kitahei88/SKGC-for-MZ-80B/8255_ATmegaX8/FUSE.md

## AVRのFUSE設定

**ATmega328p FUSE : Low, High, Extended.**
FUSES = {0xEE, 0xD9, 0xFF};		

```
Low
    CKDIV8      1       clock divide disable
    CKOUT       1       clock out disable
    SUT         10      high speed rising
    CKSEL       1110    Ext Crystal Osc.; Freq 8.0- Mhz; Start up time PWRDWN/RESET: 1K CK /14 CK + 0ms;

High
    RSTDIBL     1       PC6 to reset
    DWEN        1       Debug wire disable
    SPIEN       0       SPI programing enable
    WDTON       1       WDT disable
    EESAVE      1       EEPROM is erasable
    BOOTSZ      00      Boot loader size set to 2048 words :: default
    BOOTRST     1       Reset vector set to application section
Ext
    7~3         not use (set 1)
    BODLEVEL    111     Brownout reset disable	
```

**外部にXtalオシレーターを使用するため、書き込みはExtended, High, Lowの順で行うこと**
