kitahei88/SKGC-for-MZ-80B/Doc/ModeOut.md

# モード出力の設定について

現在のモードもしくは切り替えスイッチの出力を外部に出力するための設定を用意しています。
J6と書かれた2PinのXHコネクタで1ピンがGND、2ピンに状態が出力されます。
MZ-2000のモードでL（GND）、MZ-80BのモードでH（+5V）が出力されます。

この出力される内容はPL3と記載されたジャンパで出力する状態を変更します。
PL3をSW側と中央をショートした場合、スイッチの状態が出力されます。
つまりIPL動作、メインRAMでのブート中などに関わらず、スイッチで指定したモードの状態が出力されるということです。

逆にPL3をB/_2000側でショートした場合、IPLの設定とIPL中かメインRAMの動作中かにより、出力される状態が変化します。
MZ-2000にスイッチを設定し、IPLはMZ-80Bで起動した場合、IPL中はMZ-80BとしてHが出力され、メインRAMに動作が変更した後はMZ-2000としてLが出力されます。
IPLをMZ-80BとMZ-2000との両方を切り換えるものとした場合は、上記したようなスイッチの出力がそのまま出力されることになります。

主にyanatakaさんのSDカードブートするものを使うことを想定ています。
ですので具体的には
#### 1. IPLはMZ-80Bのもので、起動後にMZ-2000、MZ-80Bが切り替わる設定（BIOSにMZ-2000などを用意しない場合）

IPLの設定はオープン、モード出力の設定はB/_2000側をショートの状態とする
yanatakaさんの基板、ブートROMとしては、Rev4.3以上のもの（スイッチで27C512
のA15を切り換えることができるもの）とブートROMとして27C512を使用。

ブートROMのイメージとしては、MONITORは何れもMZ-80Bの改造したもの。
その後ろにつけるバイナリは、1つはEXT-ROM_SD MZ-2000.bin、もう一はEXT-ROM_SD MZ-80B.binとする
下位はMZ-2000.binを用意したもの、上位はMZ-80Bを用意したものとして27C512書き込む。

切り替えスイッチの出力にこの状態でモード設定の出力を入れる

#### 2. IPLをMZ-80B、MZ-2000のものをそれぞれ用意した場合

その場合はIPLの設定をショートにてして、モード出力はSW側とします。
そしてSDカードのローダー側は通常の場合と同様にMZ-2000のものとMZ-80Bのものを用意し、下位はMZ-2000、上位はMZ-80Bのもので作成したバイナリを27C512に書き込んで使用します。

モードの入力する方法は１と同様です。
