kitahei88/SKGC-for-MZ-80B/Doc/images/TC9121P/TC9121P_5.jpg

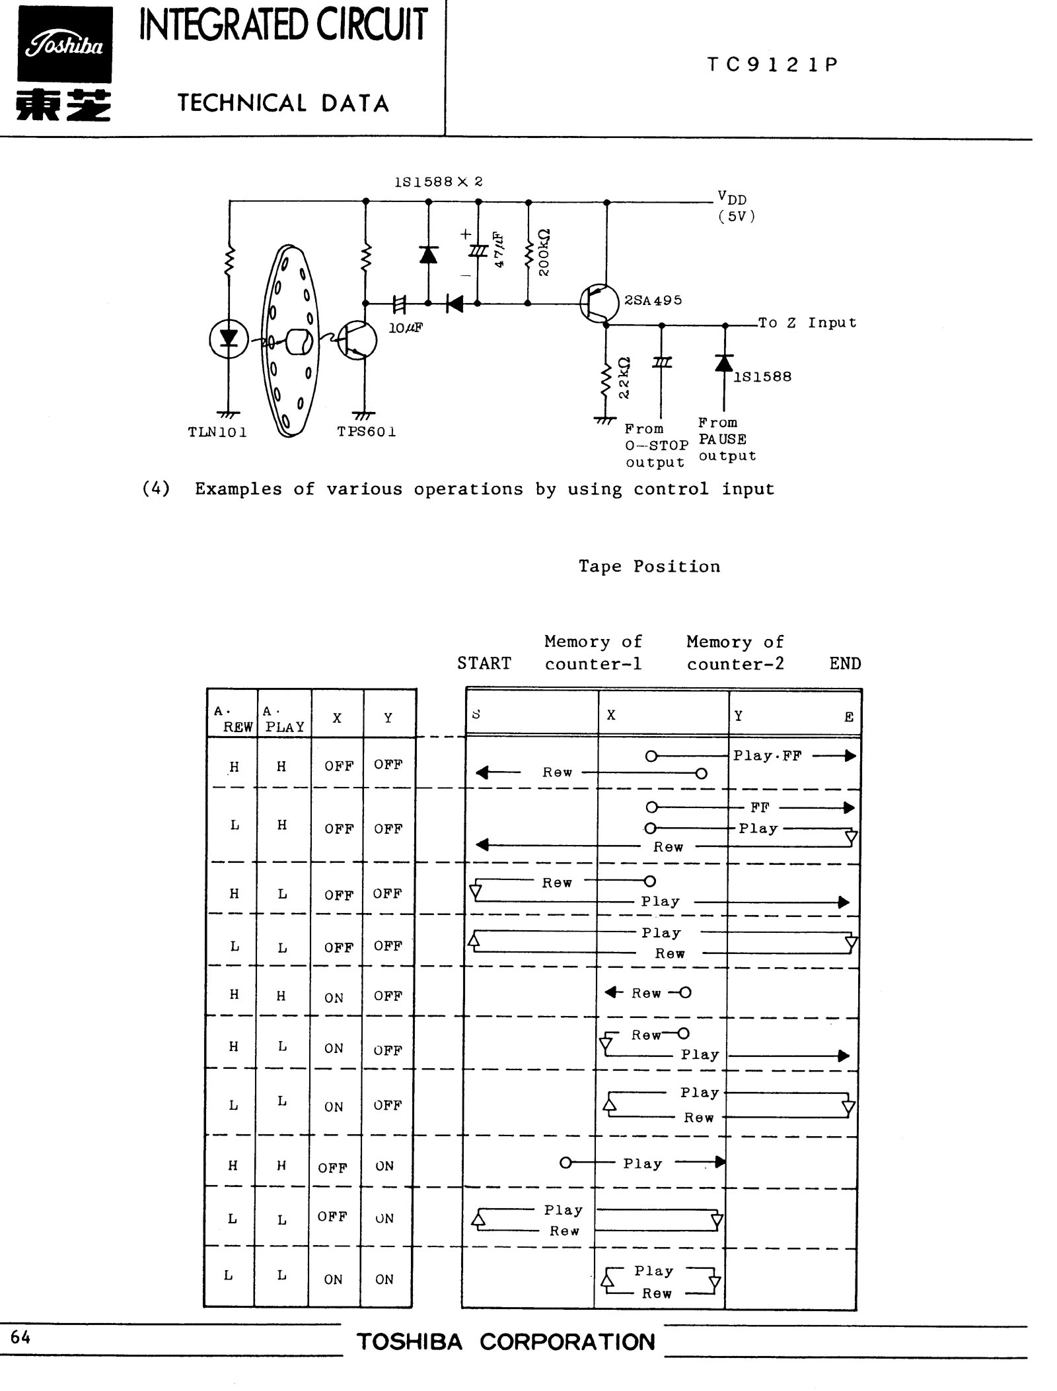
Doc/images/TC9121P/TC9121P_5.jpg
