kitahei88/SKGC-for-MZ-80B/Doc/HowToInstall.md

# 取り付け方法 
頒布したセットの取り付け方法を記載します。画像はクリックすると別タブで大きい画像で表示されます。

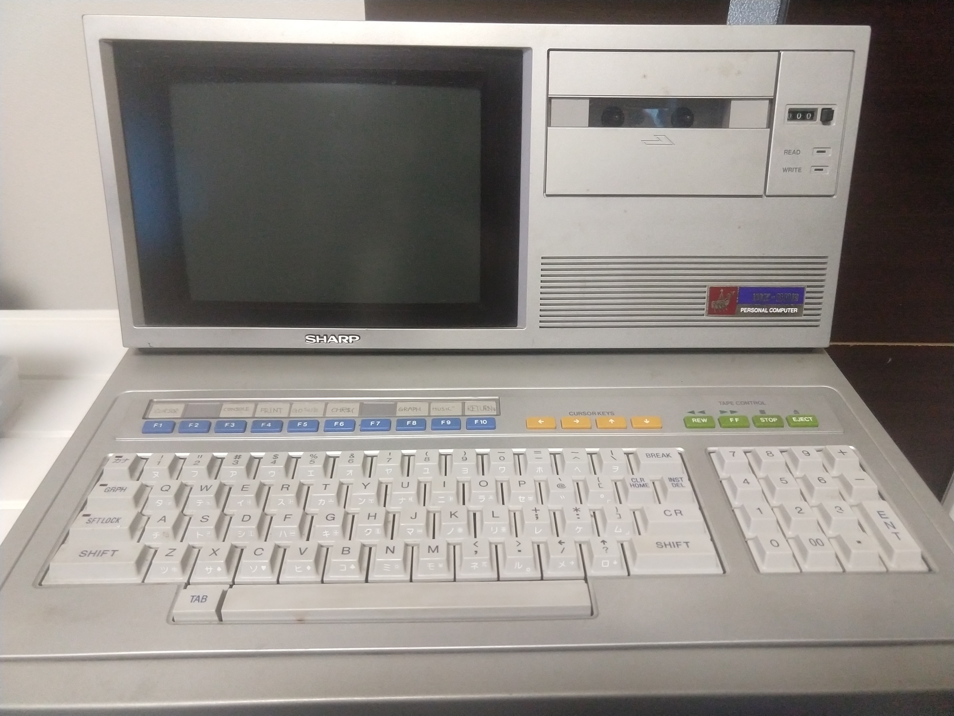
[picture p10: Doc/images/1.jpg]


まずMZ-80B本体の電源を確実に切り、電源ケーブルを外してください。

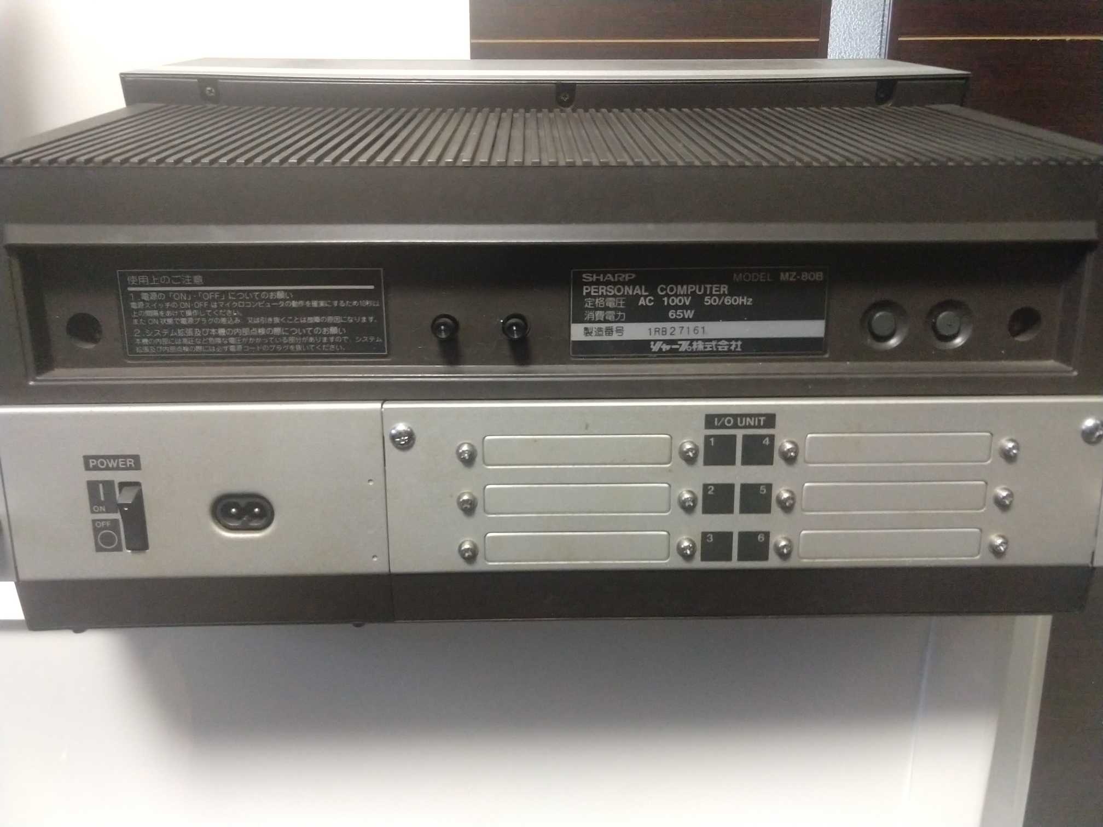
[picture p11: Doc/images/2.jpg]


次に背面二ヶ所のネジを外し、CMTとモニター部分を上方へ押し上げ、本体をあけます。

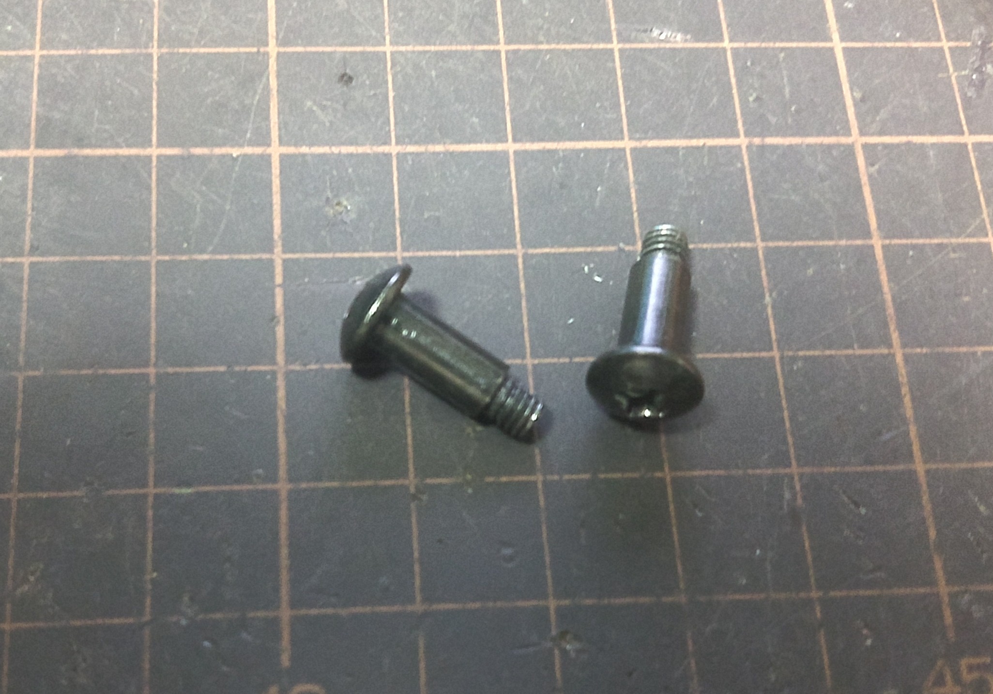
[picture p12: Doc/images/3.jpg]
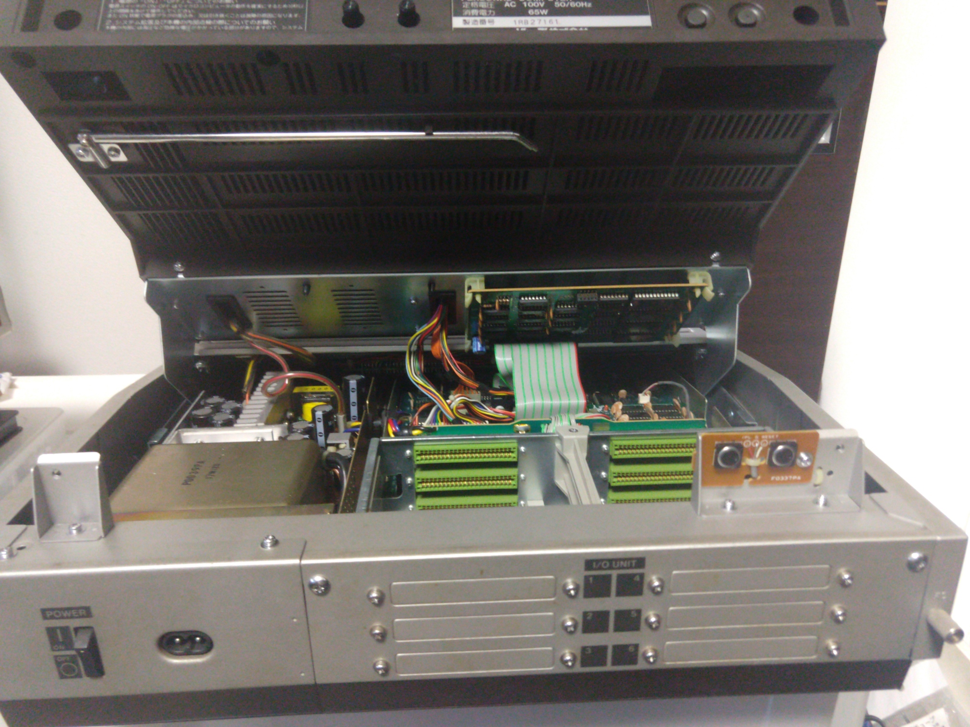
[picture p13: Doc/images/4.jpg]


CMTとモニター部分のカバーを5箇所のネジを外して開けます。

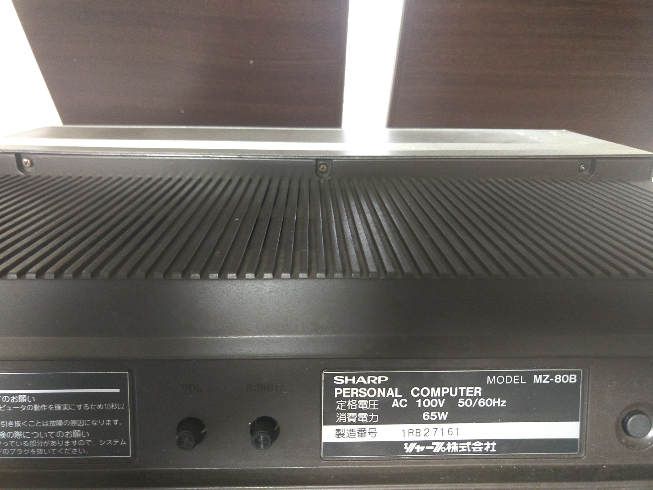
[picture p14: Doc/images/5.jpg]
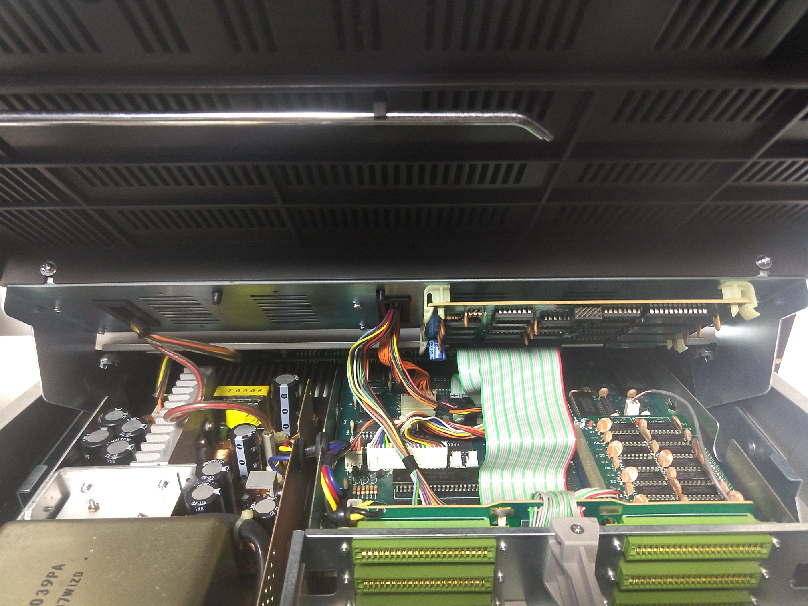
[picture p15: Doc/images/6.jpg]
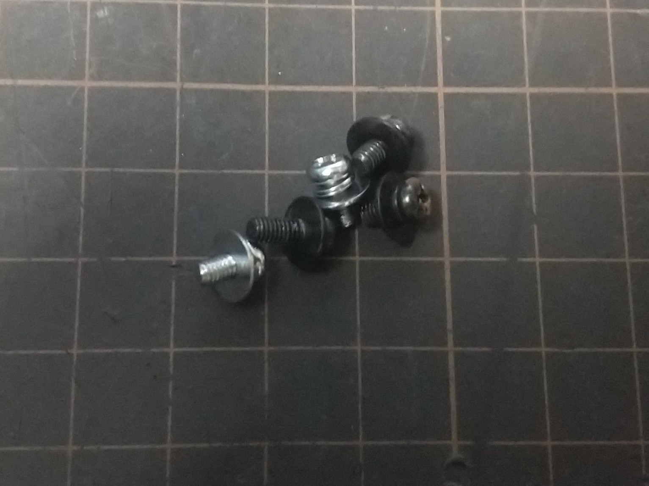
[picture p16: Doc/images/7.jpg]


この際、モニター周囲は高圧が掛かっている可能性が高く、注意してください。最悪、指に穴が空きます。

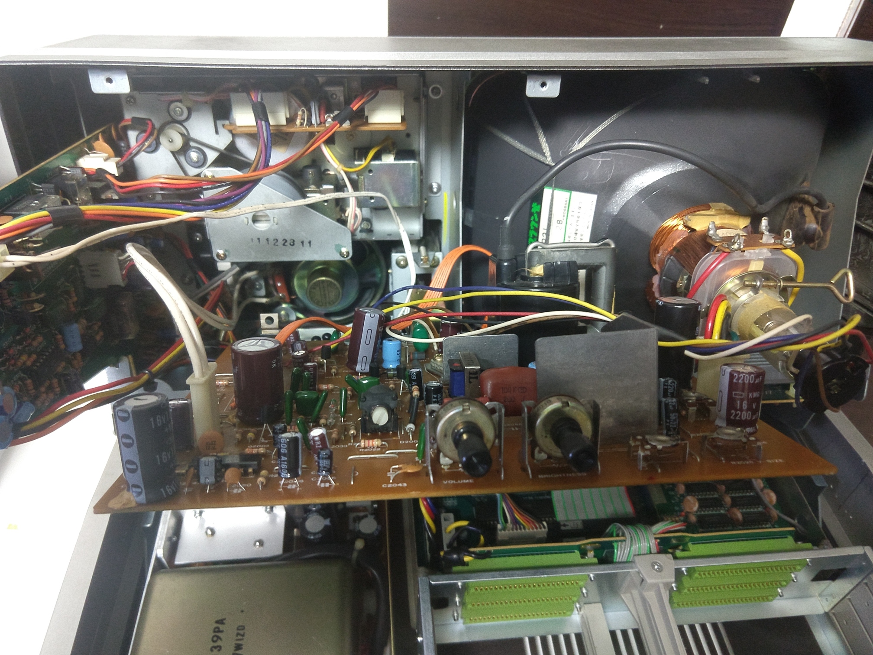
[picture p17: Doc/images/8.jpg]


写真にあるCMT制御基板のコネクターを外します。これはテープカウンターの動作信号が入ってくるところで、これでテープが回転しているかを入力しています。

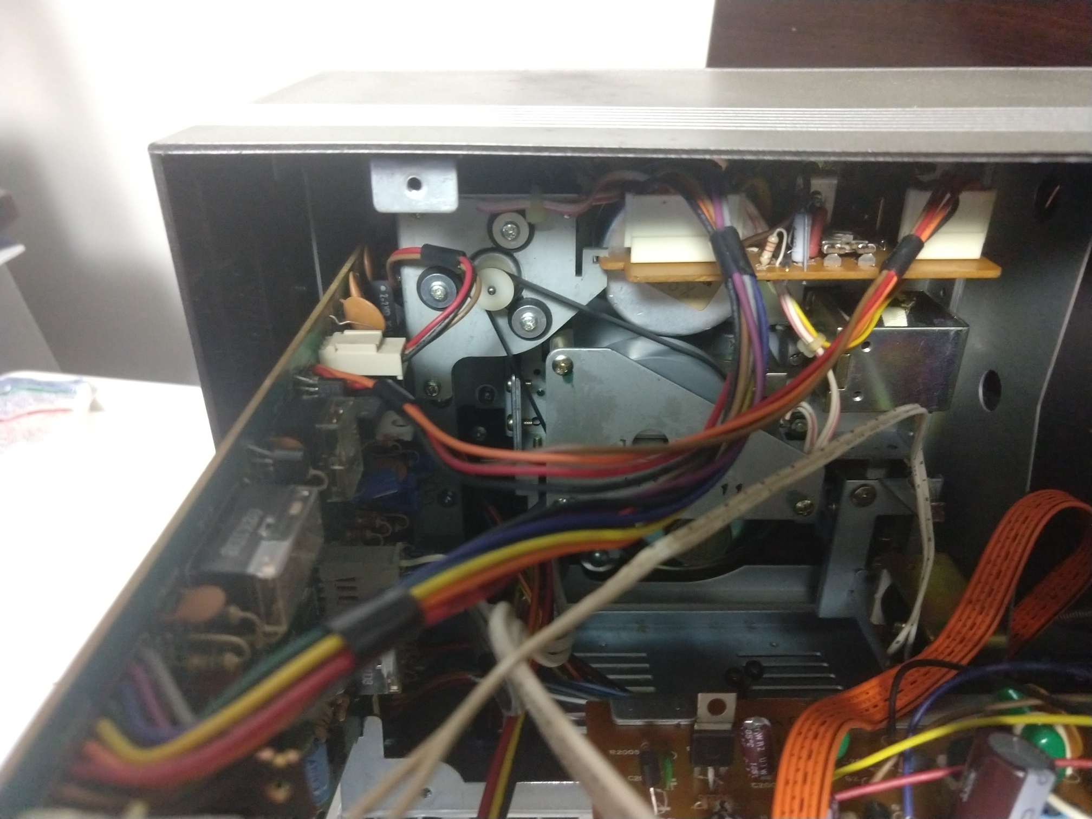
[picture p18: Doc/images/9.jpg]
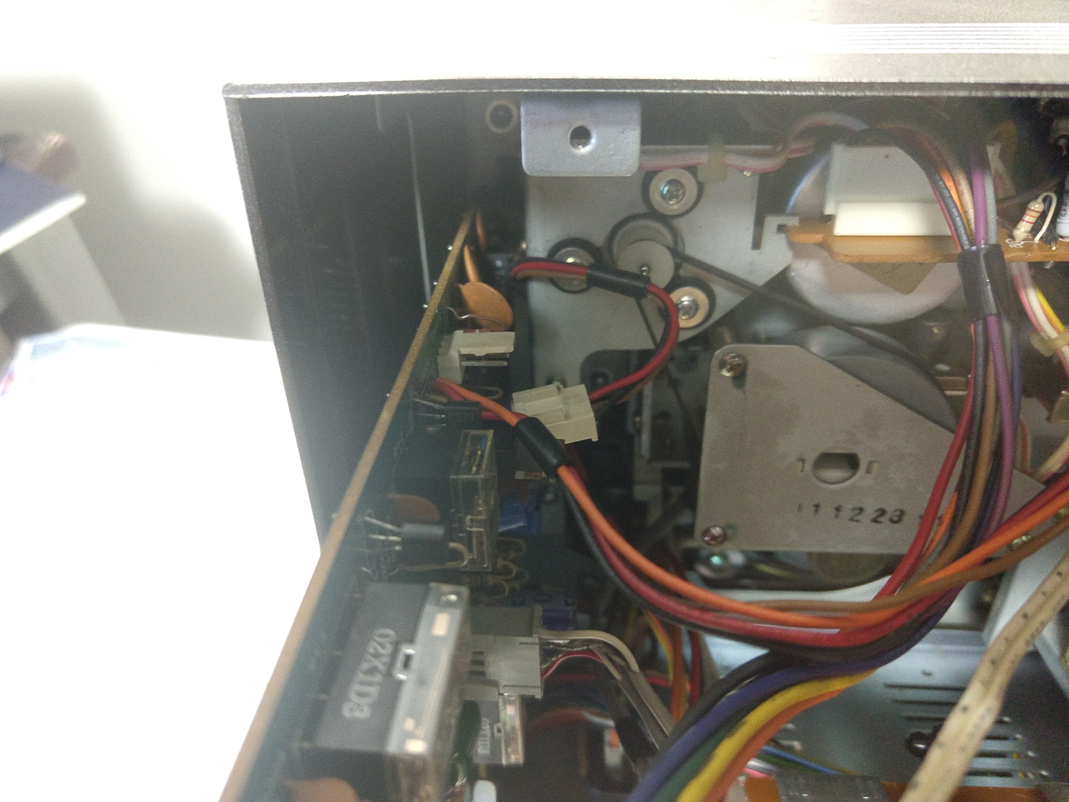
[picture p19: Doc/images/10.jpg]


ここにセットのケーブルをつけて取り込みます。

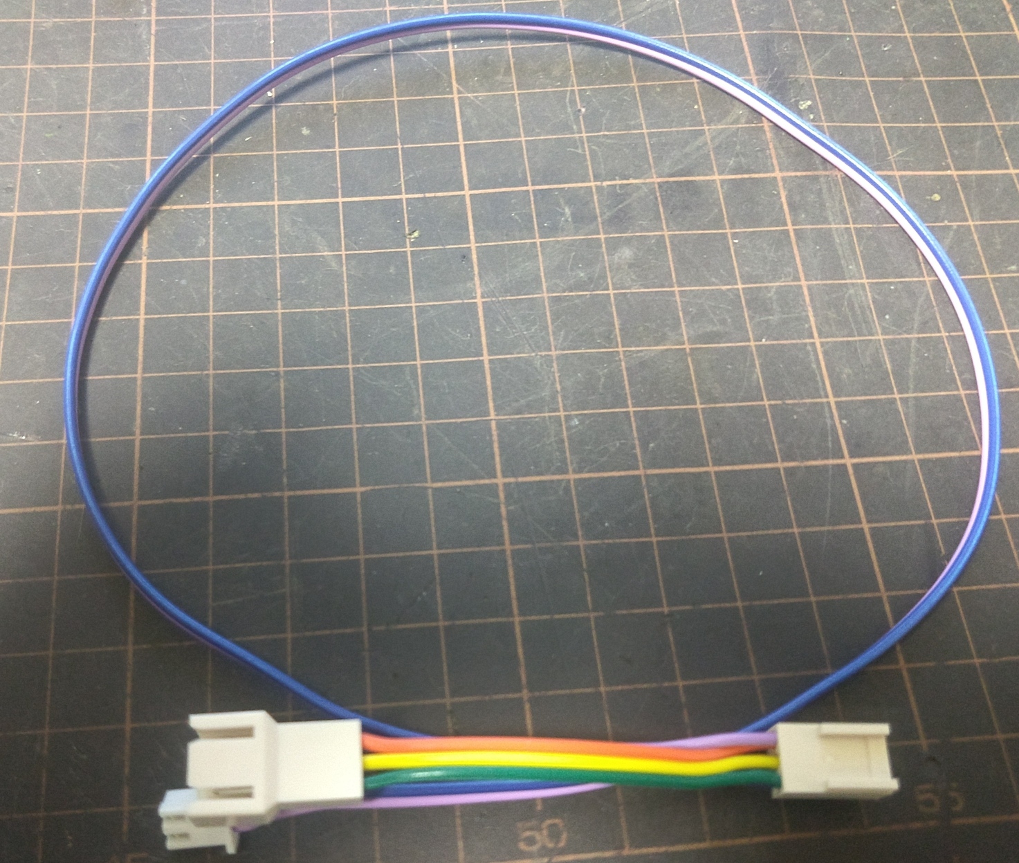
[picture p20: Doc/images/11.jpg]
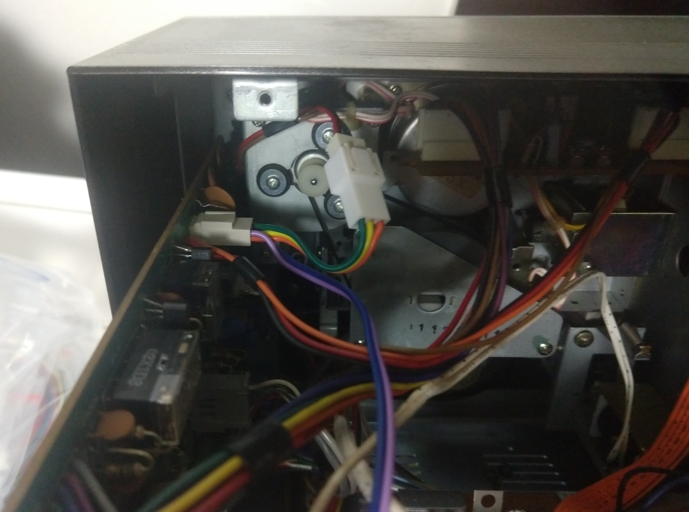
[picture p21: Doc/images/12.jpg]
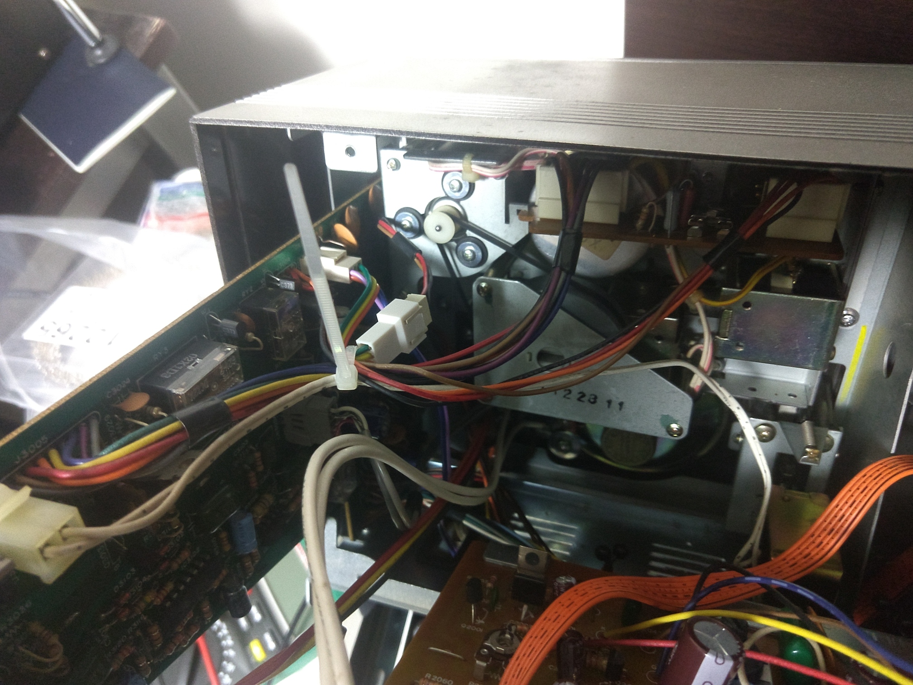
[picture p22: Doc/images/13.jpg]


ケーブルはCMT基板のすぐ下にある、電源からのコードが通じている穴を通して、メインのマザーボード側へ誘導します。

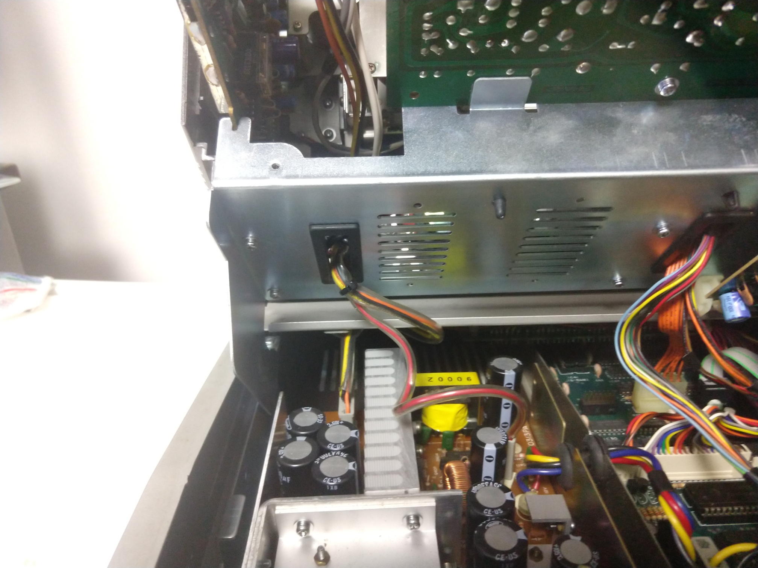
[picture p23: Doc/images/14.jpg]
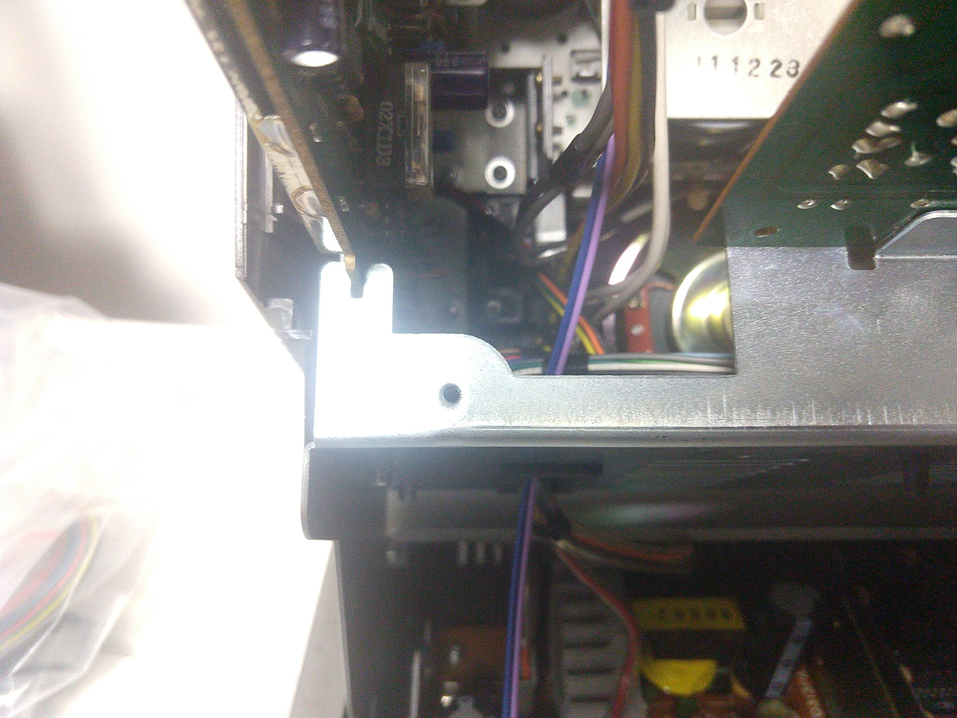
[picture p24: Doc/images/15.jpg]
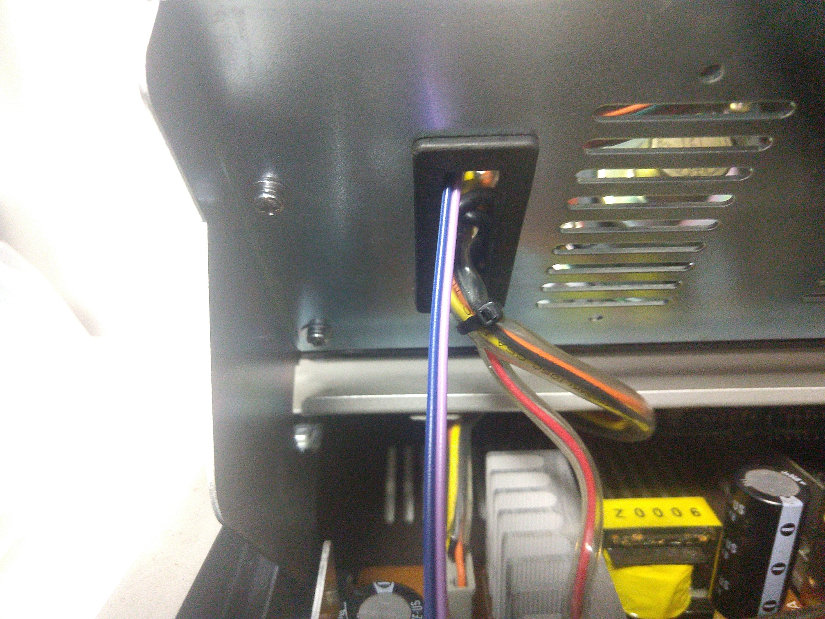
[picture p25: Doc/images/16.jpg]
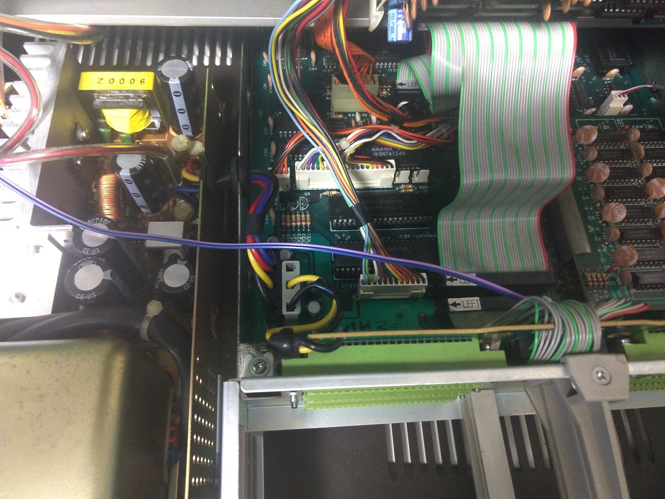
[picture p26: Doc/images/17.jpg]


この段階でCMTとモニター部分のカバーを元通り取り付けます。ネジで止めても問題ありません。

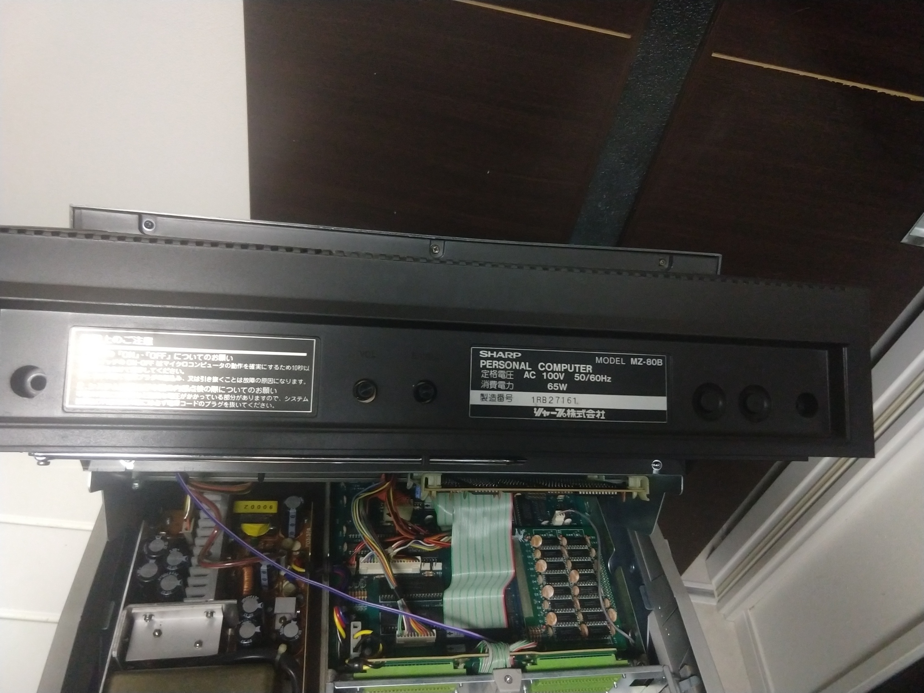
[picture p27: Doc/images/18.jpg]
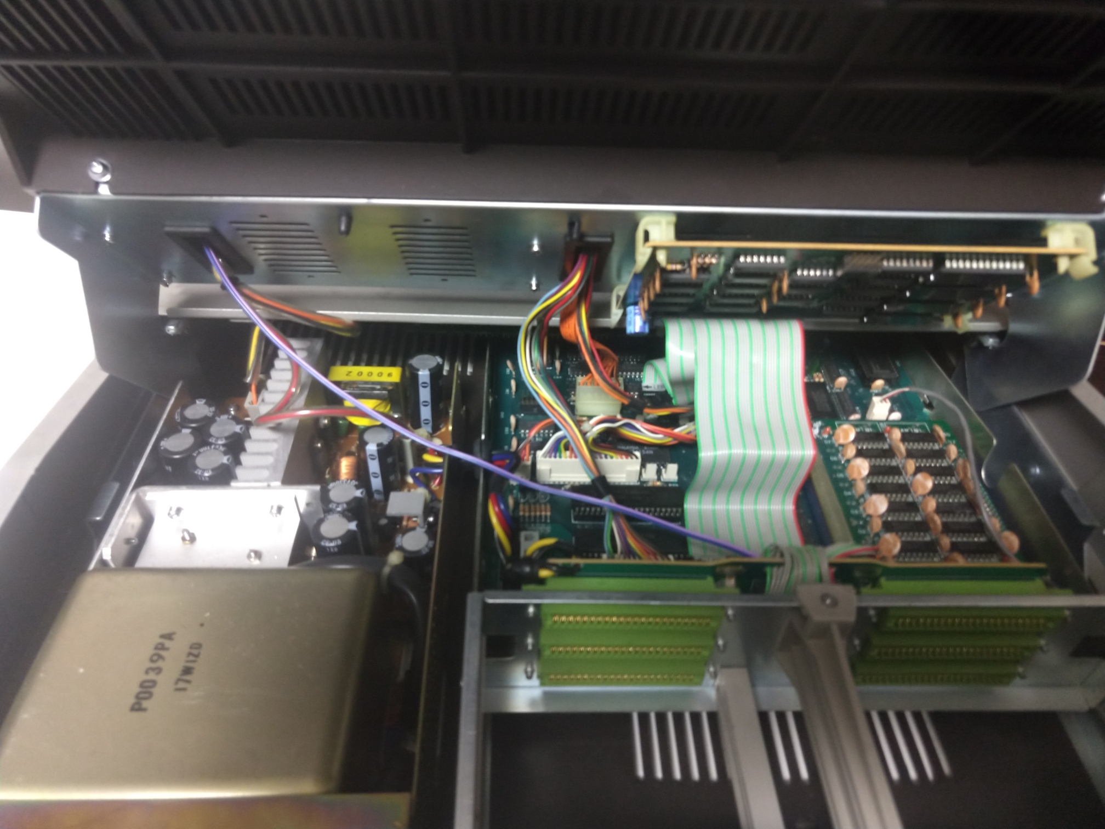
[picture p28: Doc/images/19.jpg]


次にマザーボード側の取り付けを行います。
拡張I/OボードのMZ-8BKが取り付けられている場合、これを外さないとマザーボードが取り外せません。
まず、拡張I/Oボード背面のパネルを取り外します。

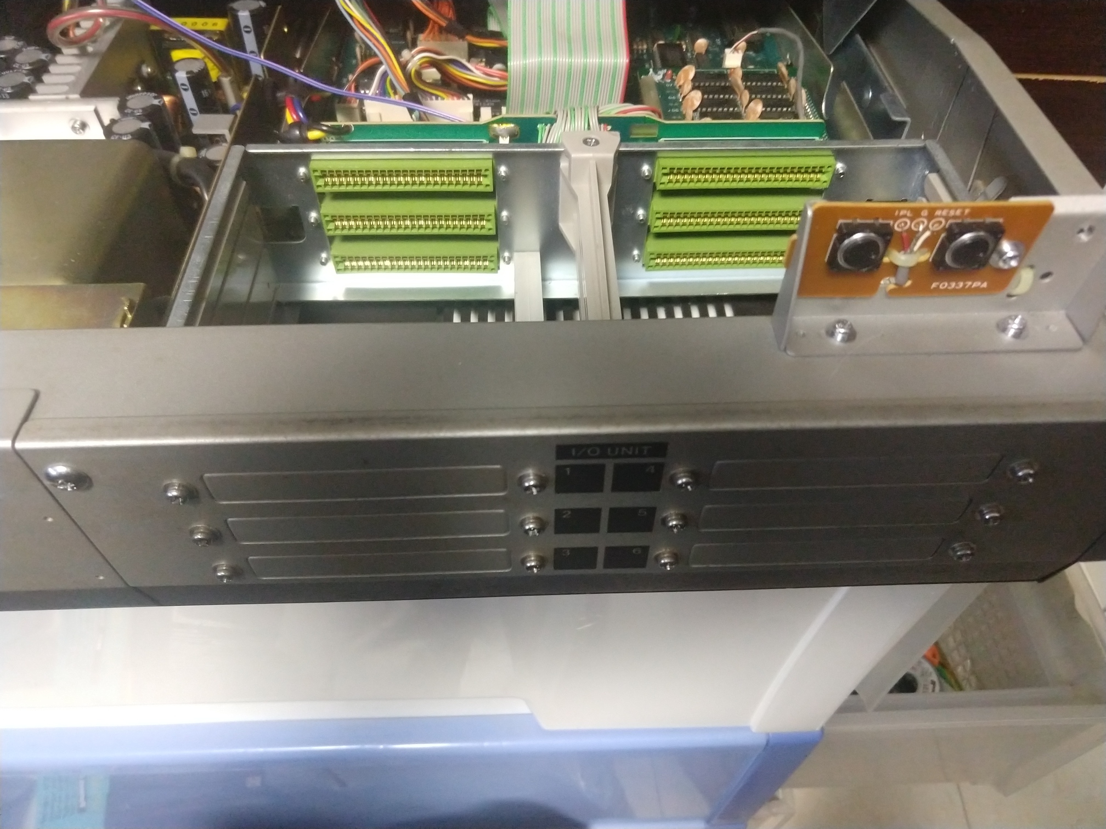
[picture p29: Doc/images/20.jpg]
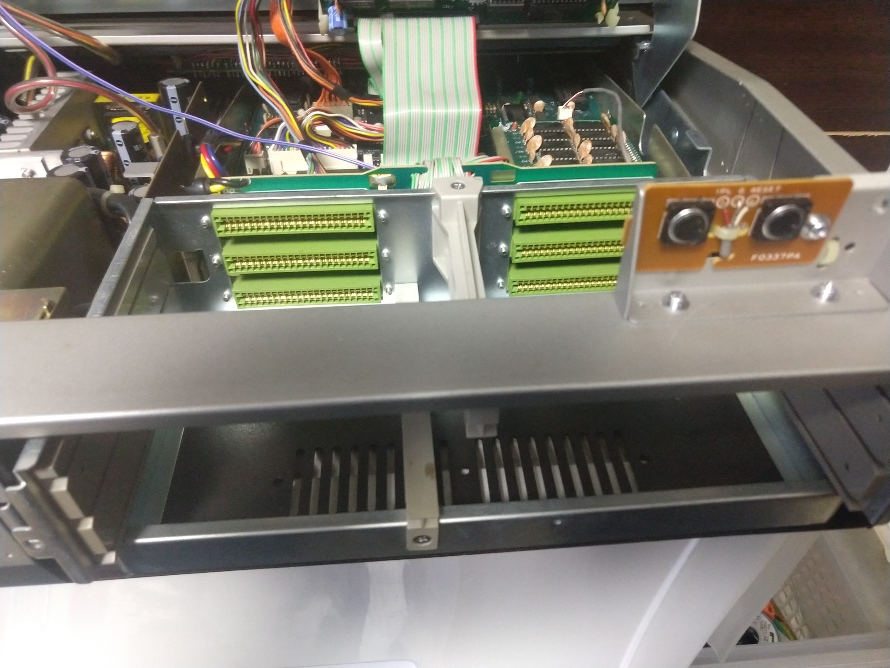
[picture p30: Doc/images/21.jpg]


次に拡張I/Oボード用の電源を引き抜き、マザーボードと固定されているネジを取り外して引き抜きます。

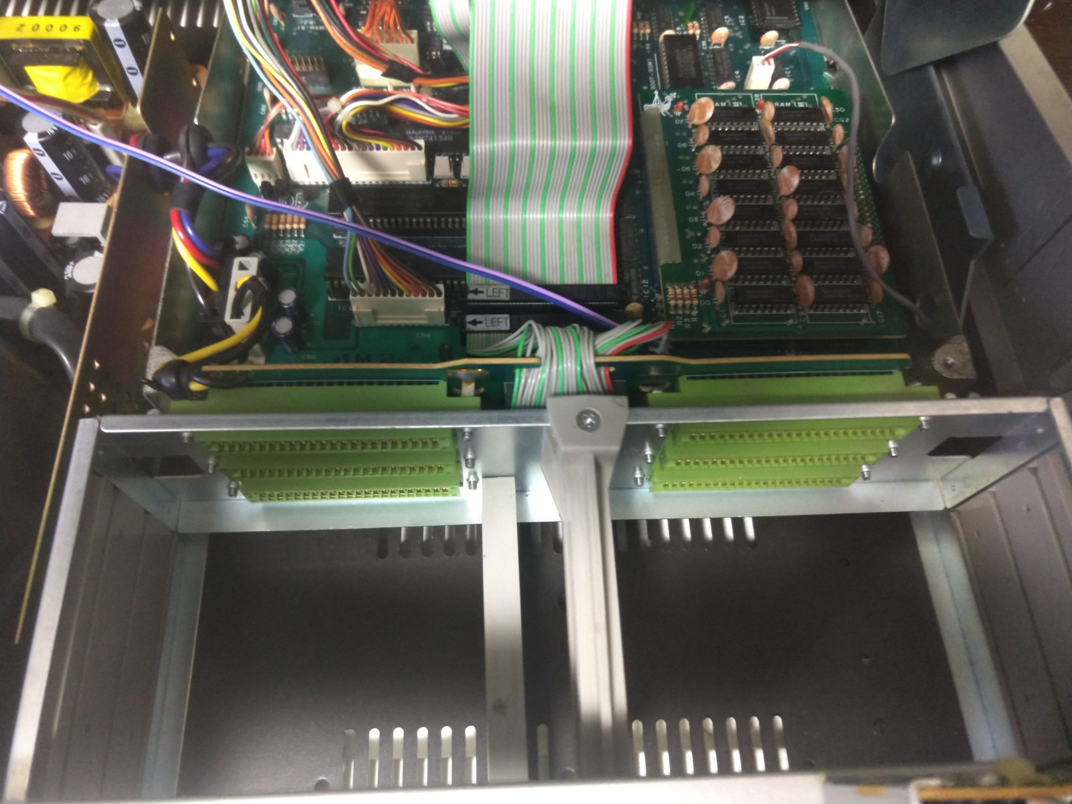
[picture p31: Doc/images/22.jpg]
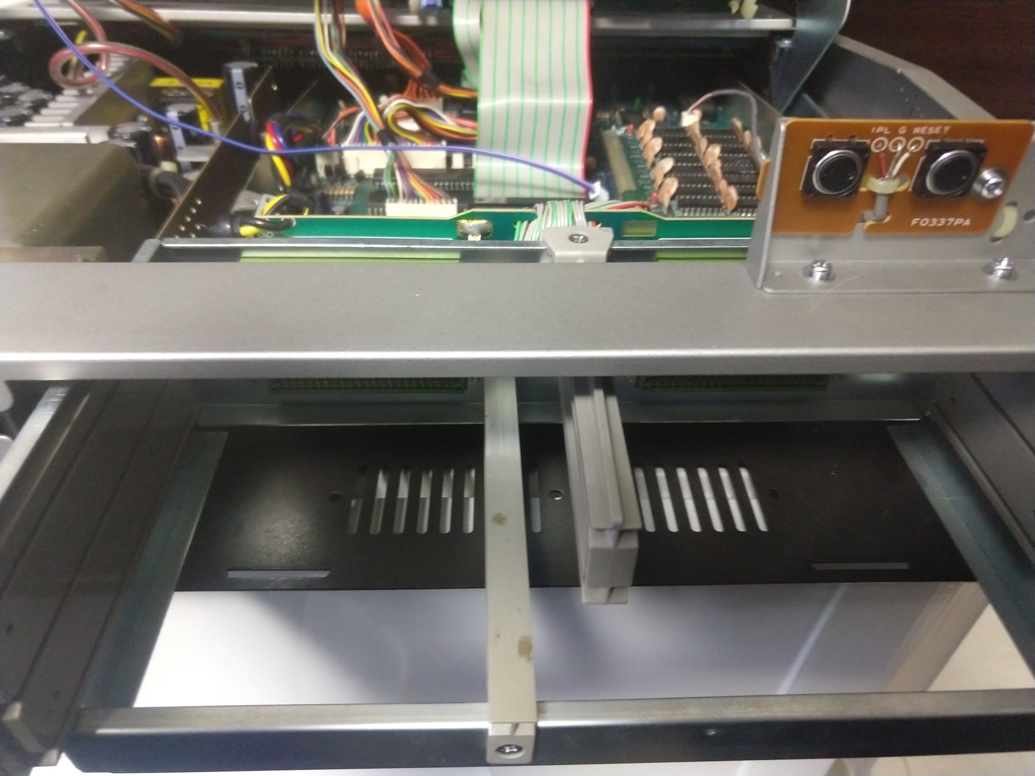
[picture p32: Doc/images/23.jpg]
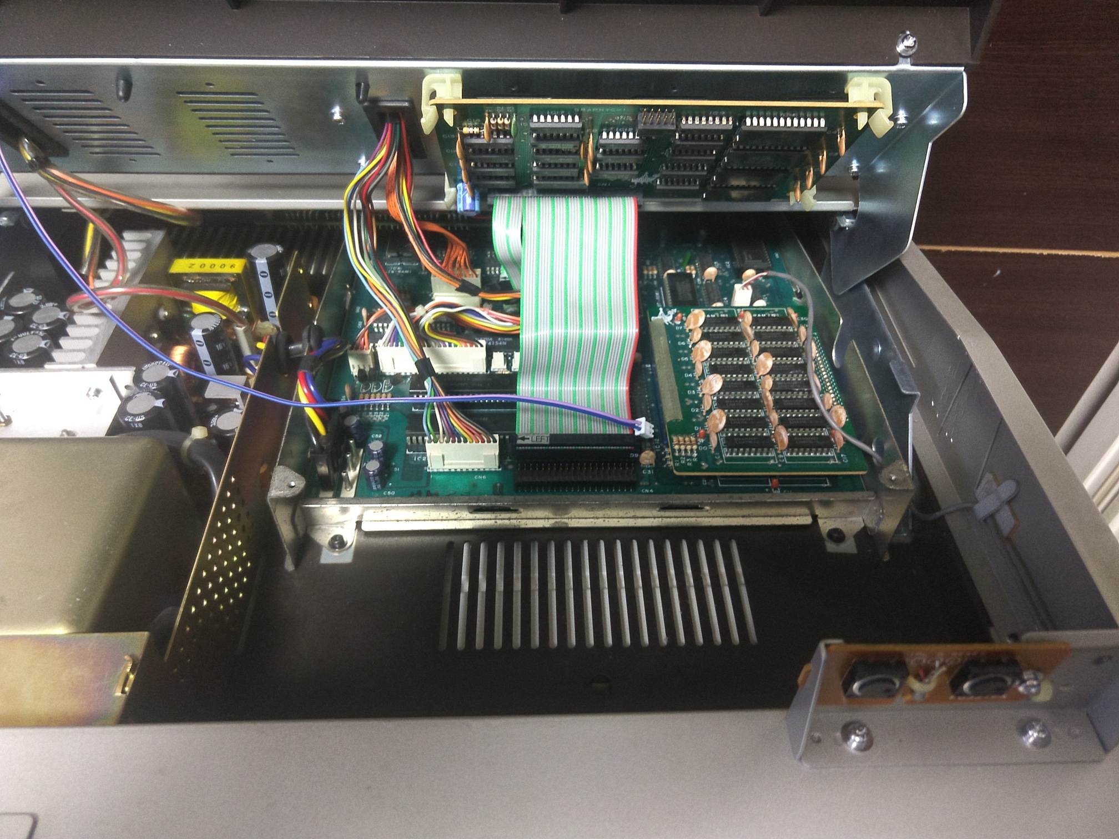
[picture p33: Doc/images/24.jpg]


マザーボードを取り外します。
マザーボードから伸びている、電源コード、CMT、キーボード、CMTコントロールボタン、リセット、ディスプレイ信号などのケーブルをすべて取り外します。取り外しには力が必要だったり、爪で固定されているなどしているので、上手く外してください。

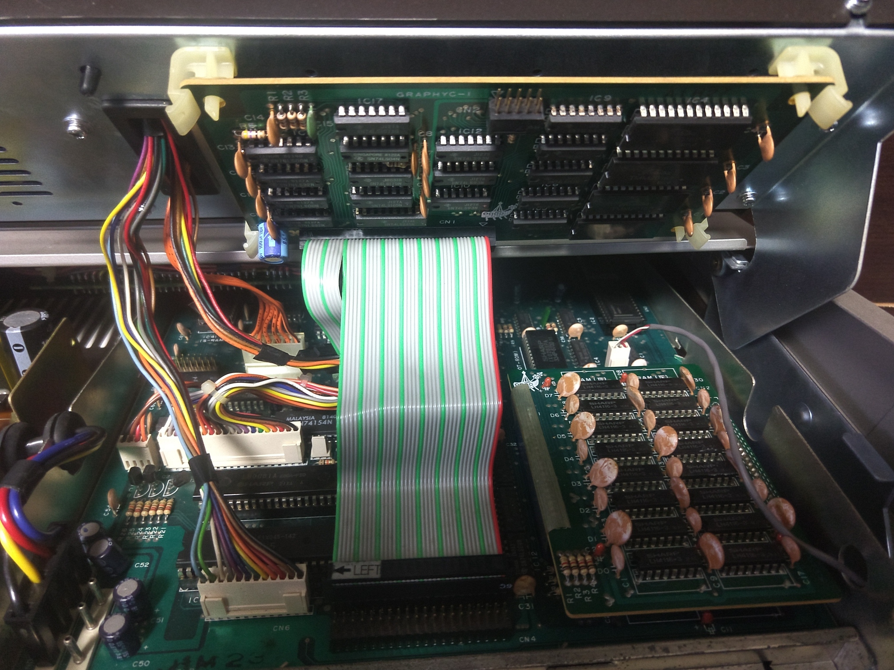
[picture p34: Doc/images/25.jpg]
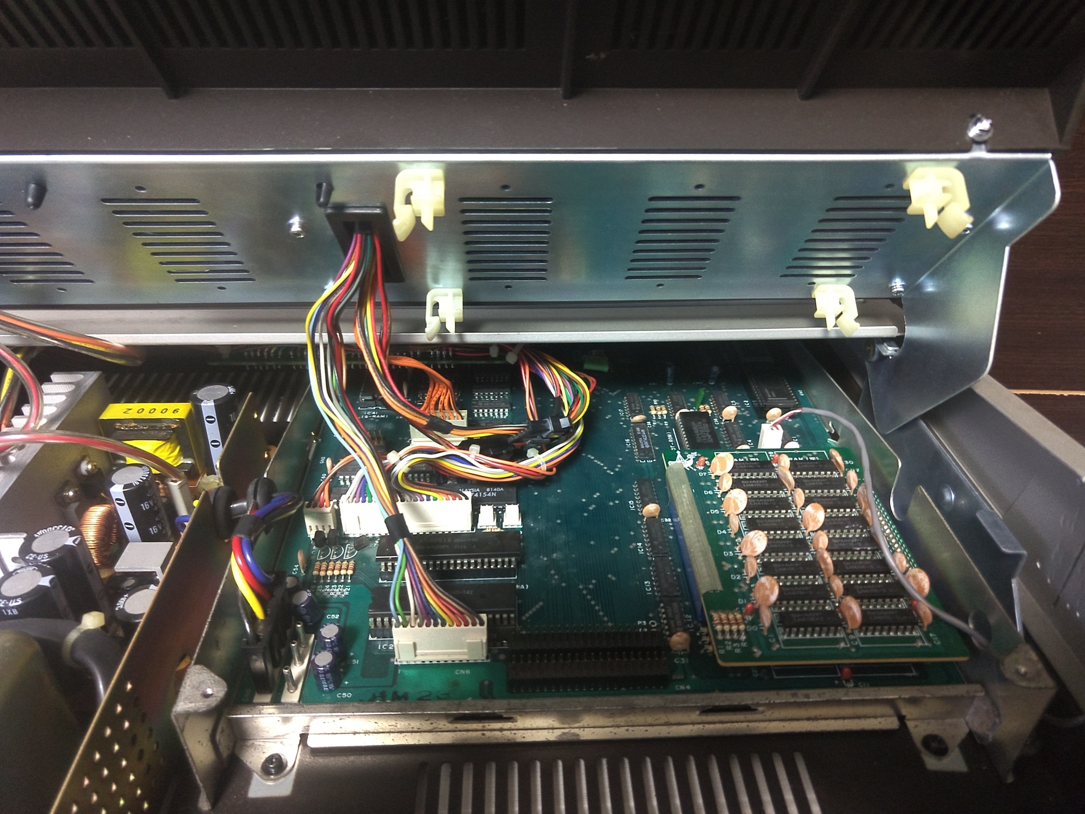
[picture p35: Doc/images/26.jpg]
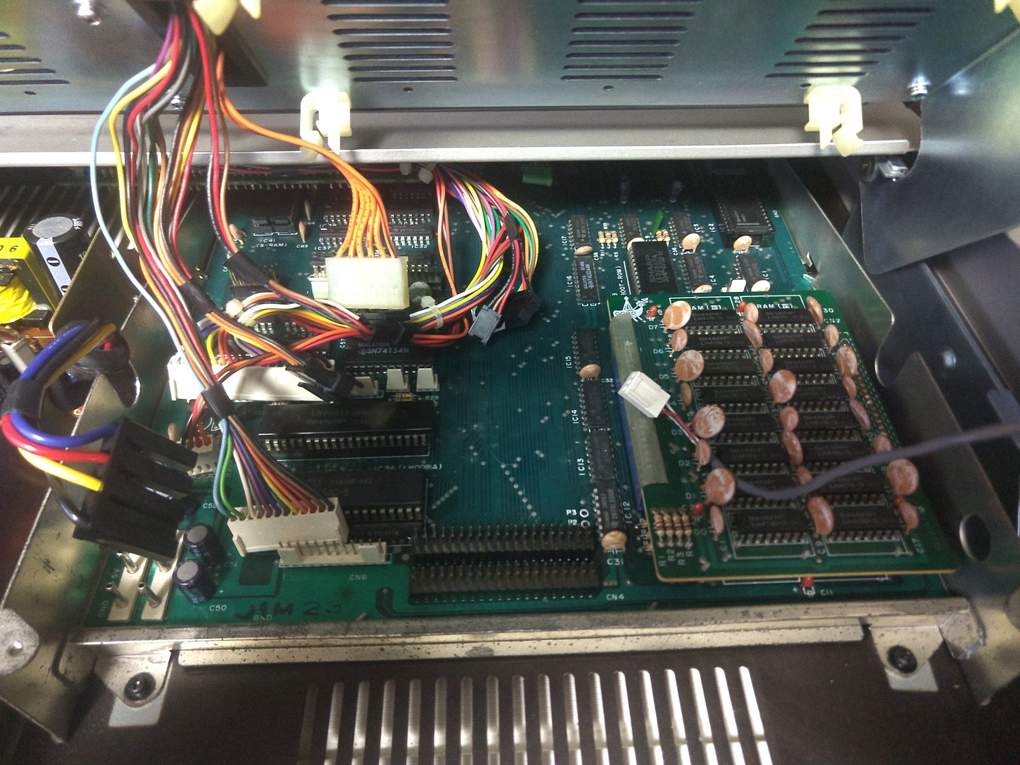
[picture p36: Doc/images/27.jpg]


次にマザーボードと背面のパネルを固定してる2箇所のネジを取り外します。

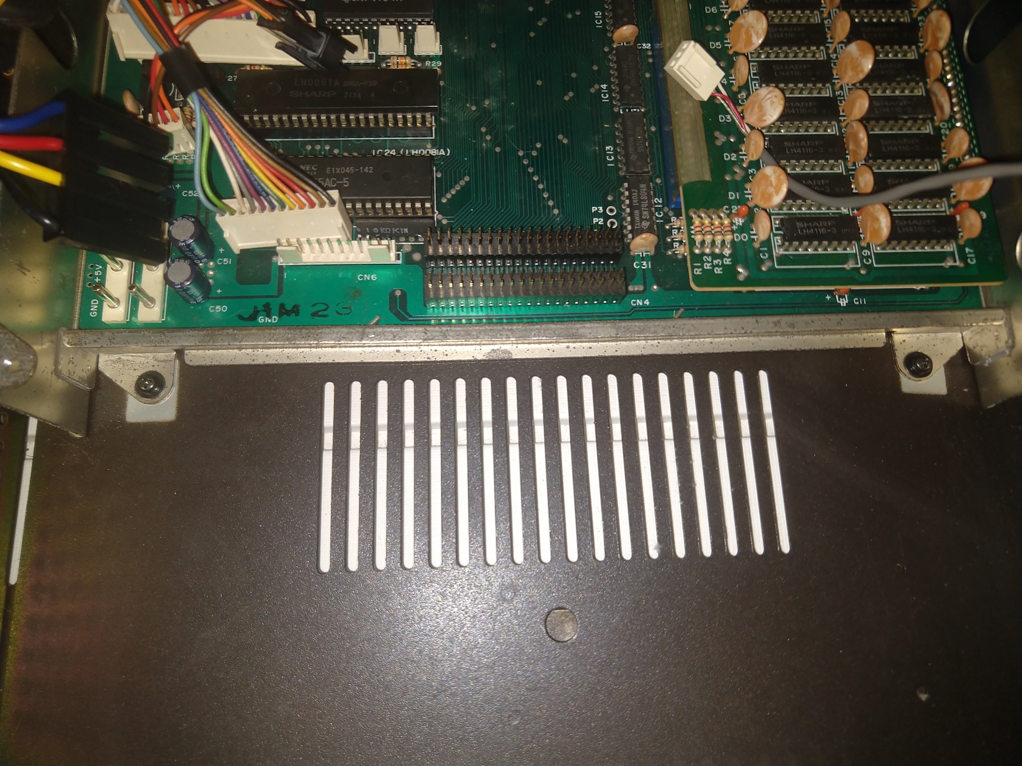
[picture p37: Doc/images/28.jpg]
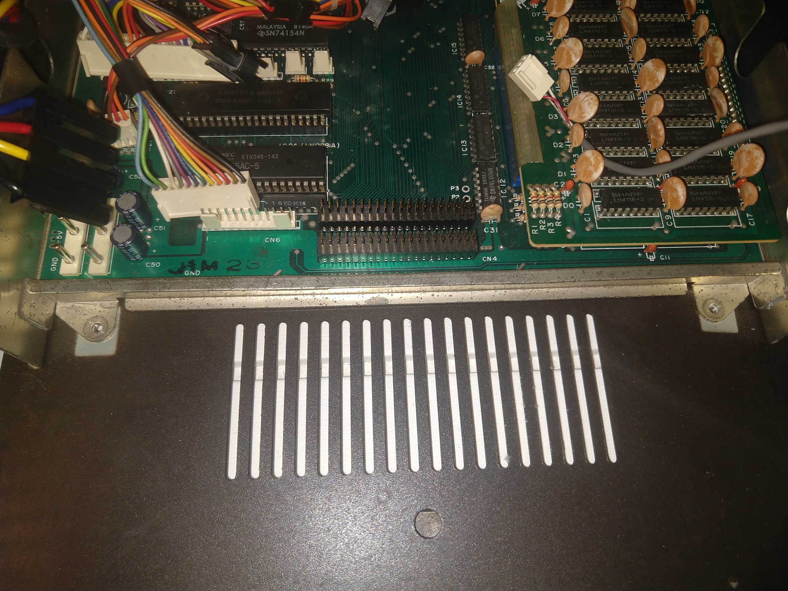
[picture p38: Doc/images/29.jpg]


そうすることで、マザーボードを背面にスライドさせることで取り外すことができます。

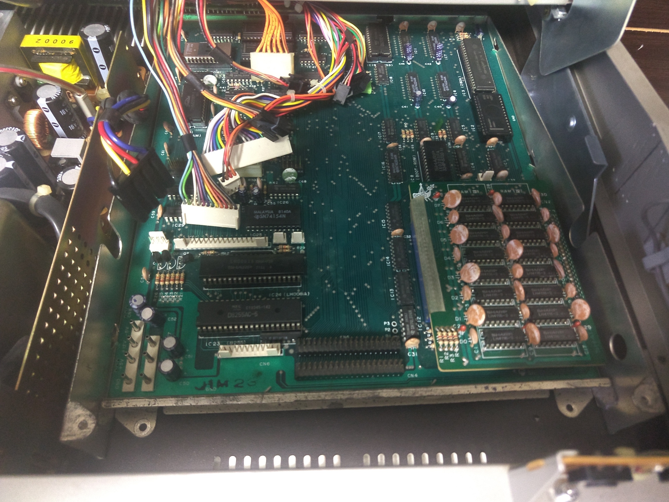
[picture p39: Doc/images/30.jpg]
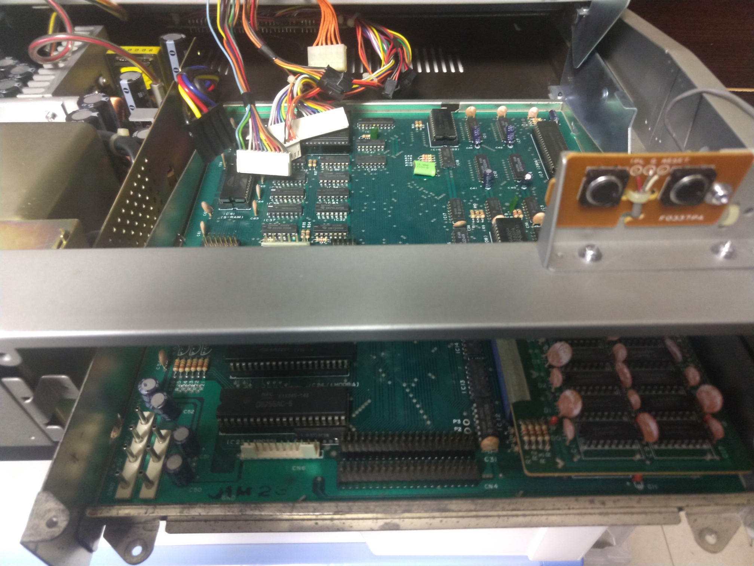
[picture p40: Doc/images/31.jpg]
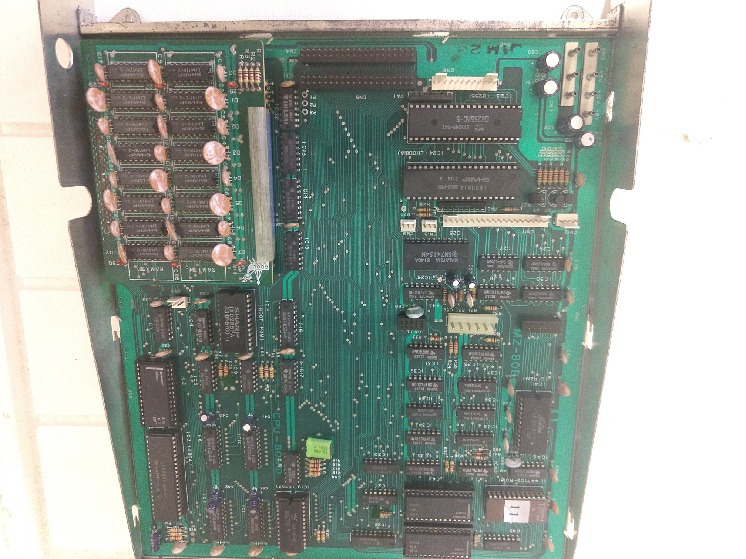
[picture p41: Doc/images/32.jpg]


マザーボードには以下の4枚のカードを取り付けます。

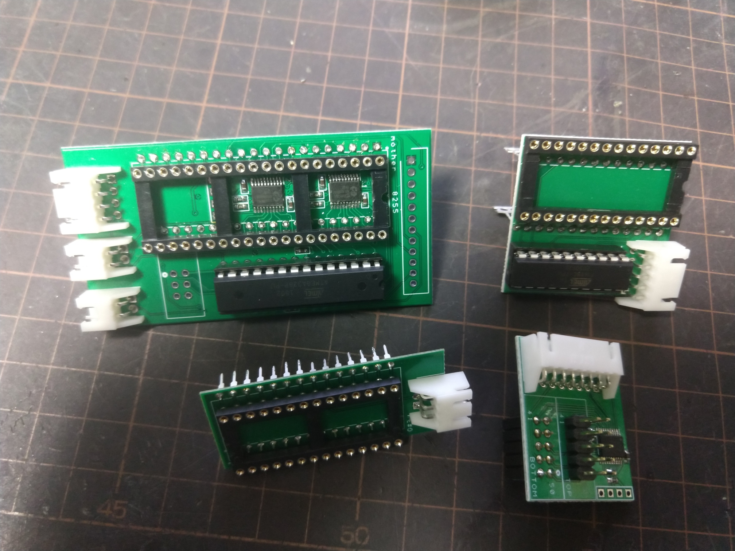
[picture p42: Doc/images/33.jpg]


***
*IPL起動時からMZ-2000として起動する基板も追加する場合は*
*この斜体の項目を追加してください*
*もう一つある、こちらの基板をIC8 BOOT-ROMの場所に取り付けます。*

*こちらには27C32などのEPROMにMZ-2000とMZ-80BのIPLをまとめて書き込んだものを取り付けます。*
*EPROMの詳細は[IPL.md](./IPL.md)を参照ください*

*こちらから2芯のケーブルを取り付けます。*
****

IC43 G#3にはこの基板を取り付けます。

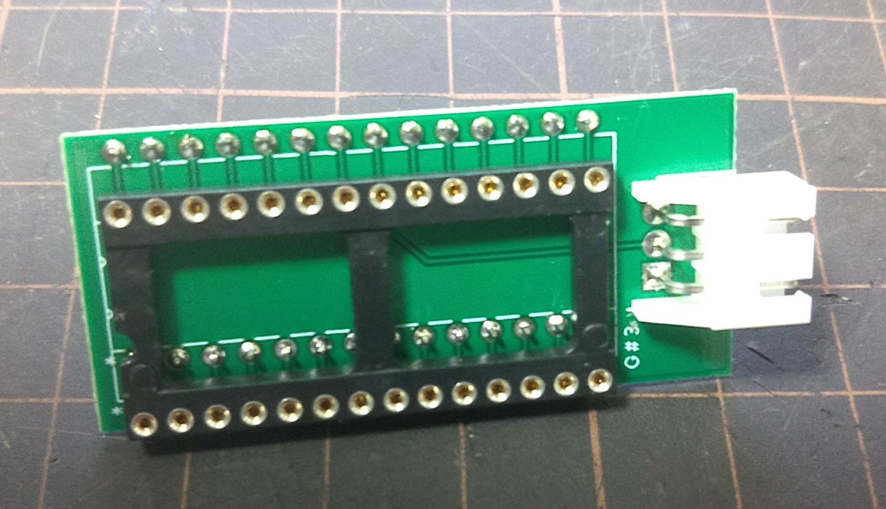
[picture p43: Doc/images/34.jpg]


まず該当のICを取り外してください。このとき、ピン曲がりや折れに注意してください。

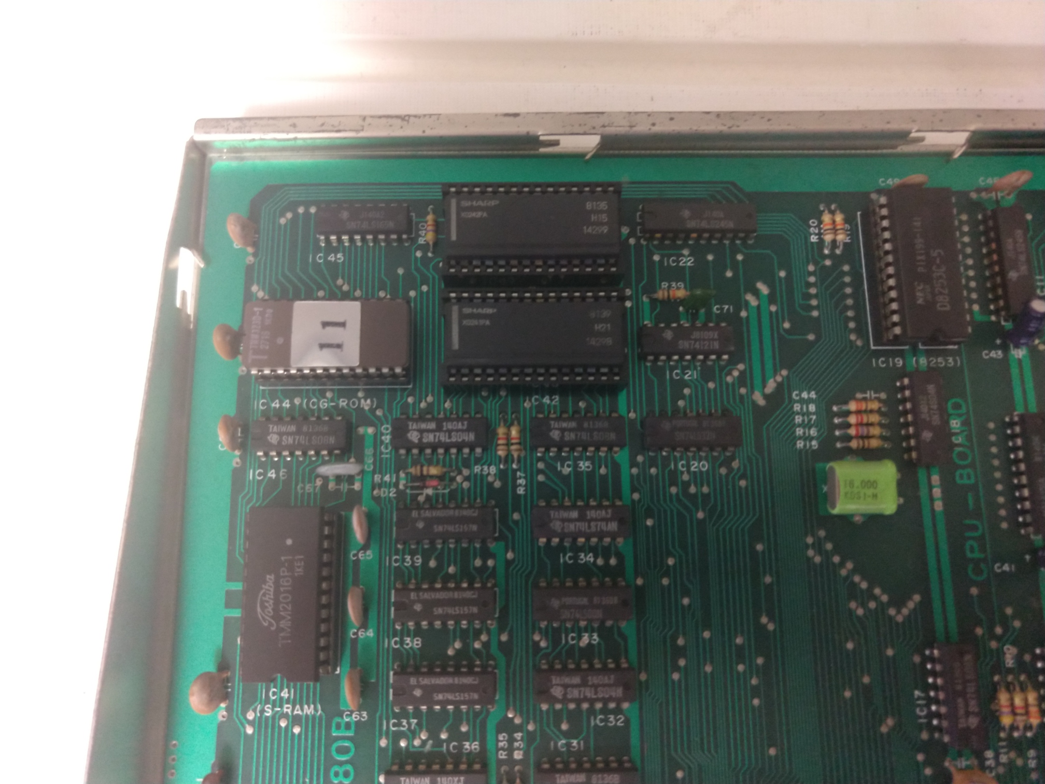
[picture p44: Doc/images/35.jpg]
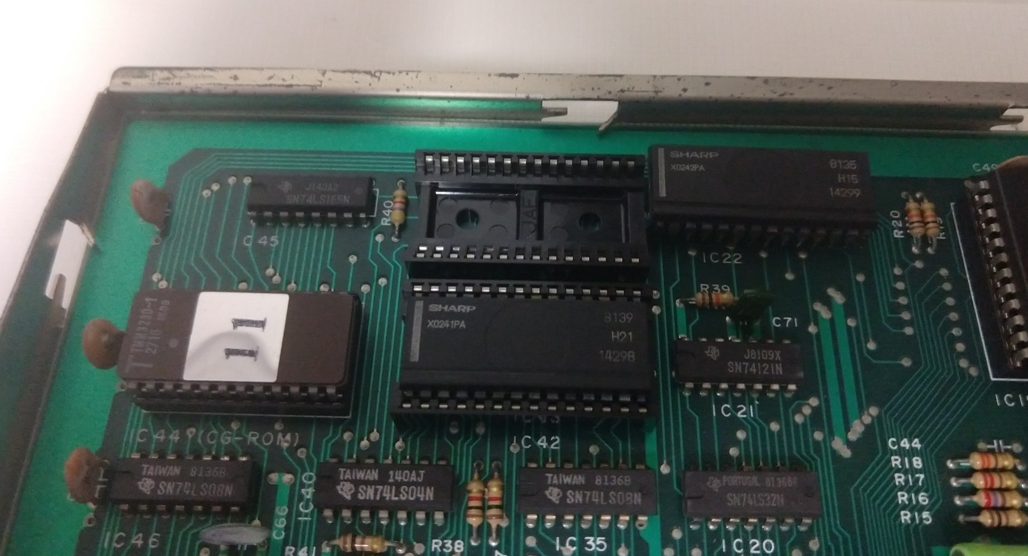
[picture p45: Doc/images/36.jpg]


基板を写真の向きで取り付け、ICをソケットにはめ込みます。

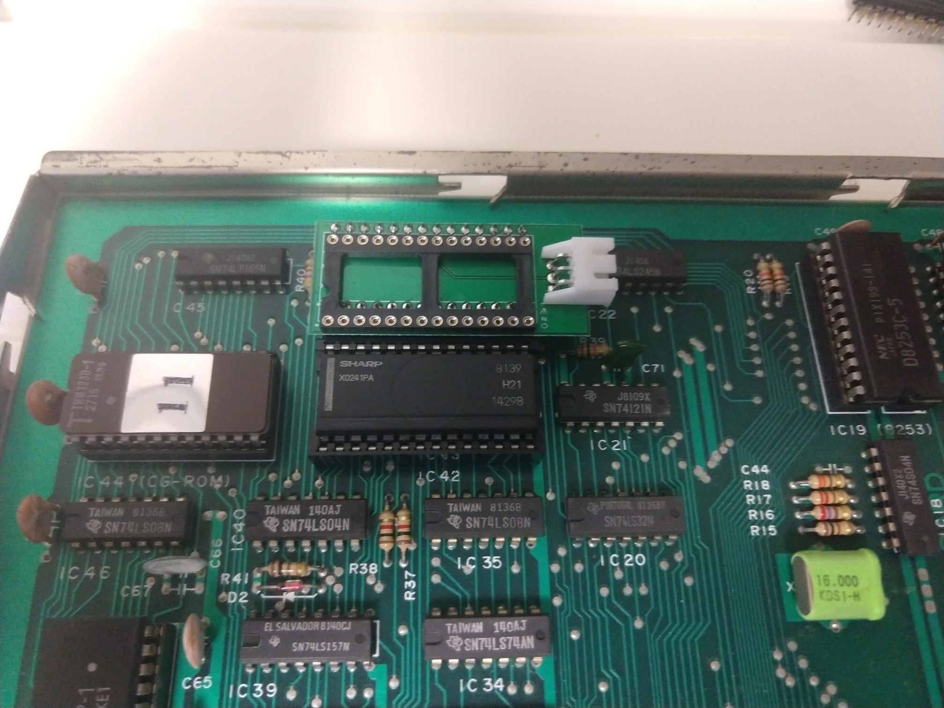
[picture p46: Doc/images/37.jpg]
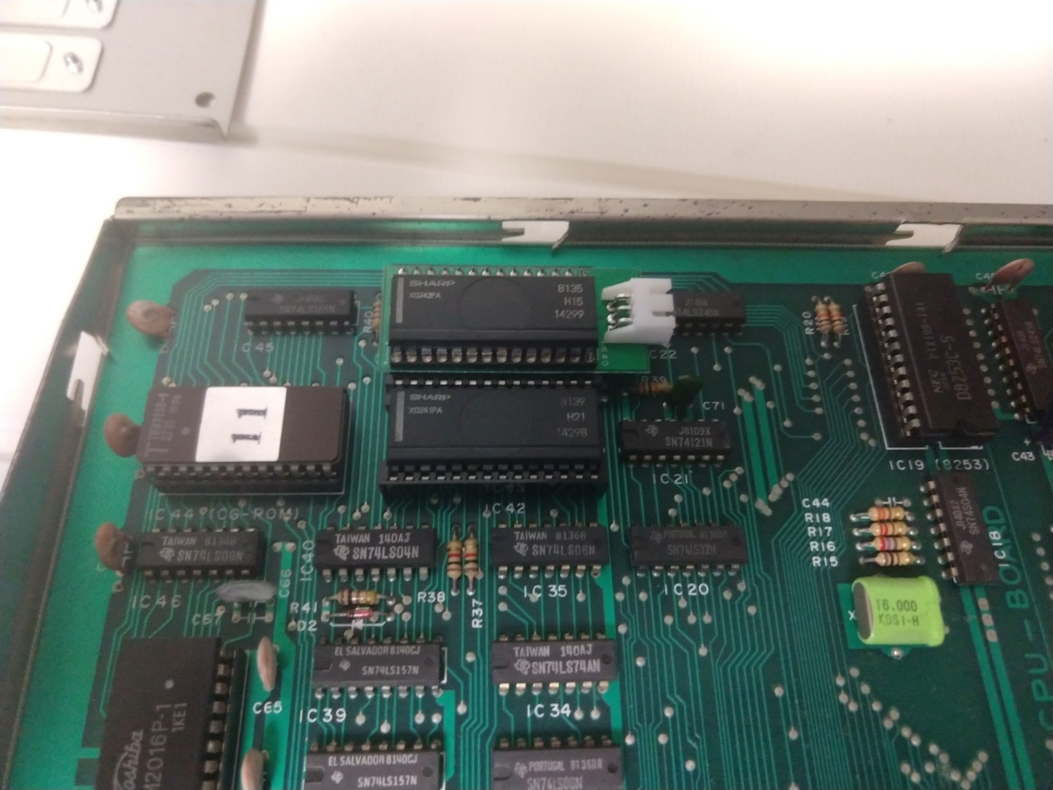
[picture p47: Doc/images/38.jpg]


このパーツ部分はMZ-80Bのキーボードの直下になり、不用意に高さがあるとキーボードの基板に干渉します。
その場合、ショートしたりするため、MZ-80Bが起動しない、キー入力ができないなどの不具合が出ることがあります。
しっかりはめ込んで、もし必要であればICのピン部分をマスキングしてください。（しっかりはめ込めば不要な高さとなるように設計しています）

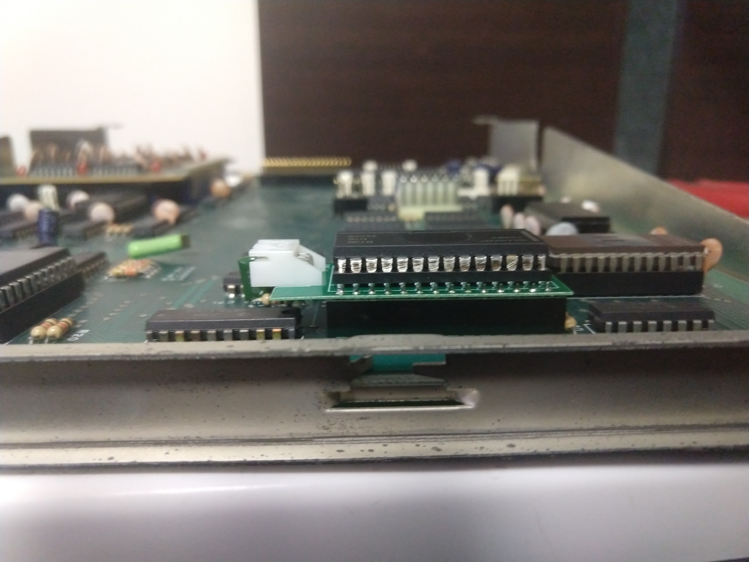
[picture p48: Doc/images/39.jpg]


このときも基板を割らないように、ピンを折らないように注意してください。コネクターには３芯のケーブルを取り付けて、拡張ボード側へ誘導します。

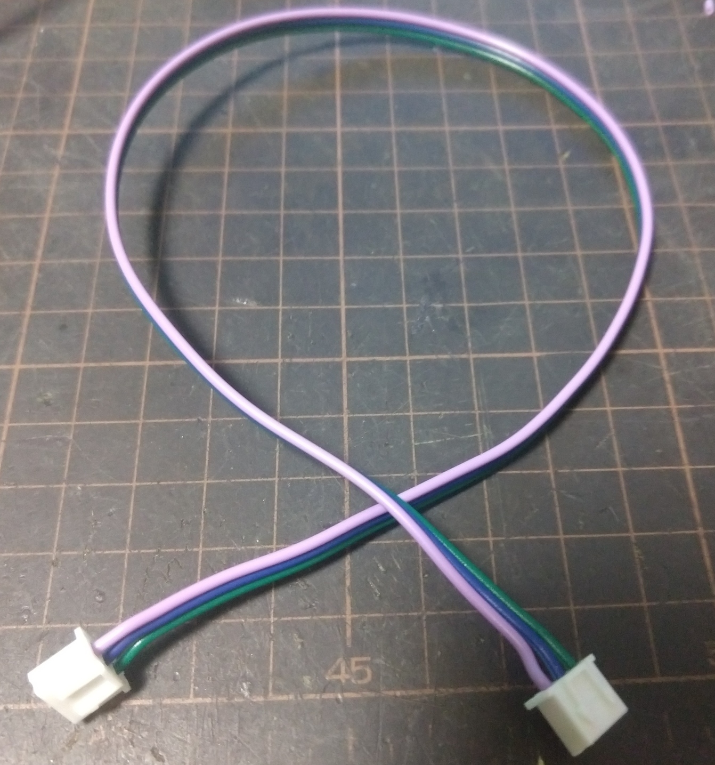
[picture p49: Doc/images/40.jpg]
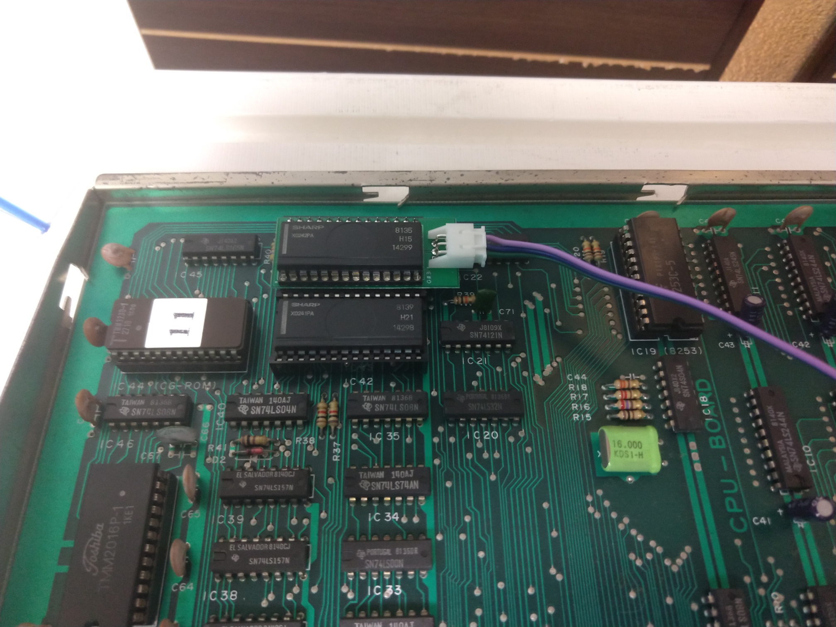
[picture p50: Doc/images/41.jpg]
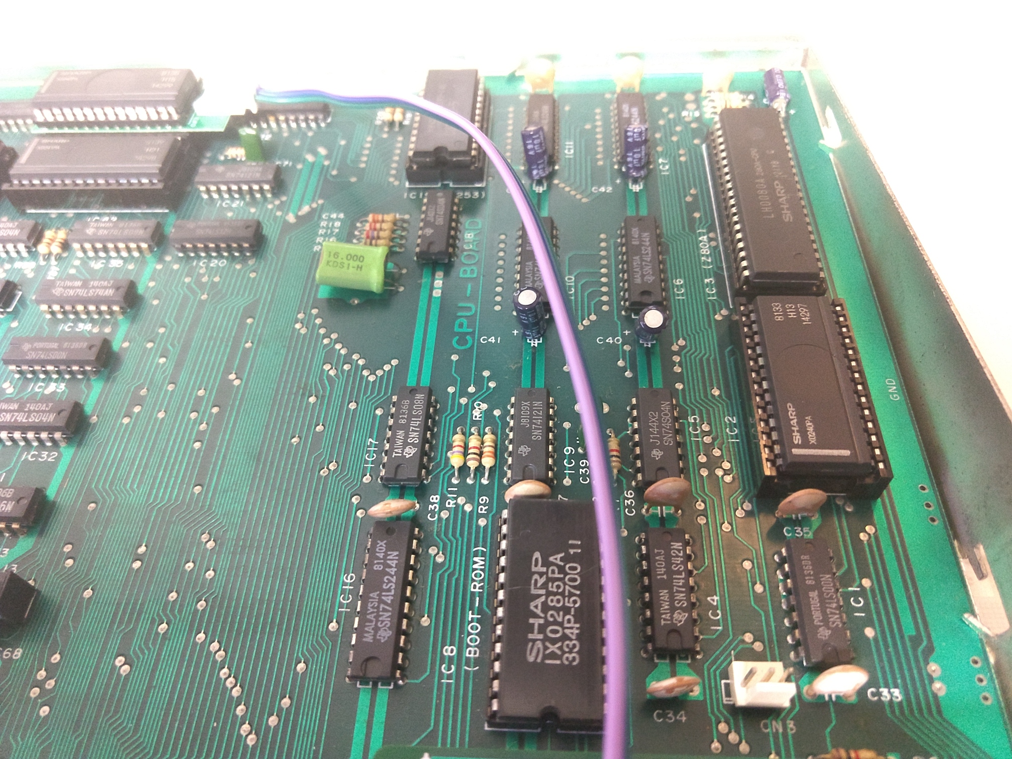
[picture p51: Doc/images/42.jpg]


IC2　G#1も同様です。
ICを取り外した後、基板を取り付け、ICを基板上のソケットにはめ込み、5芯のケーブルを取り付けてください。

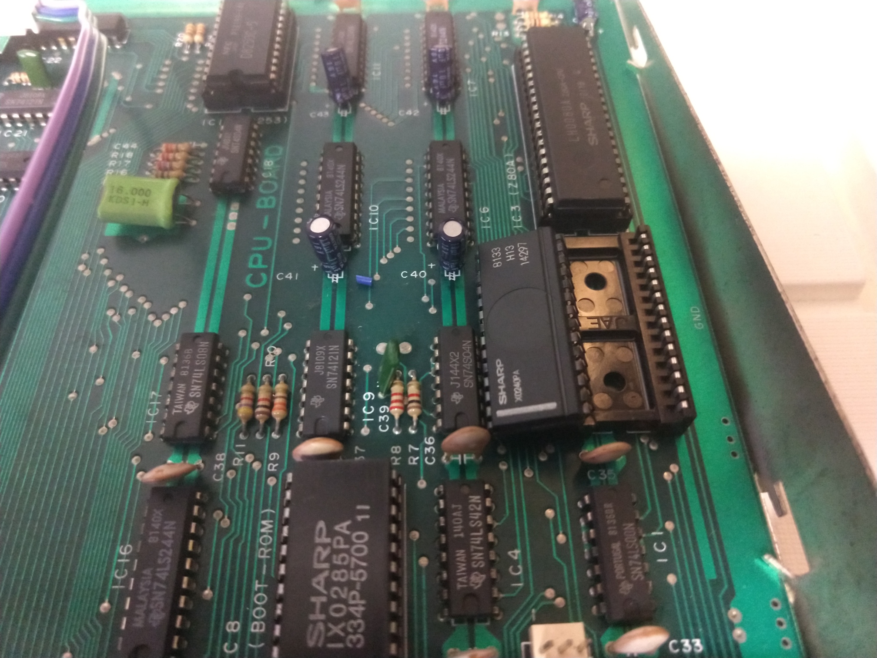
[picture p52: Doc/images/43.jpg]
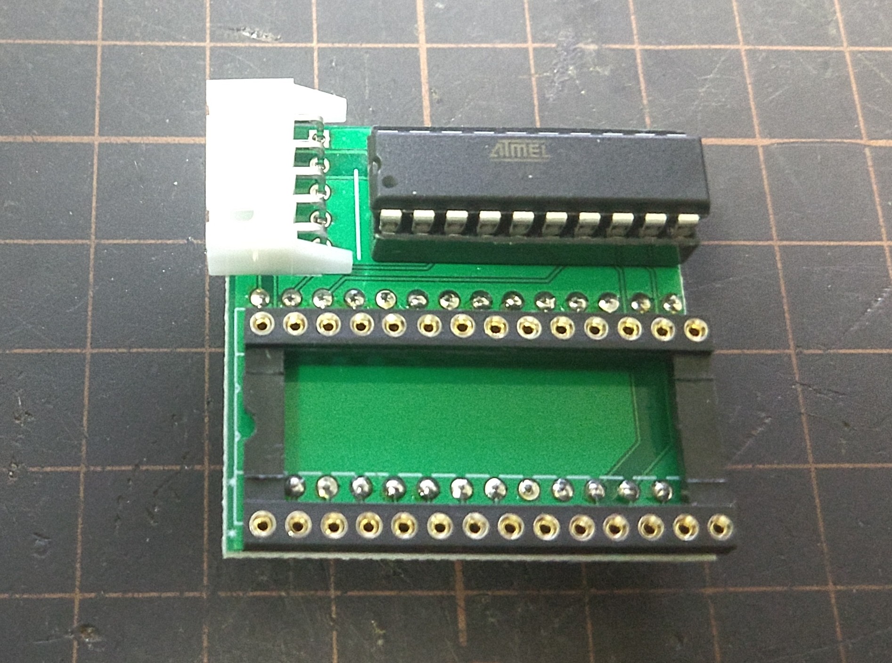
[picture p53: Doc/images/44.jpg]


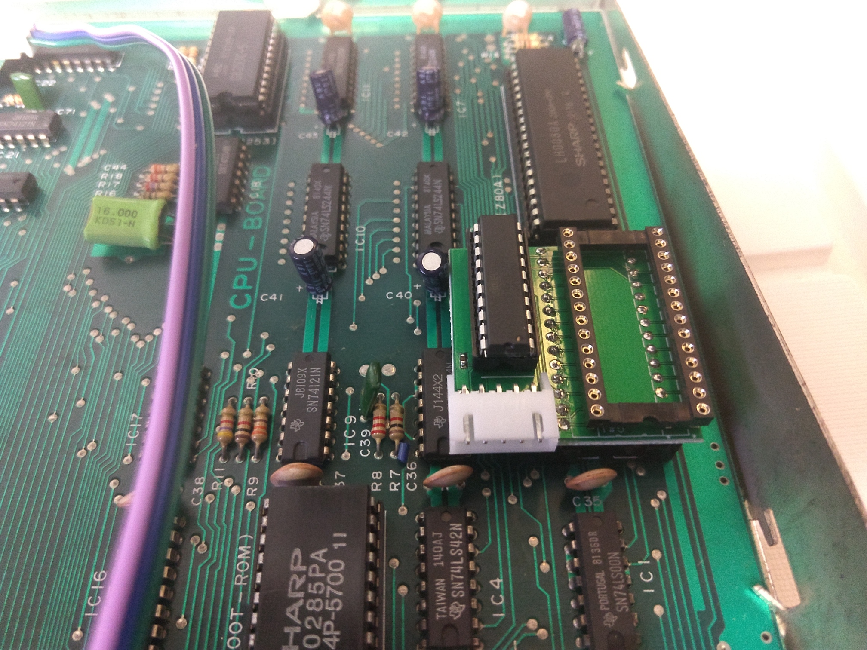
[picture p54: Doc/images/45.jpg]
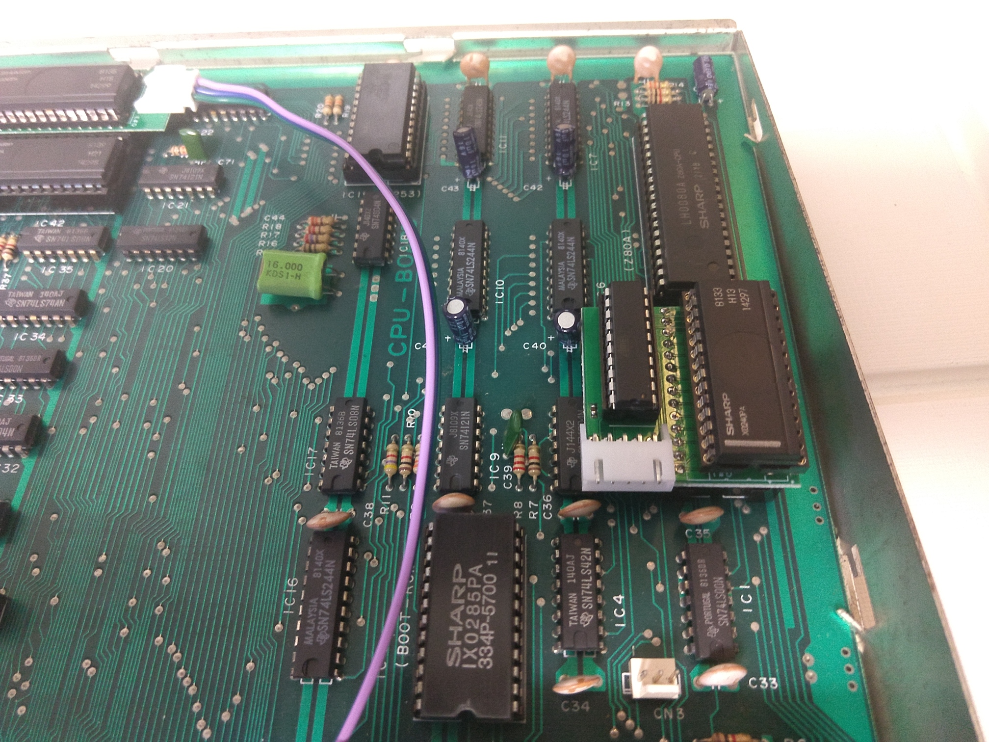
[picture p55: Doc/images/46.jpg]
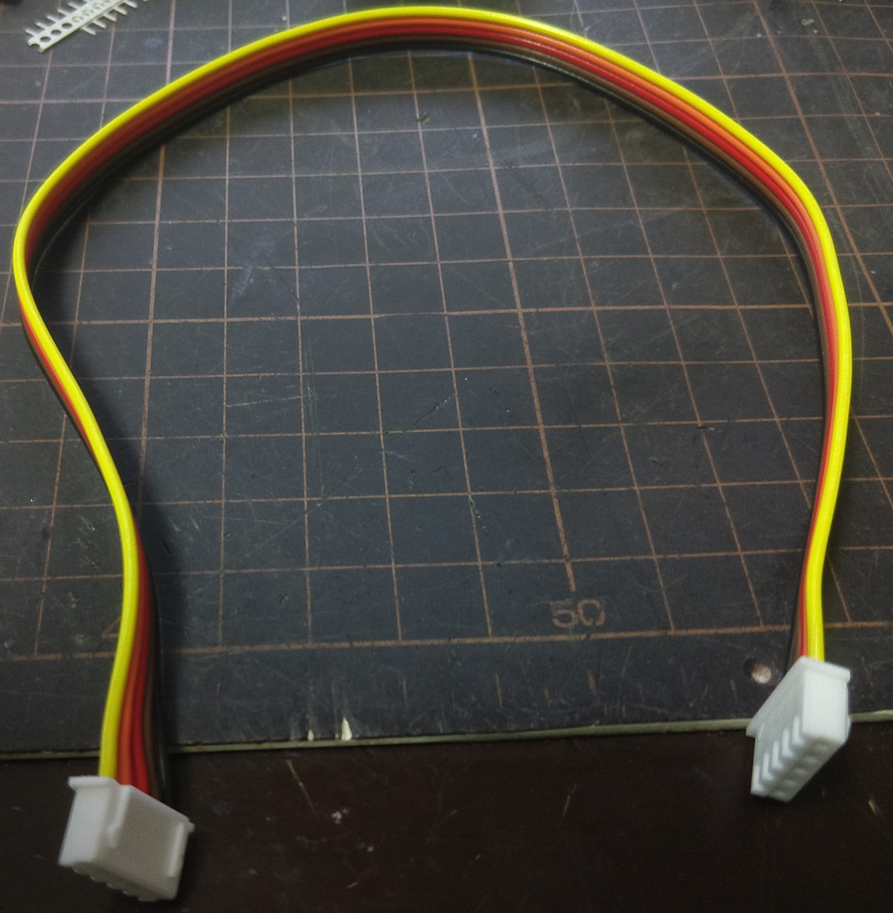
[picture p56: Doc/images/47.jpg]
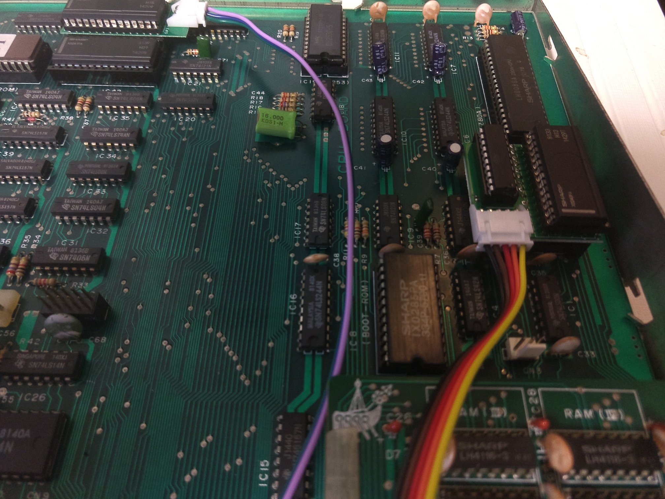
[picture p57: Doc/images/48.jpg]


CN13はGRAMを取り付ける10ピンのところです。

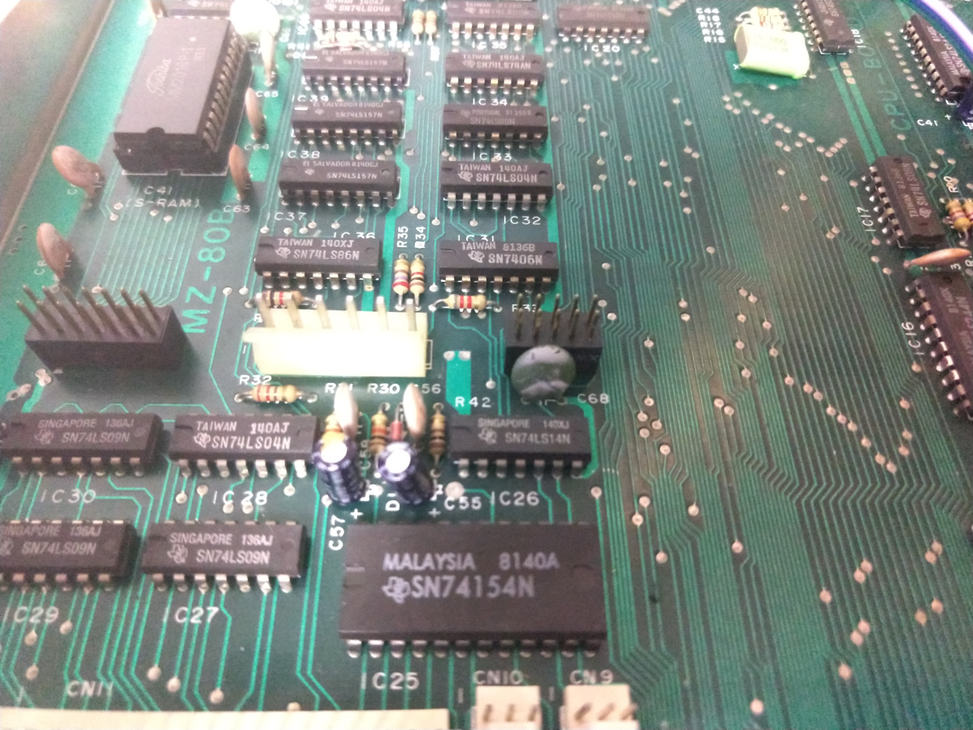
[picture p58: Doc/images/49.jpg]


基板を取り付けて8芯のケーブルを取り付けてください。
写真の向きに取り付けます。
MZ-80BのGRAMを取り付けていた場合は、この基板上にあるコネクターにもともとの取り付け向きと同じように取り付けてください
（これはマザーボードなどをもとに戻した後に行います）

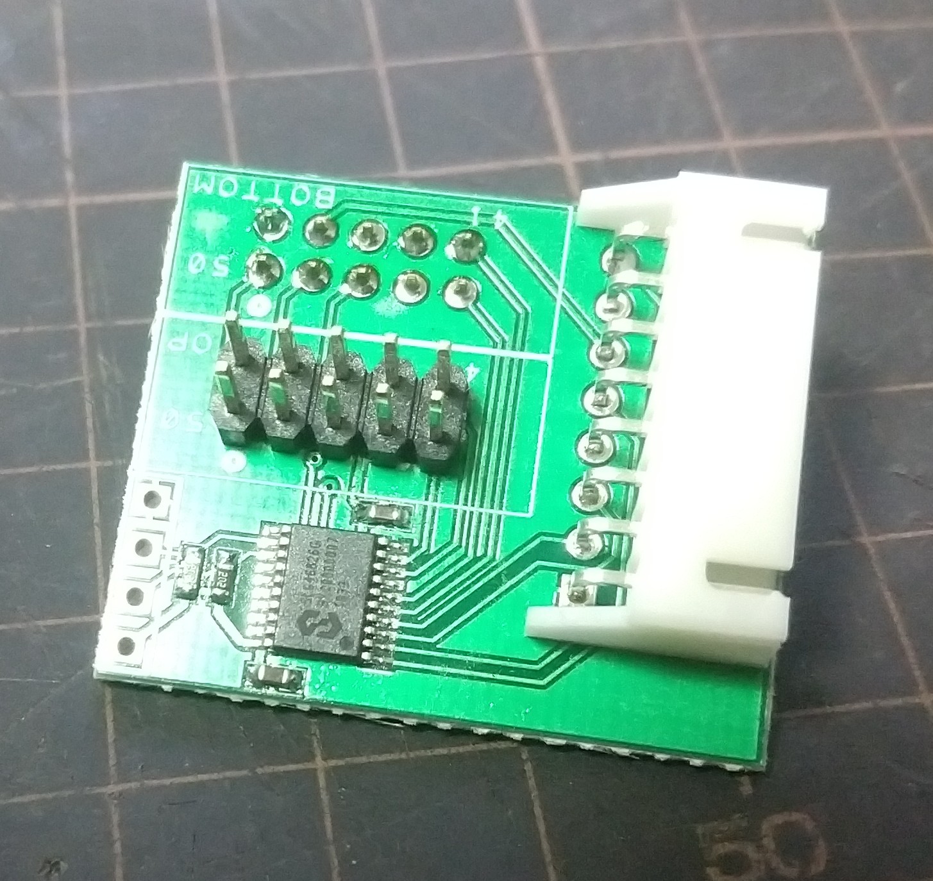
[picture p59: Doc/images/50.jpg]
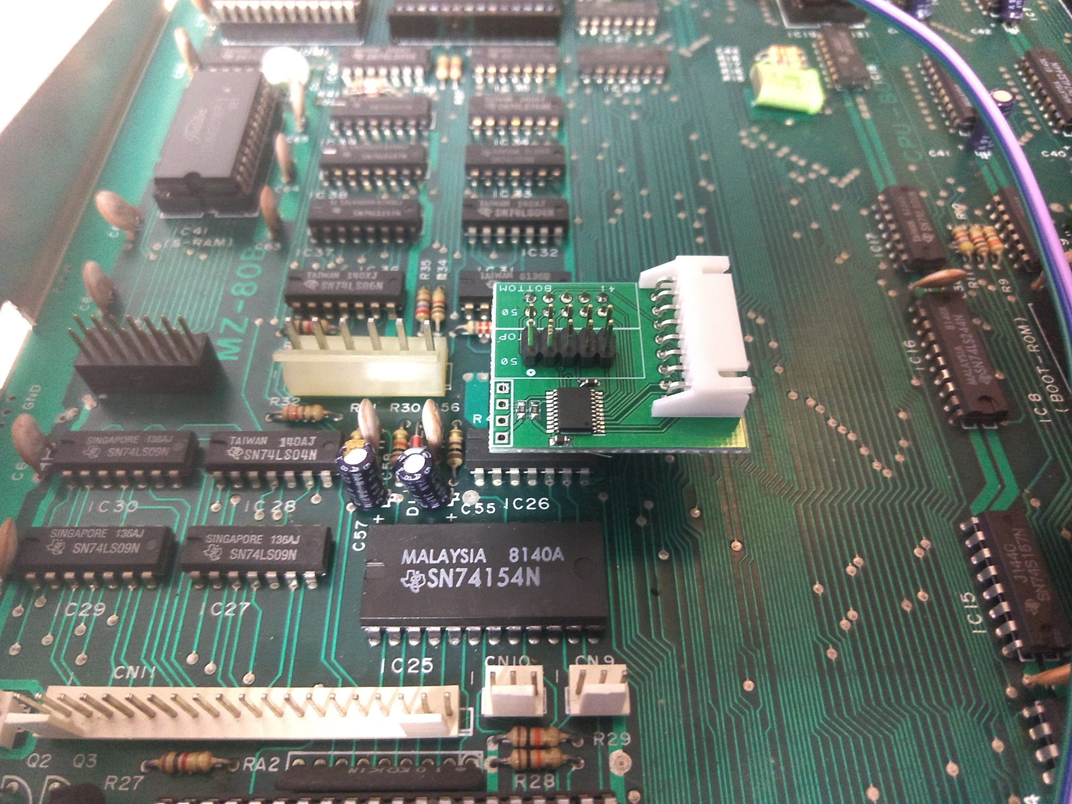
[picture p60: Doc/images/51.jpg]
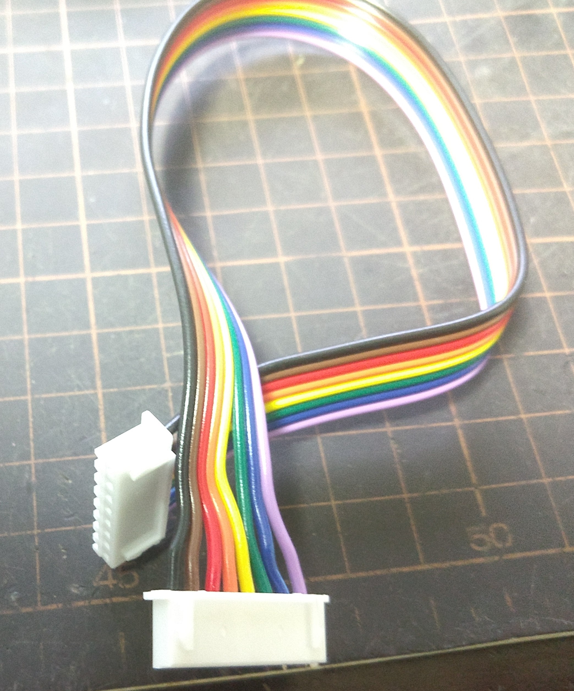
[picture p61: Doc/images/52.jpg]
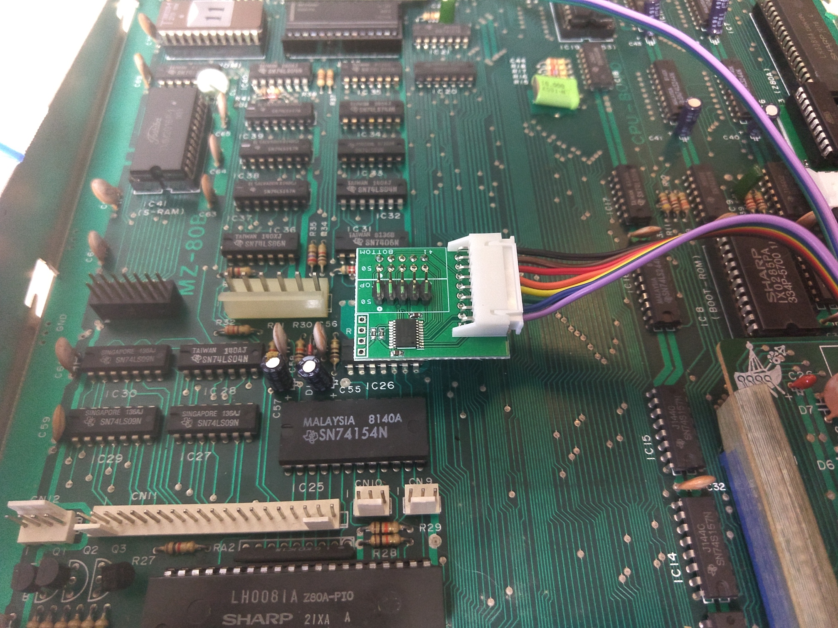
[picture p62: Doc/images/53.jpg]


最後はIC23　8255です。
これも同じようにピン曲がりなどに気をつけてICを取り外します。

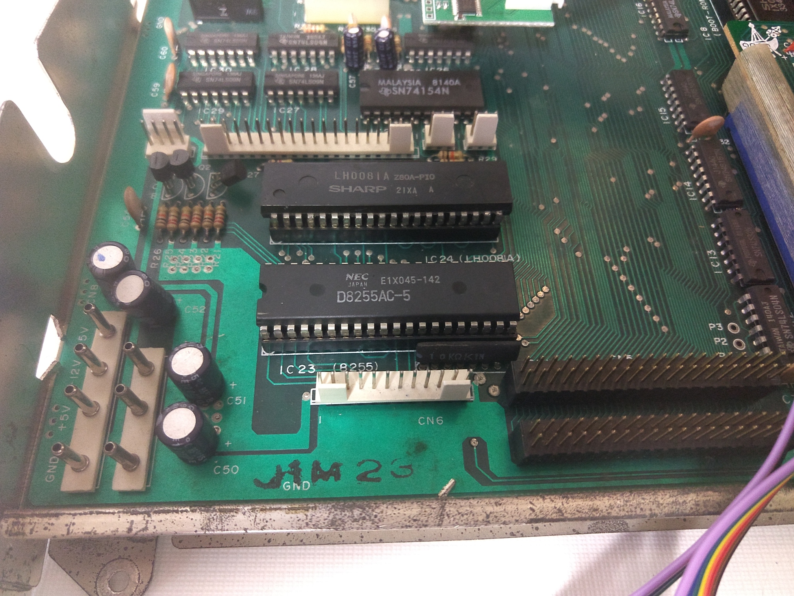
[picture p63: Doc/images/54.jpg]
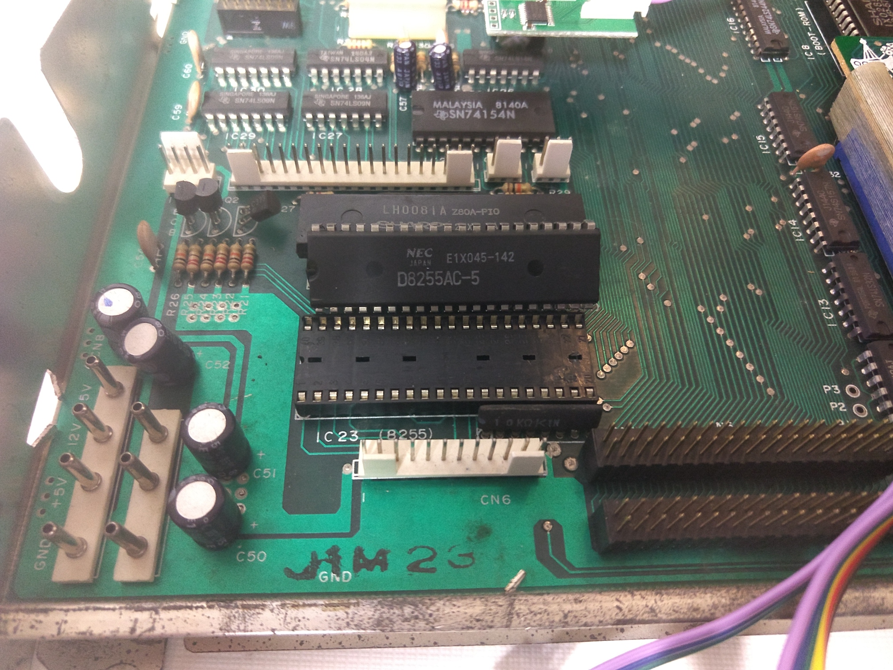
[picture p64: Doc/images/55.jpg]


周囲のパーツの関係でこの基板のピンは長く作成しています。
曲がったり折れやすいので注意してはめ込んでください。
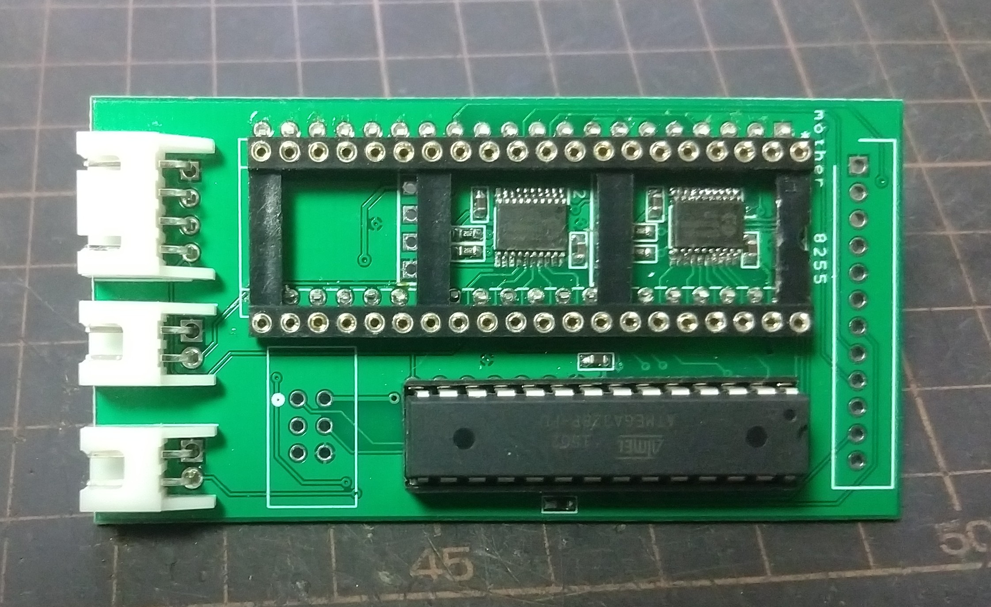
[picture p65: Doc/images/56.jpg]
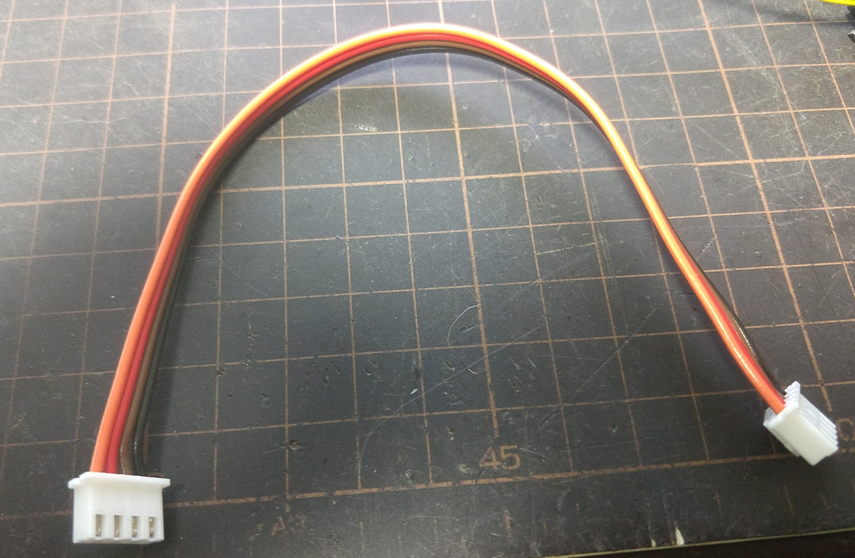
[picture p66: Doc/images/57.jpg]


同様に8255も基板のソケットにはめ込みます。
こちらには3本のケーブルを挿入します。

4芯ケーブルは良いとして、2ピンのケーブルが２ヶ所あります。
中央の2ピンのコネクターはKINHを出力しています。こちらはCMTコントロールボタンへ向かうケーブルに割り込ませる形のケーブルを装着します。
そしてもう一方の端の2ピンのコネクターには、CMTカウンターの信号を入力しますので、先程CMT基板に取り付けたケーブルをこちらへ誘導して装着します。
この2芯ケーブル2本はマザーを戻してからのほうが良いと思われます。

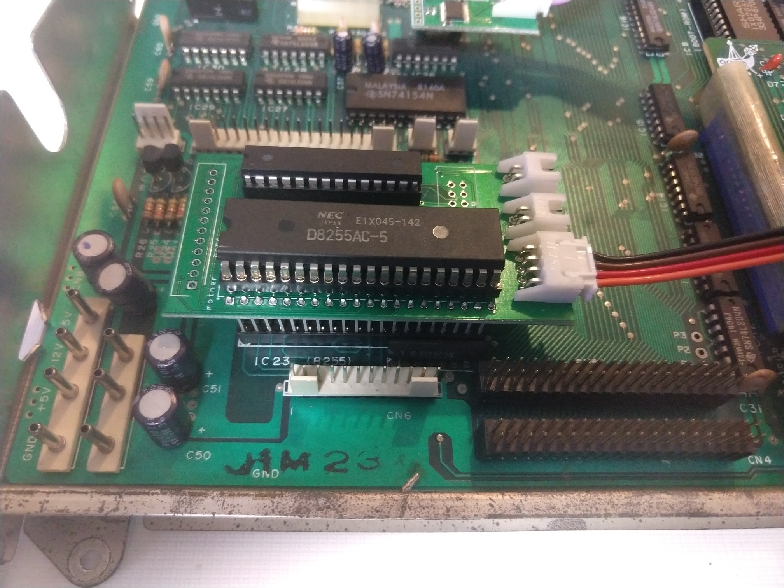
[picture p67: Doc/images/58.jpg]


以上の4枚の基板を装着したら、マザーボードをスライドさせながらもとの位置へ戻し、２ヶ所のネジで止めます。

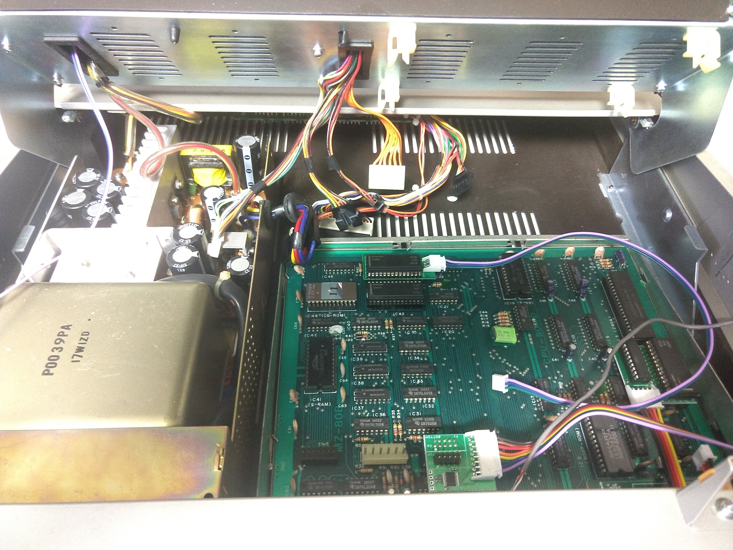
[picture p68: Doc/images/59.jpg]
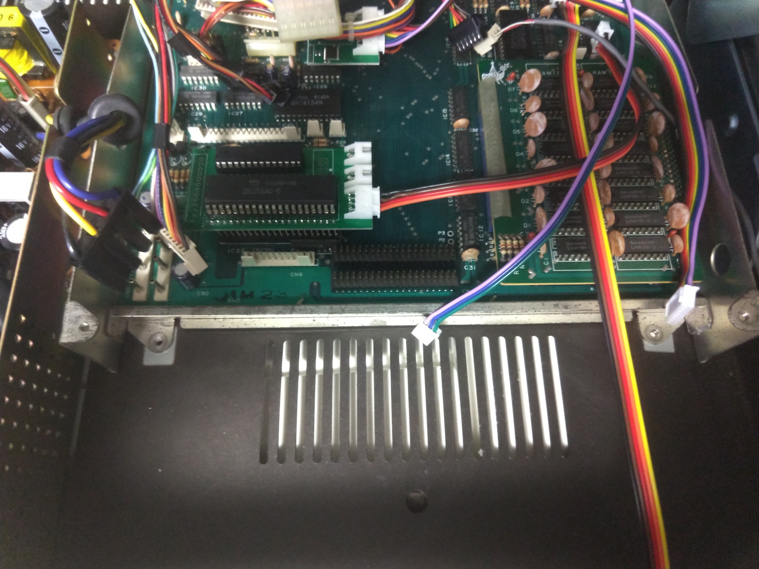
[picture p69: Doc/images/60.jpg]
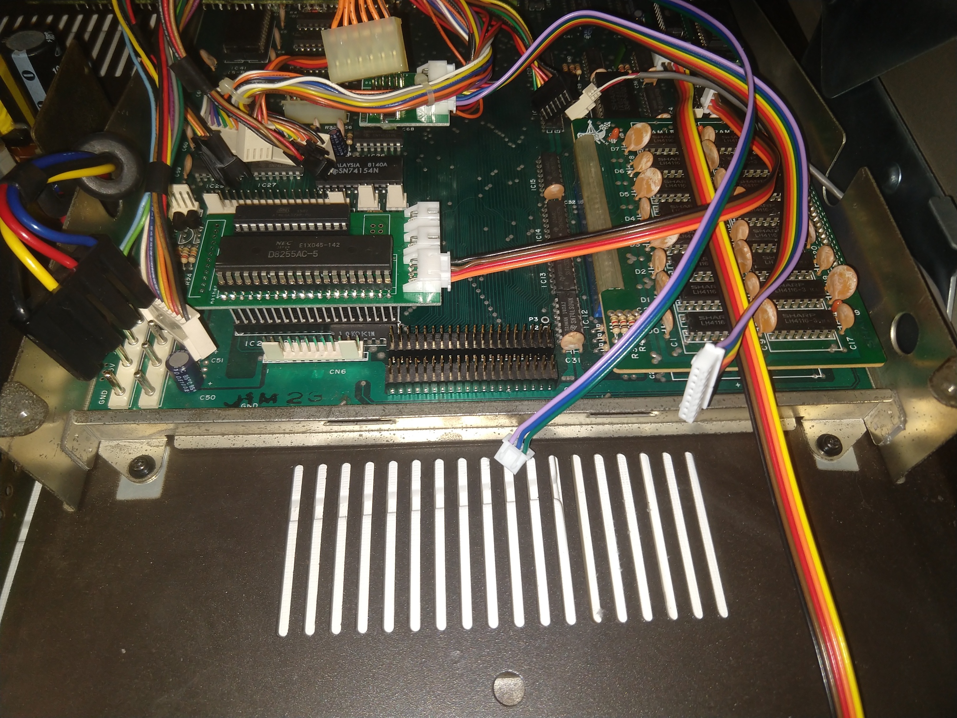
[picture p70: Doc/images/61.jpg]


この状態で、先程取り外したケーブル類をもとに戻していきます。
奥から戻したほうが楽です。

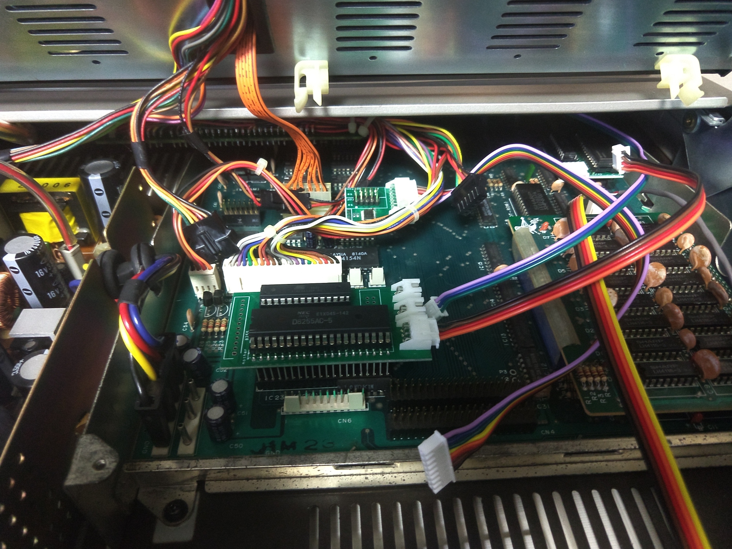
[picture p71: Doc/images/62.jpg]


そして、先程取り付けた8255の残り２ヶ所のケーブルを取り付けます。
KINHのケーブルはCMTコントロールケーブルへ割り込ませる形で、CMTカウンターのケーブルとも装着します。

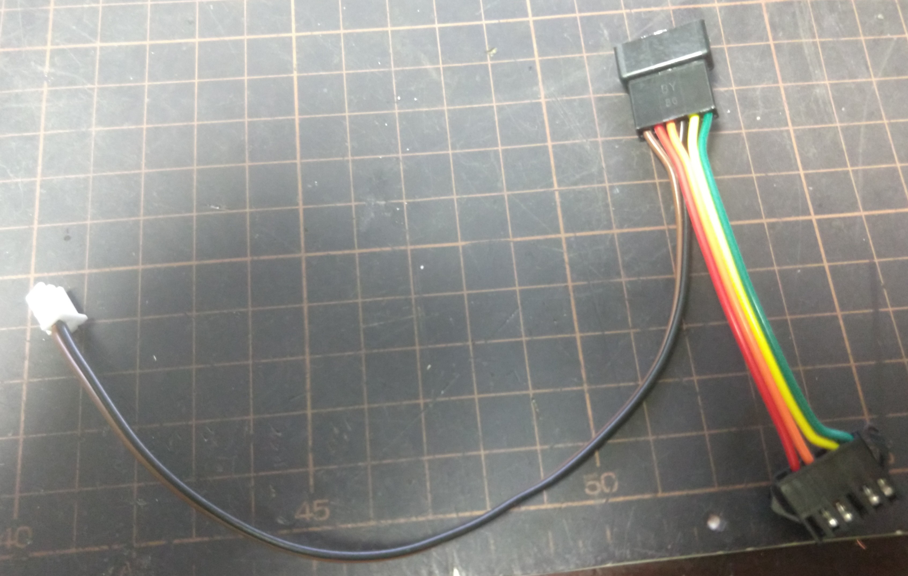
[picture p72: Doc/images/63.jpg]
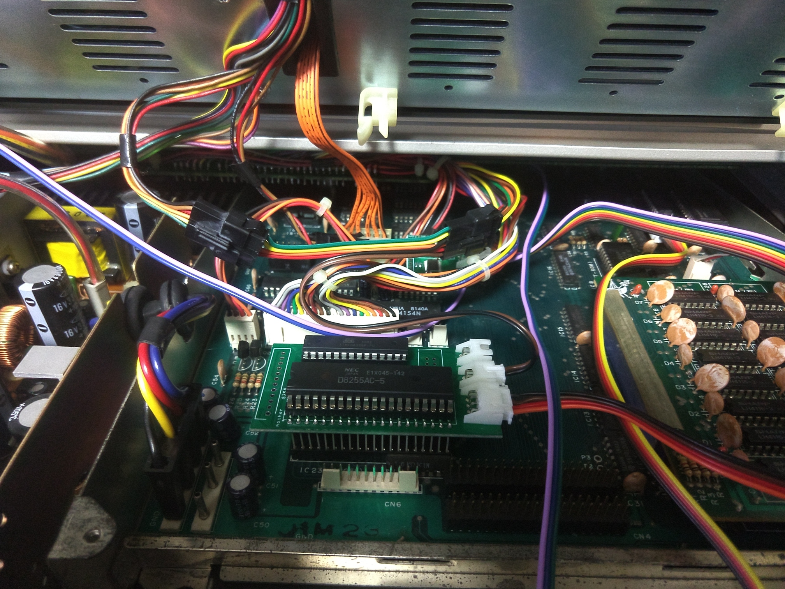
[picture p73: Doc/images/64.jpg]


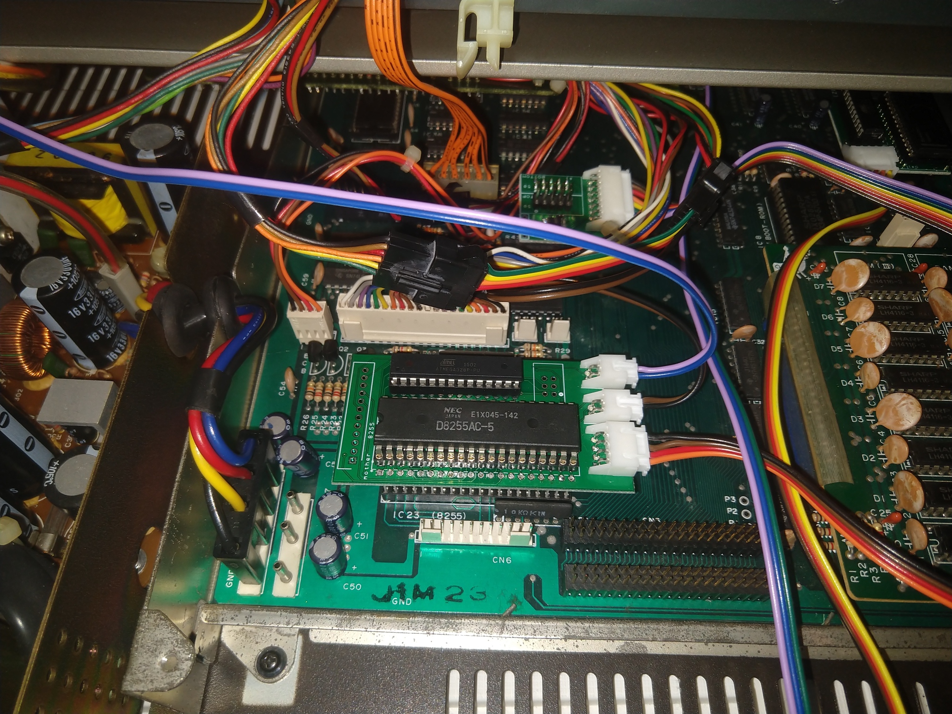
[picture p74: Doc/images/65.jpg]


最後にマザーボードの電源ケーブルを取り付けたか確認してください。
マザーボードへの取り付けは完了です。

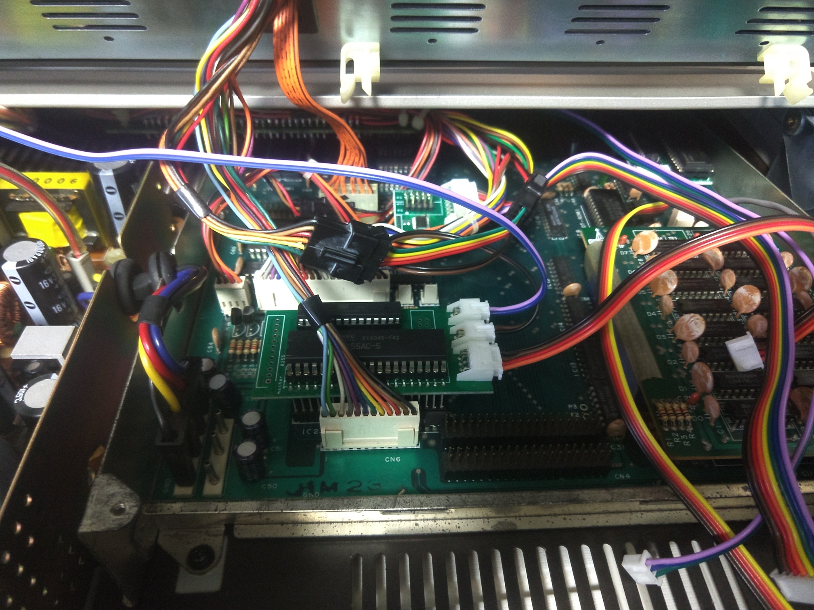
[picture p75: Doc/images/66.jpg]


次に拡張I/Oボードの取り付けを行います。もし拡張I/Oボードを持っていない場合はスキップしてください。

先程と逆に、拡張I/Oボードを取り付け、マザーボードとの間で2箇所のネジ止めを行います。
電源ケーブルをマザーボードへ取り付けます。

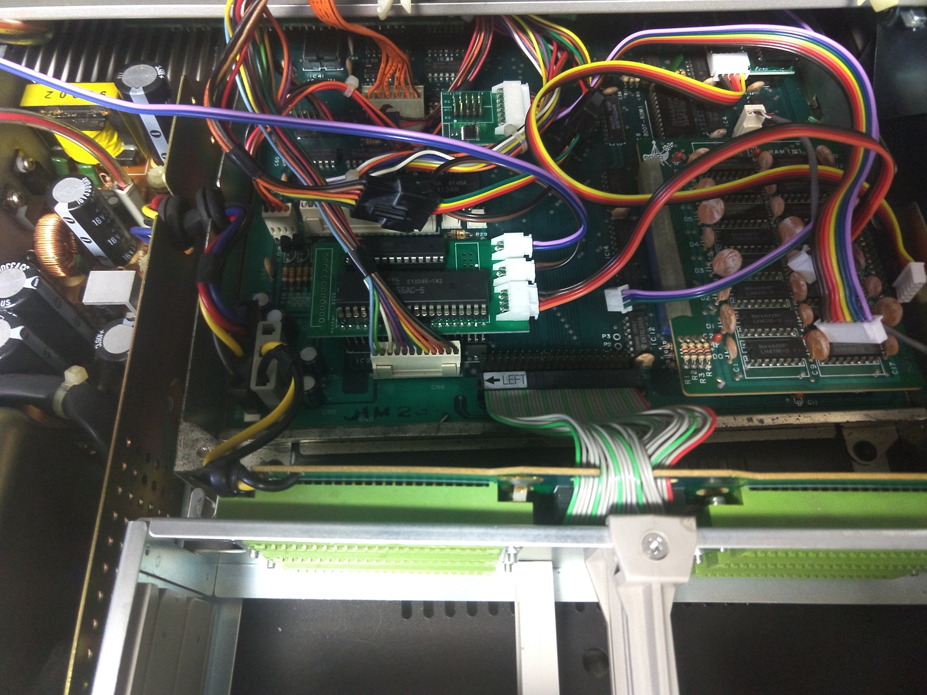
[picture p76: Doc/images/67.jpg]
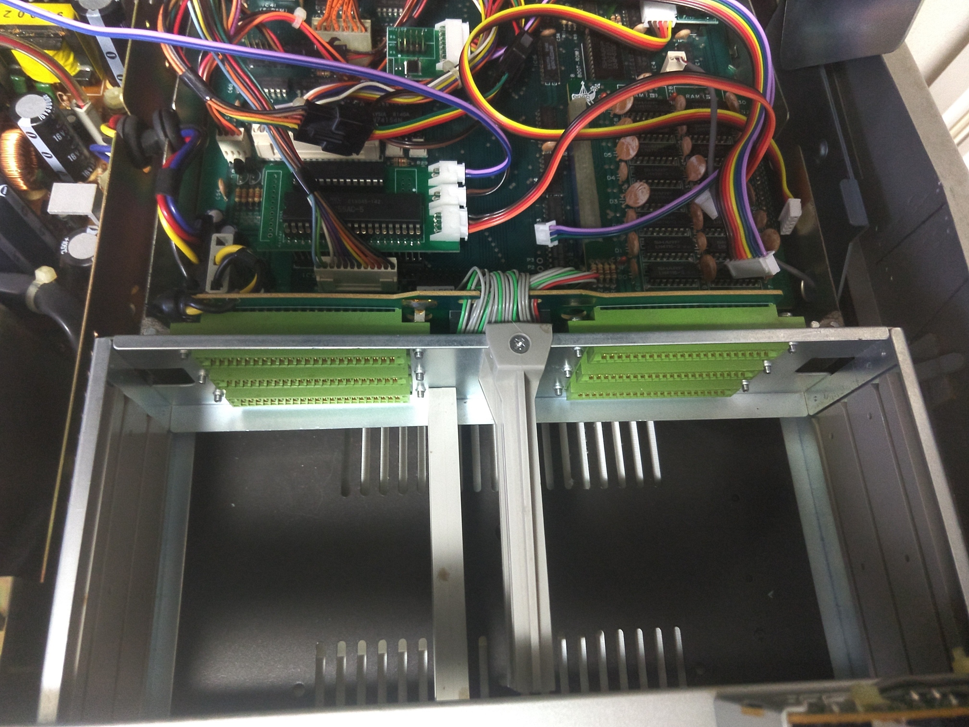
[picture p77: Doc/images/68.jpg]
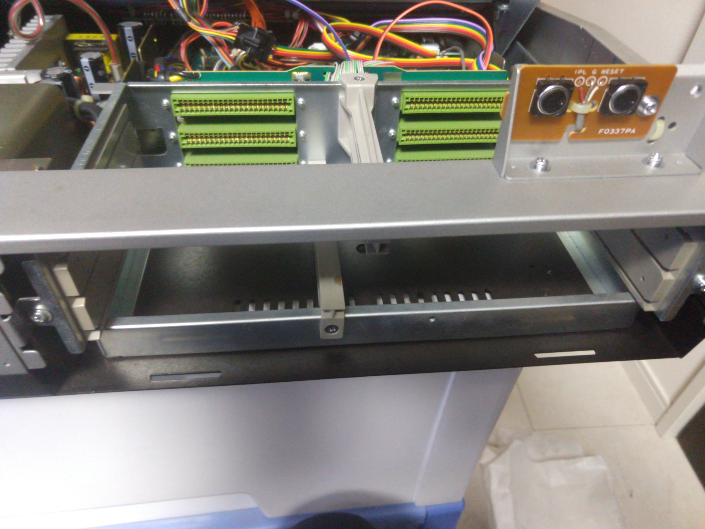
[picture p78: Doc/images/69.jpg]


後ろのパネルはカードを取り付けるまで閉じないでください。
GRAMのカードを取り付けます。
マザーボードから複数のケーブルを装着する必要があるので、一番上のどちらかに装着してください。
背面から向かって左側がよいと思います。

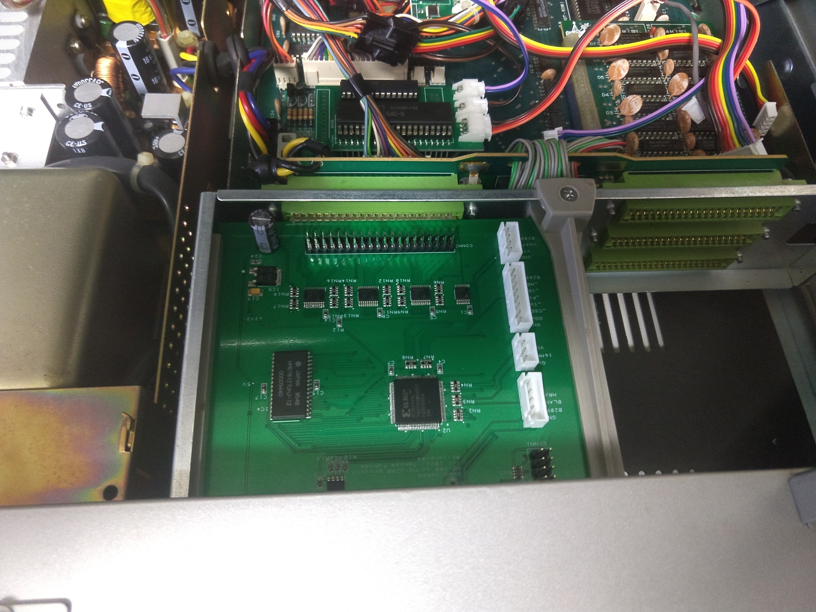
[picture p79: Doc/images/70.jpg]
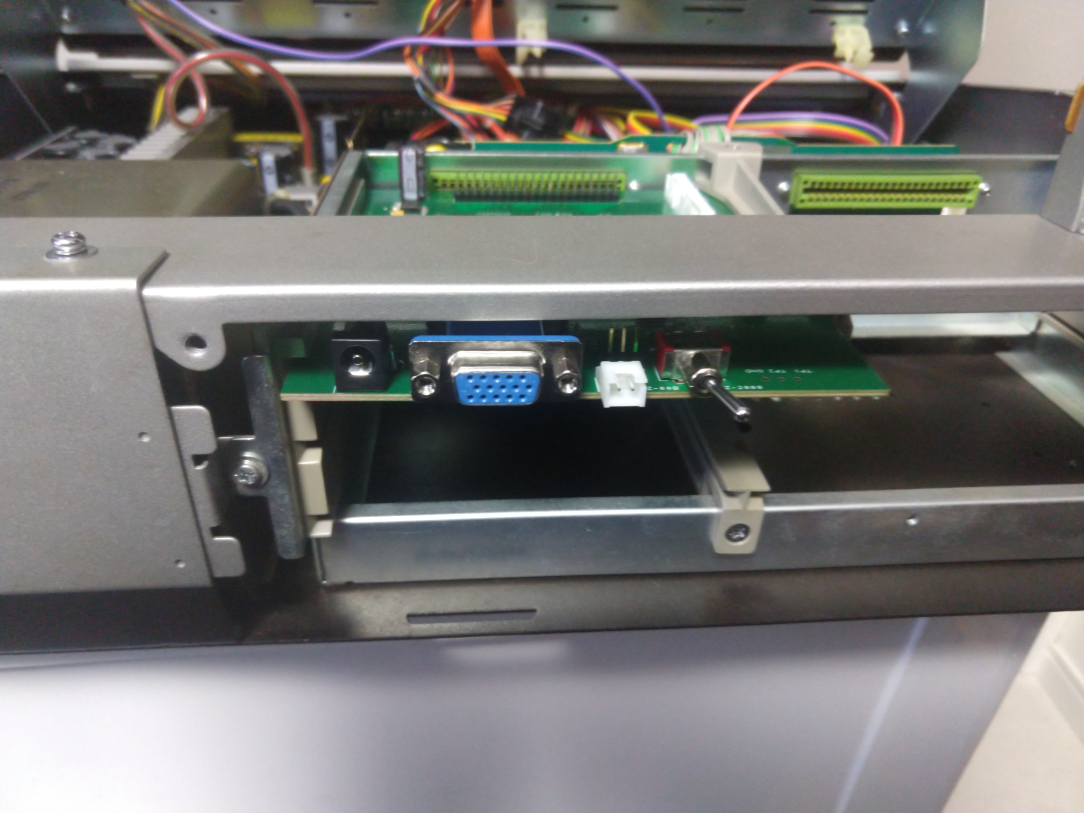
[picture p80: Doc/images/71.jpg]


こちらを装着したら、それぞれのケーブルをそれぞれのソケットへ装着します。

***
*IPLの差し込む部位はこの写真にありません*
***

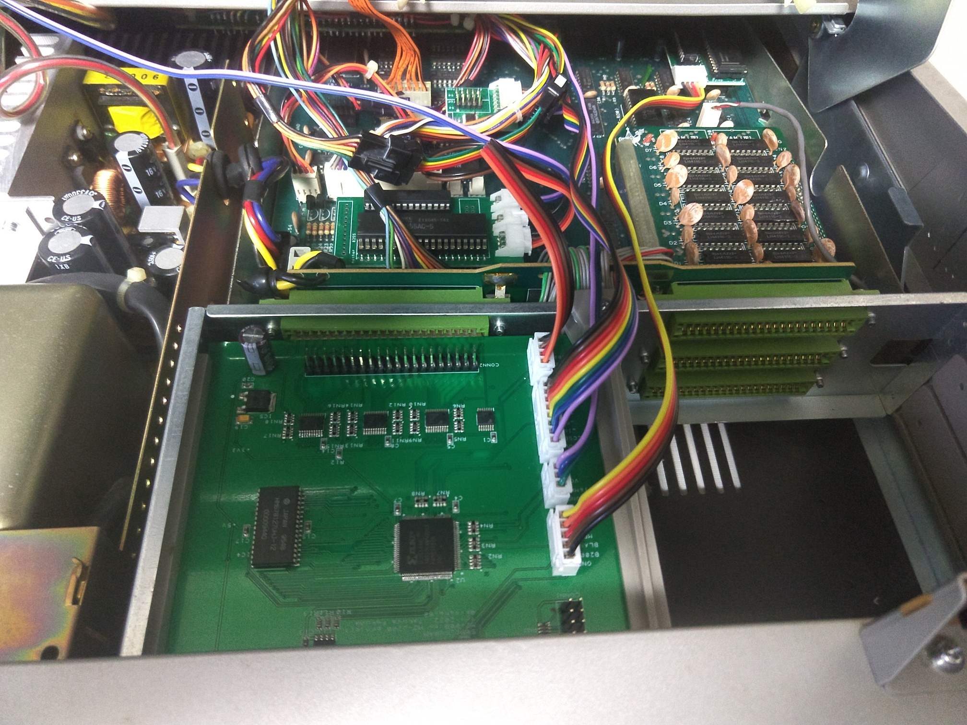
[picture p81: Doc/images/72.jpg]


MZ-80BのGRAMがある場合はこれを取り付けてください。

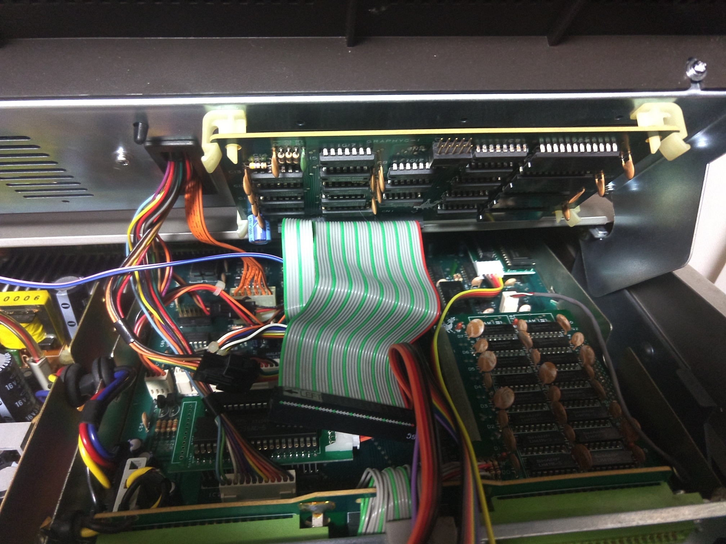
[picture p82: Doc/images/73.jpg]
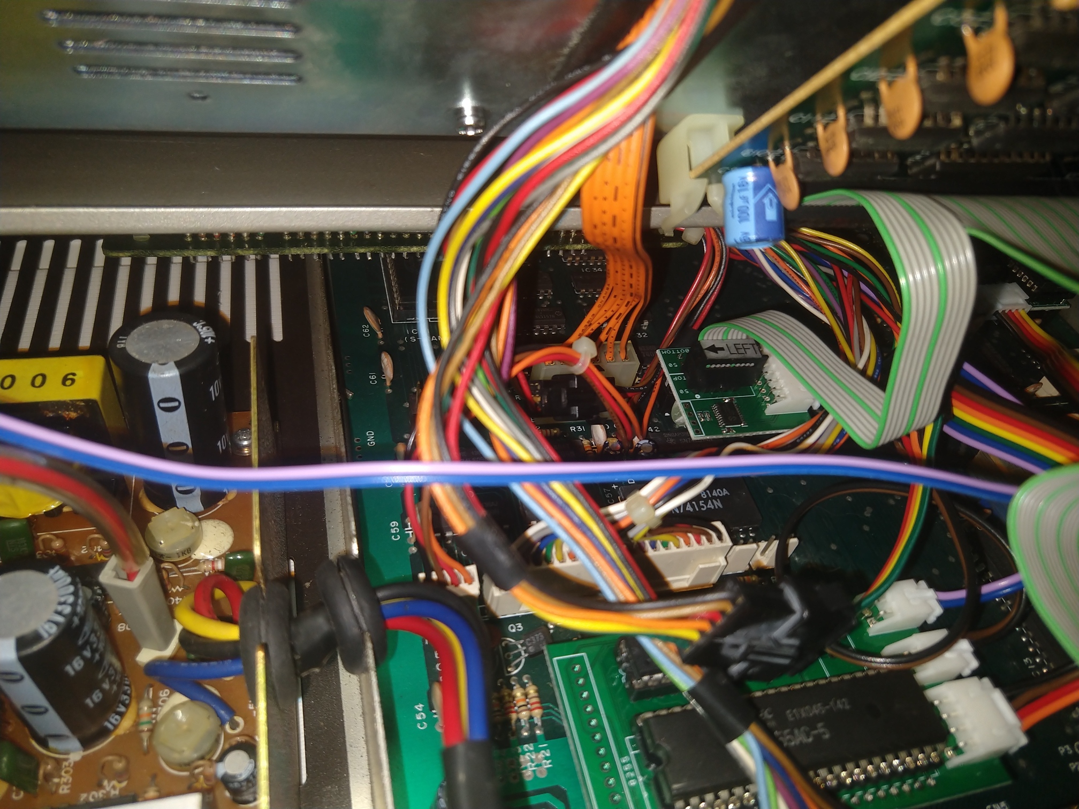
[picture p83: Doc/images/74.jpg]
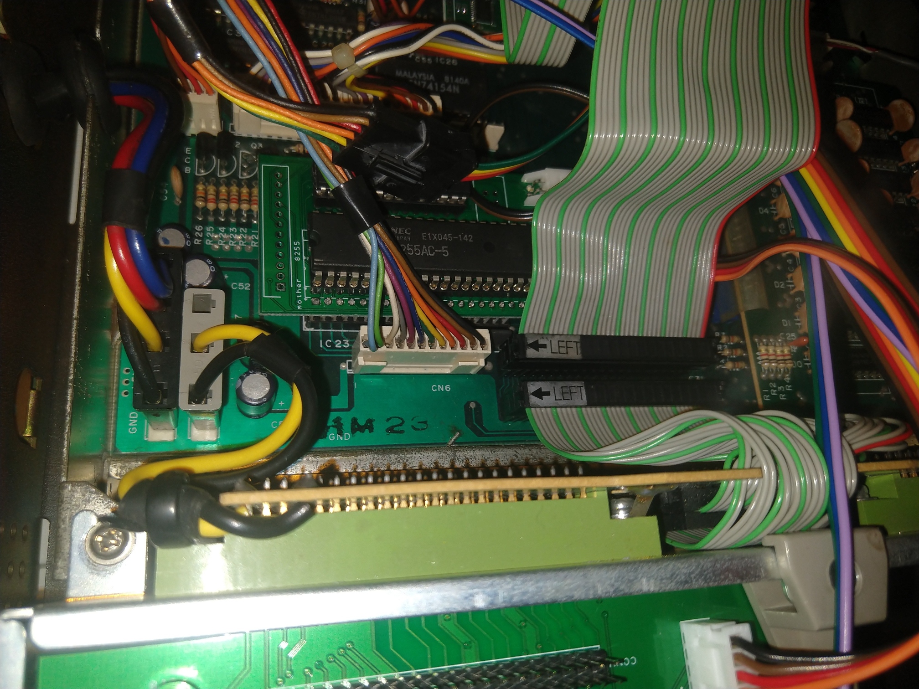
[picture p84: Doc/images/75.jpg]


ここまで行ったら、パネルを閉じてOKです。
CMT、ディスプレイを下へ戻し、ネジ止めしたら終了です。

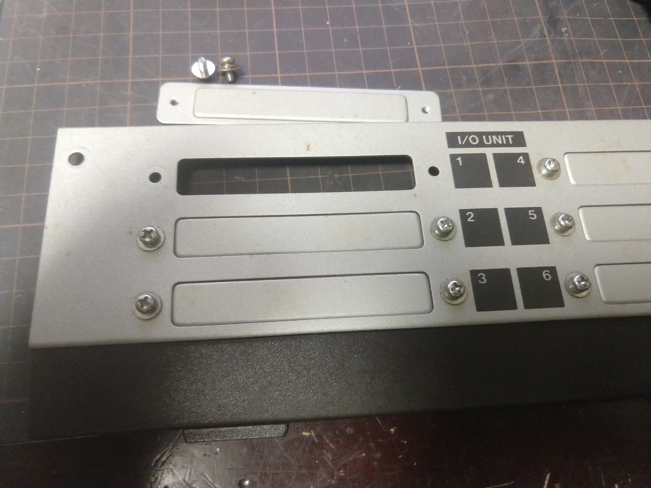
[picture p85: Doc/images/76.jpg]
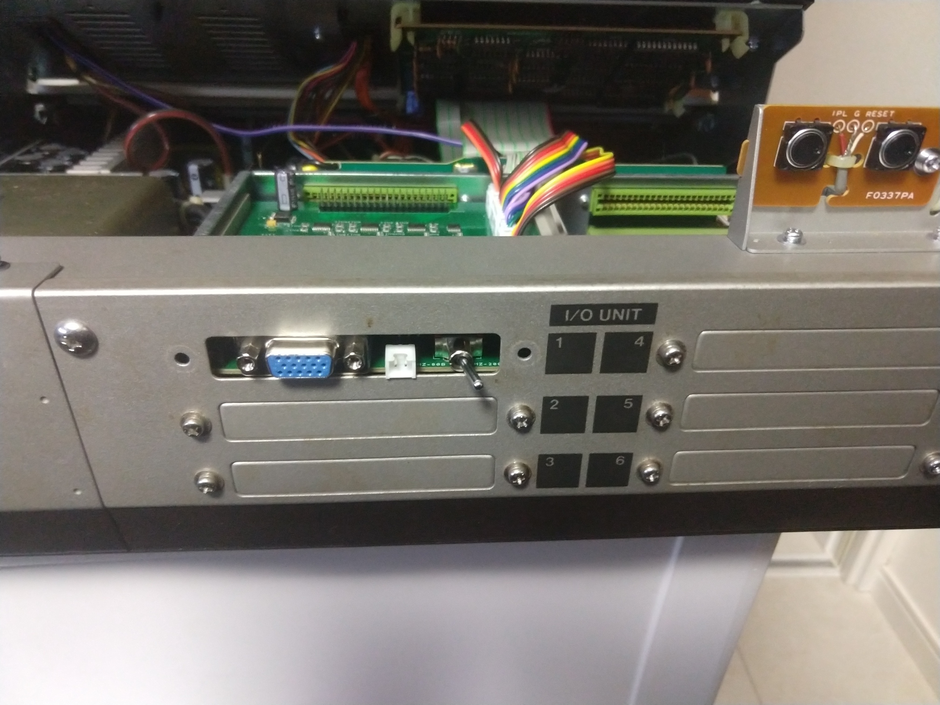
[picture p86: Doc/images/77.jpg]
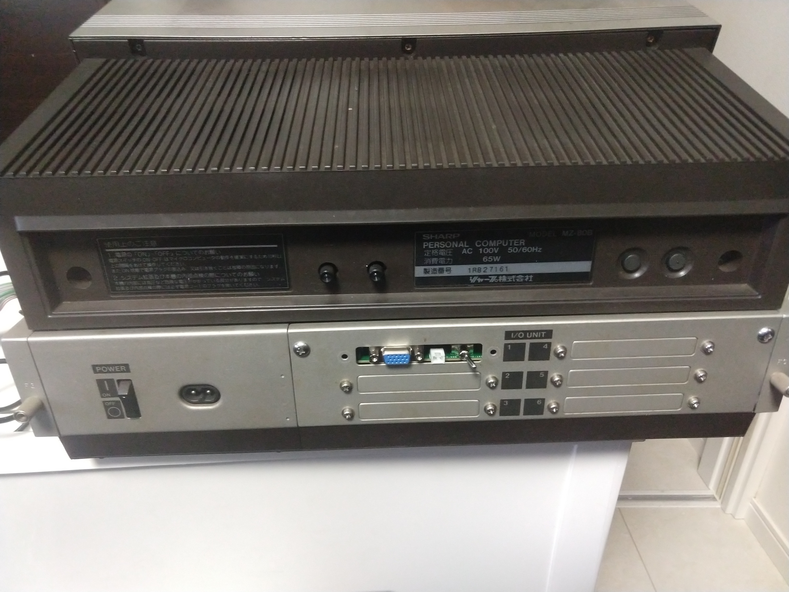
[picture p87: Doc/images/78.jpg]


拡張I/Oボードを所有していない場合、基板はフリーな状態となりますが使用可能です。
40ピンのストレートケーブル（古いIDEのケーブルなど）で拡張I/Oボードの取り付けするコネクターからGRAMへそのままケーブルを取り付けます。

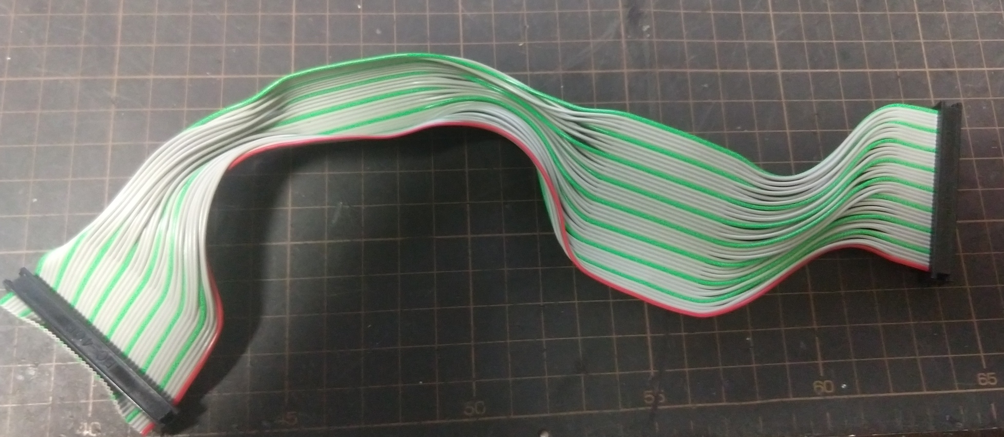
[picture p88: Doc/images/79.jpg]


頒布する基板にはケーブル取り付けのピンヘッダは含まれていませんので、ケーブルとピンヘッダを入手してはんだ付けしてください。

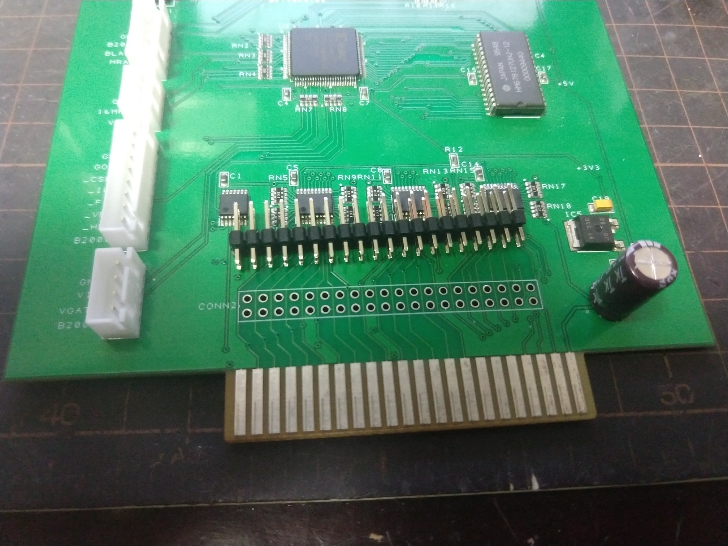
[picture p89: Doc/images/80.jpg]


問題は電源ですが、外部で+5V電源を供給することで使用できるようにしています。

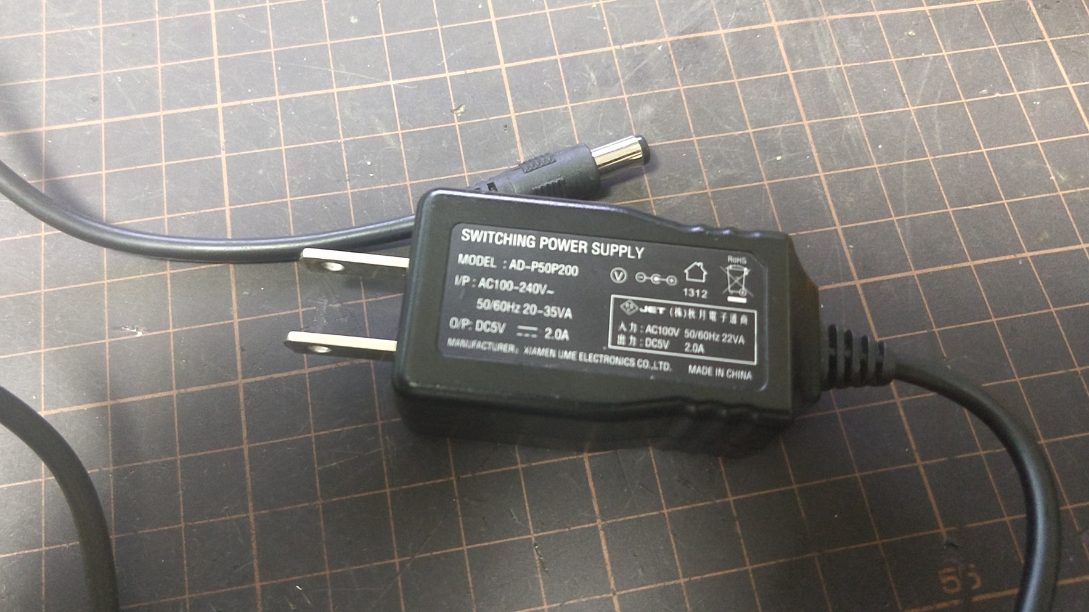
[picture p90: Doc/images/81.jpg]


内部の電源をもらっても良いのですが、拡張I/Oボードへの電源のコネクターが入手できません。
そのほかのマザーからの信号線は同様に取り付けます。
基板がむき出しなのでショートしないようにしてください。

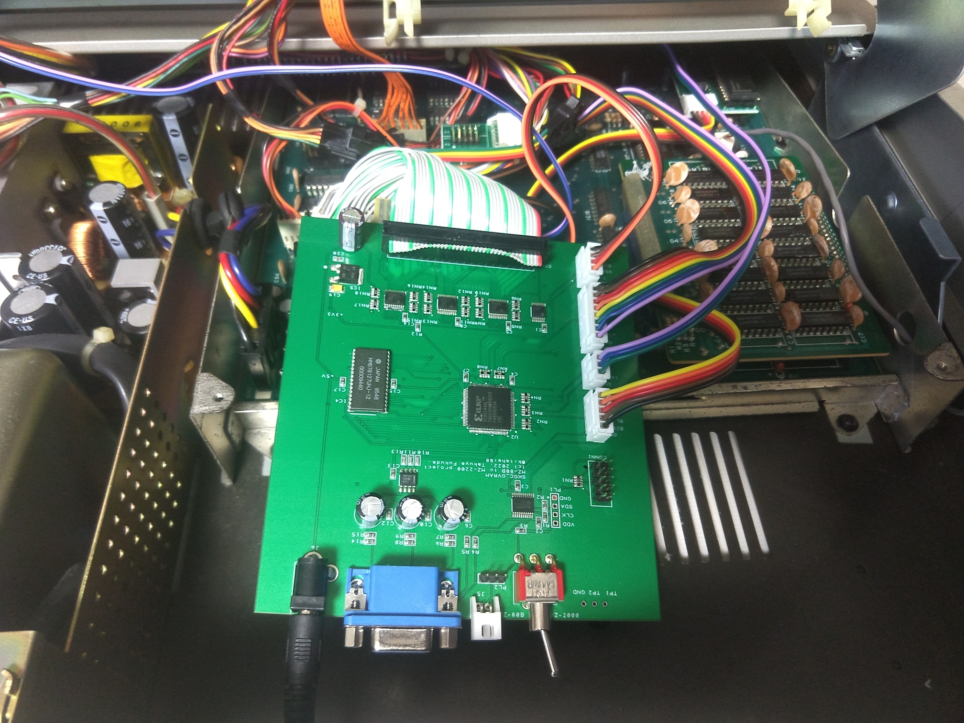
[picture p91: Doc/images/82.jpg]


以上です。
お疲れ様でした。
