kitahei88/SKGC-for-MZ-80B/Doc/HowToUse.md

# 使用方法

GRAM背面にあるスイッチを切り換えることで、MZ-80Bとして動作するかMZ-2000としての動作かを切り換えます。

切り換え時は必ず電源を切った状態で行ってください。

MZ-2000モードの際、画面は実機と同様にグリーンモニターと外部モニターに出力されます。
背面にあるminiDsub15ピンとLCDを通常のRGBケーブルで接続してください。

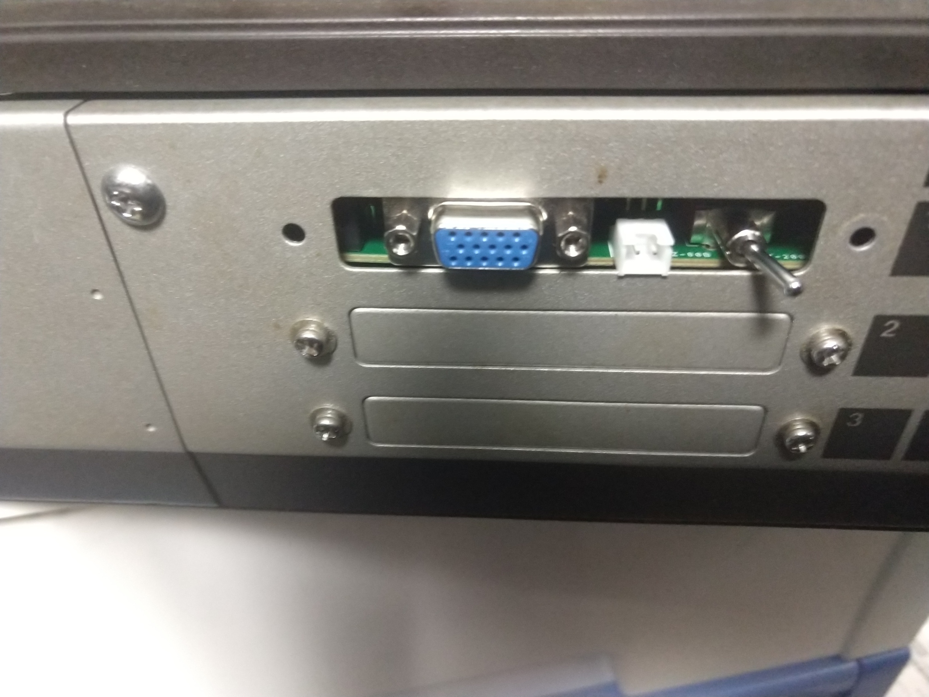
[picture p92: Doc/images/83.jpg]


同期信号はもともとのMZ-2000と同様に15KHzが出力されます。
そのため15KHzでHsyncとVsyncの入力を受け付けるLCDを使用する必要があります。

例：
cocoparとかWIMAXITとかKVC lab.さんで販売している9.7inchのものなど

取り付け直後では、まずMZ-80Bモードが動作するか確認してください。
GRAMにあるスイッチをMZ-80B側にして電源を投入します。

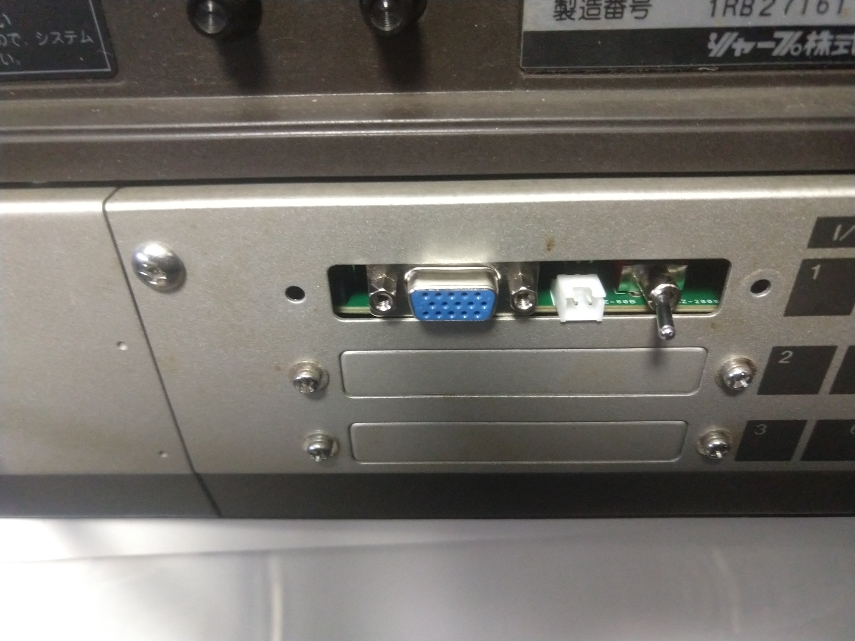
[picture p93: Doc/images/84.jpg]


CMTが開くとか、CMTを読みに行く、BASICを読み込んだ後に巻き戻す、何かソフトウェアを読み込んで動作を確認するなどしてください。

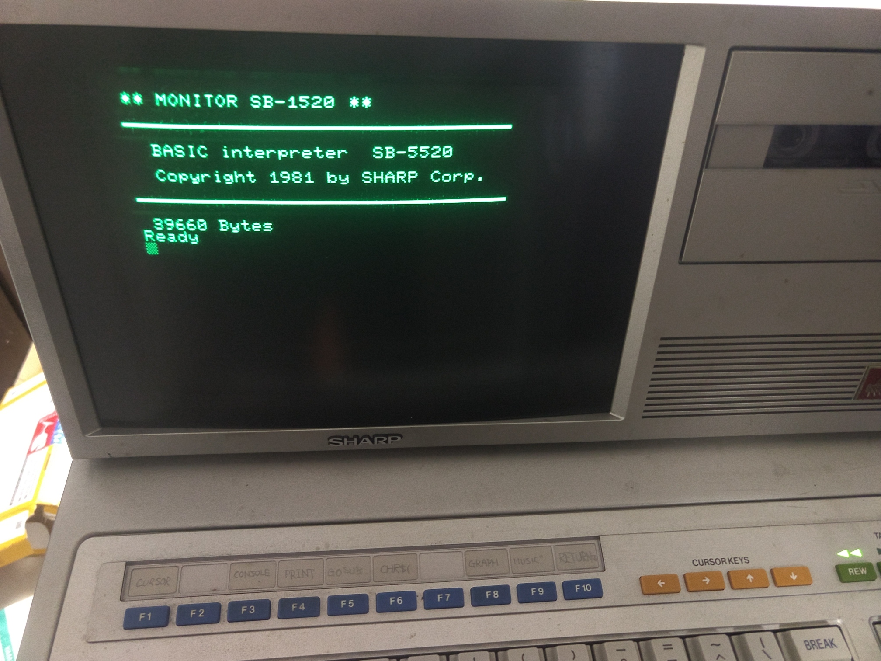
[picture p94: Doc/images/85.jpg]
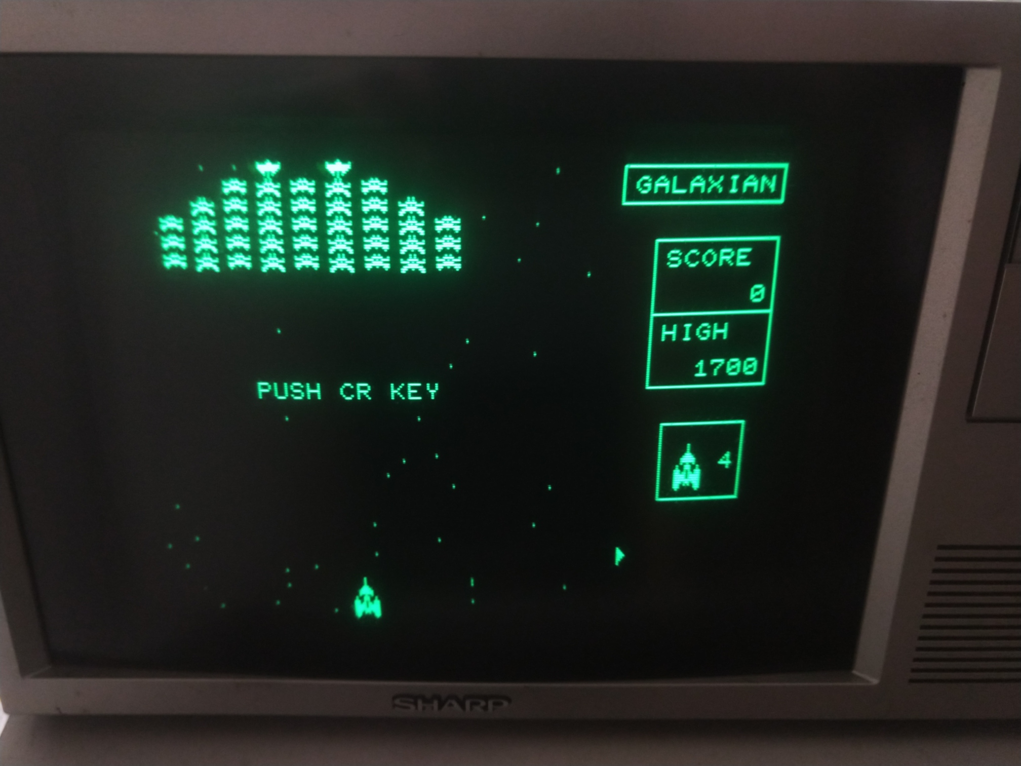
[picture p95: Doc/images/86.jpg]


次にMZ-2000のモードをチェックします。
電源を切った後にスイッチをMZ-2000側に切り換えます。



この状態で電源を投入すると、外部モニターには白字で表示されると思います。
MZ-2000のBASICやソフトなどを読み込んでチェックしてみてください。
          
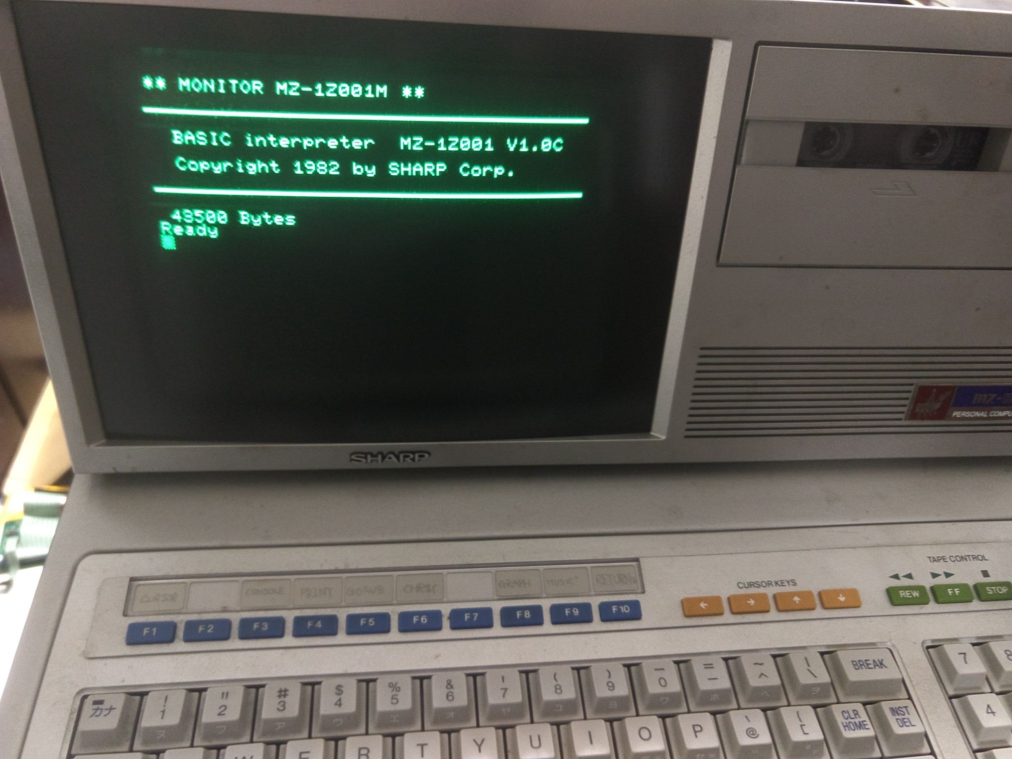
[picture p96: Doc/images/87.jpg]
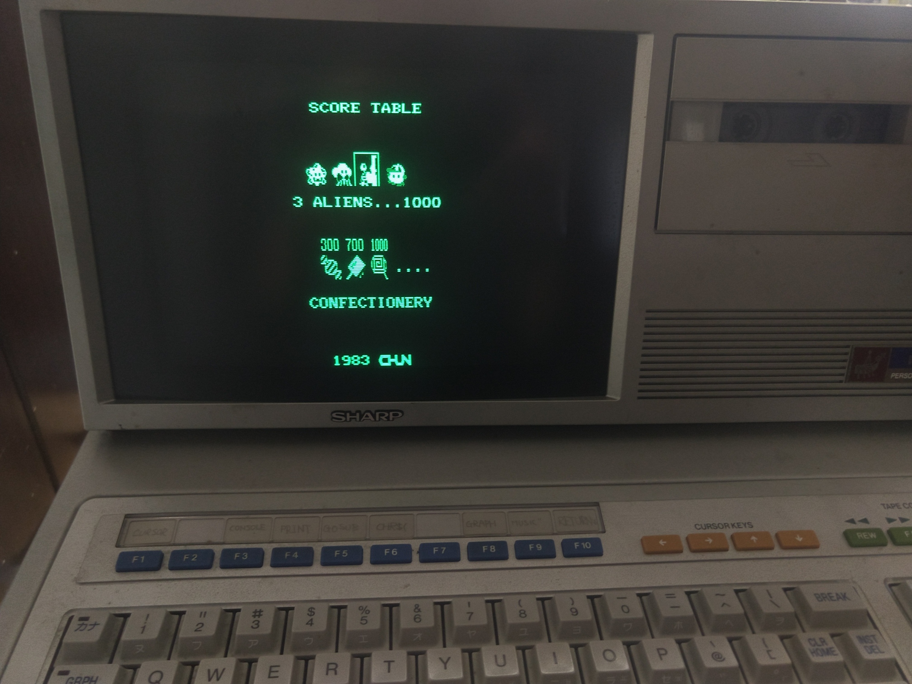
[picture p97: Doc/images/88.jpg]


上手く画面表示、動作するのであれば完成です。
お疲れ様でした。
