kitahei88/SKGC-for-MZ-80B/PCB_designspark/8255_smd/8255 - PCB.pdf

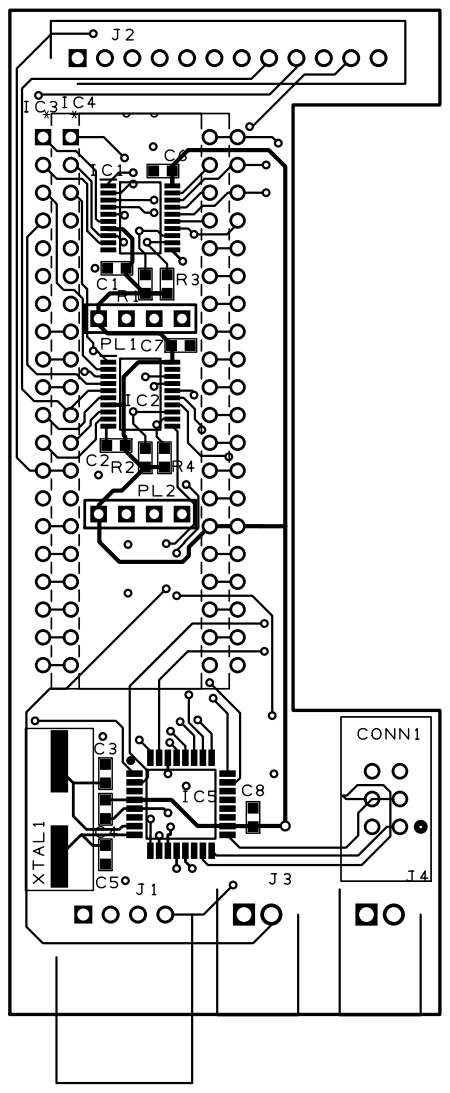
[picture p98: page 1]
