kitahei88/SKGC-for-MZ-80B/PCB_designspark/addressdecode_xilix/addressdecode0 - PCB.pdf

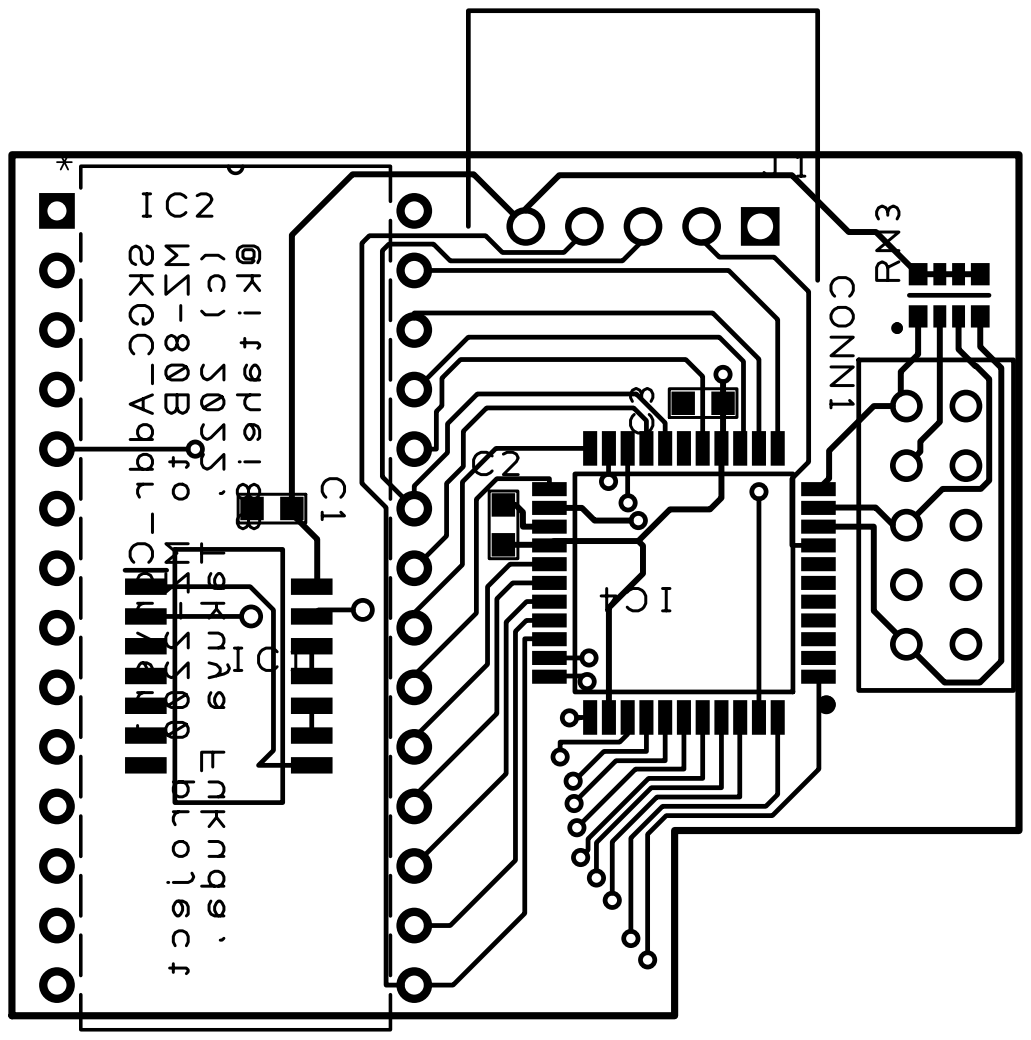
[picture p99: page 1]
