kitahei88/SKGC-for-MZ-80B/PCB_designspark/8255/pdf/8255cmt - Project.pdf

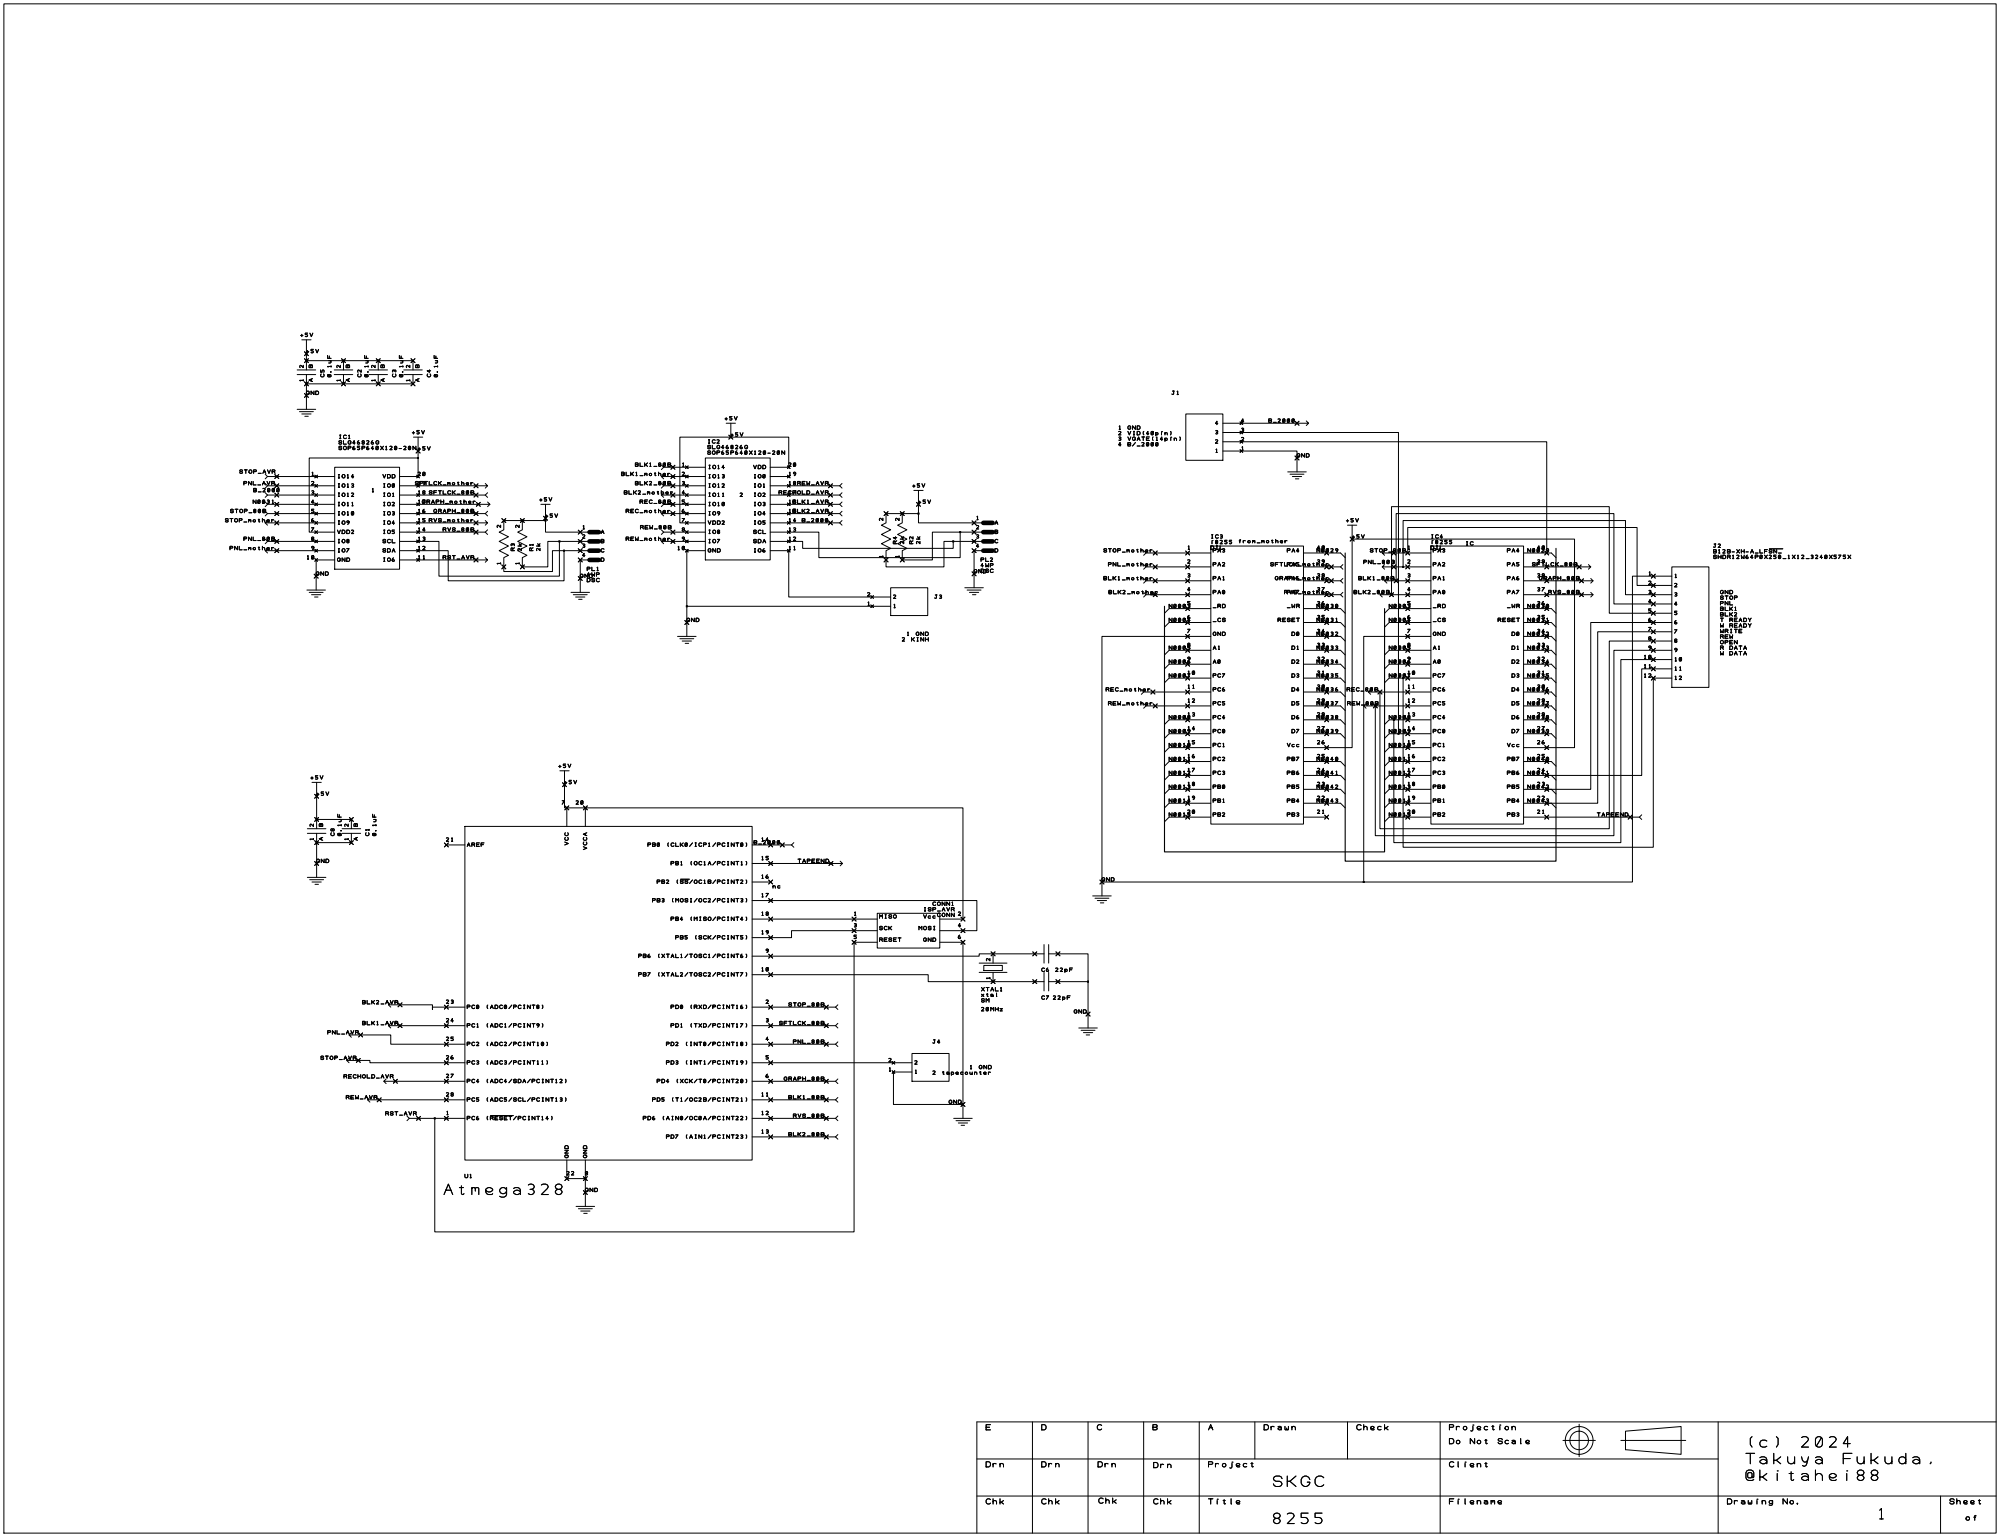
[picture p100: page 1]
