kitahei88/SKGC-for-MZ-80B/PCB_designspark/addressdecode/pdf/addressdecode0 - Project.pdf

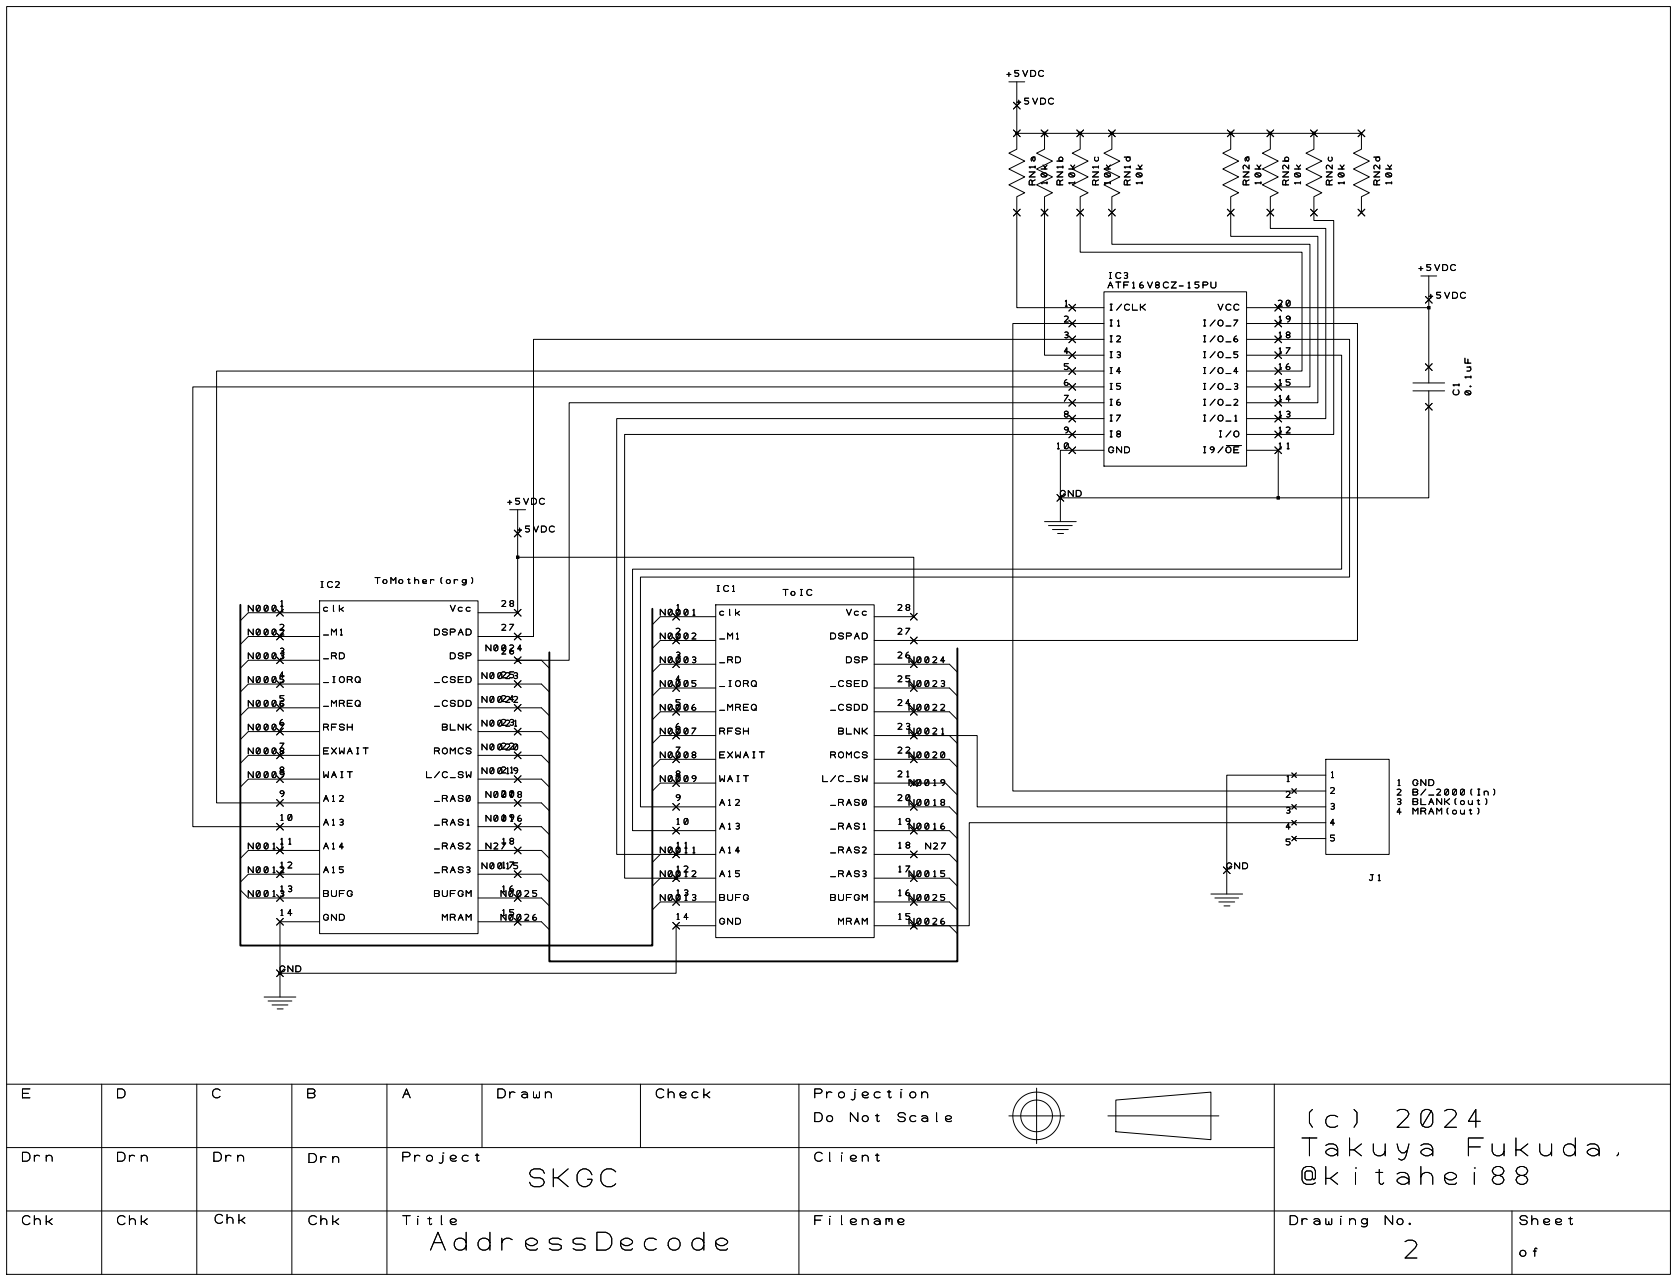
[picture p101: page 1]
