kitahei88/SKGC-for-MZ-80B/PCB_designspark/clk/pdf/clock - Project.pdf

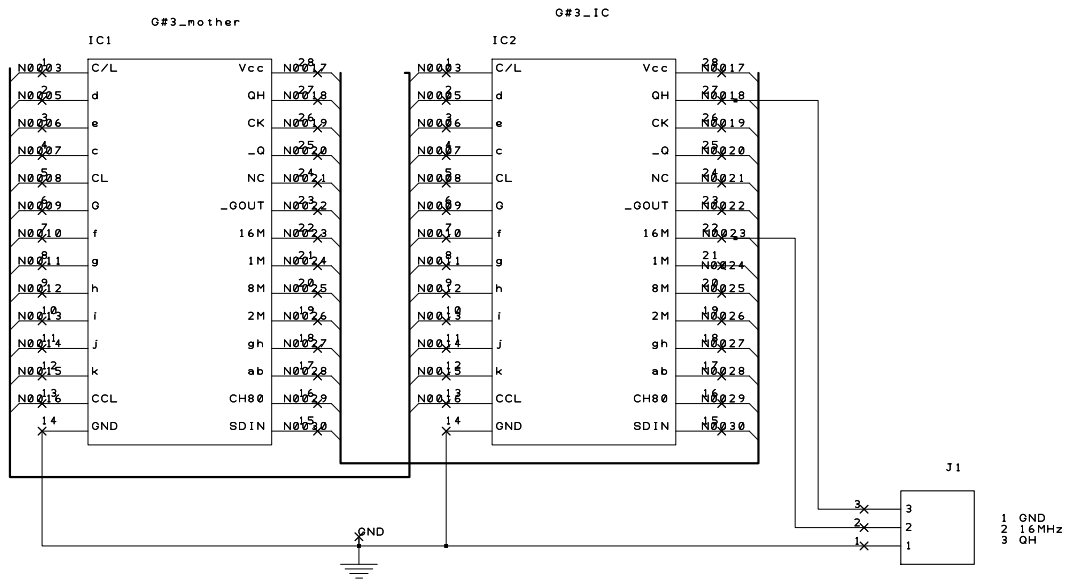
[picture p102: page 1]
