kitahei88/SKGC-for-MZ-80B/PCB_designspark/CN13/pdf/CN13 - Project.pdf

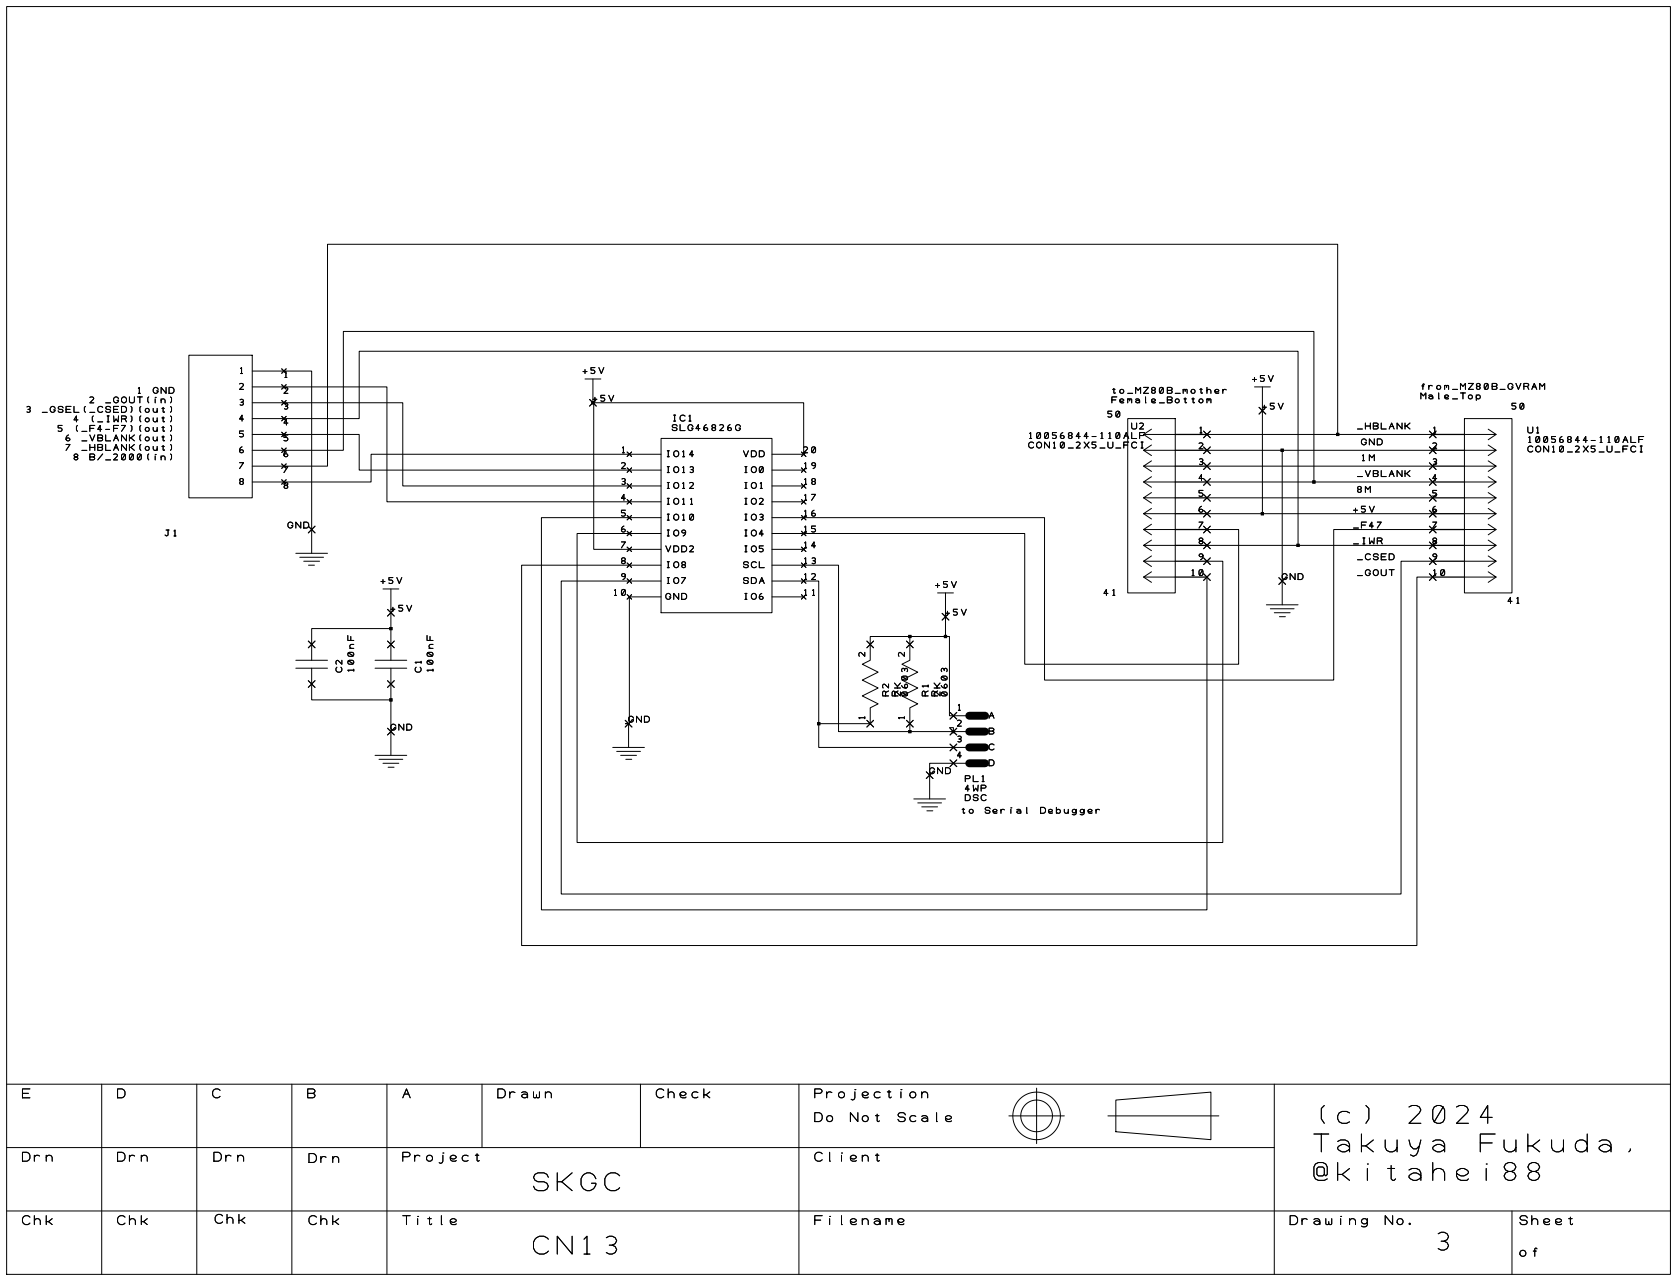
[picture p103: page 1]
