kitahei88/SKGC-for-MZ-80B/PCB_designspark/GVRAM/pdf/GVRAM4 - Project.pdf

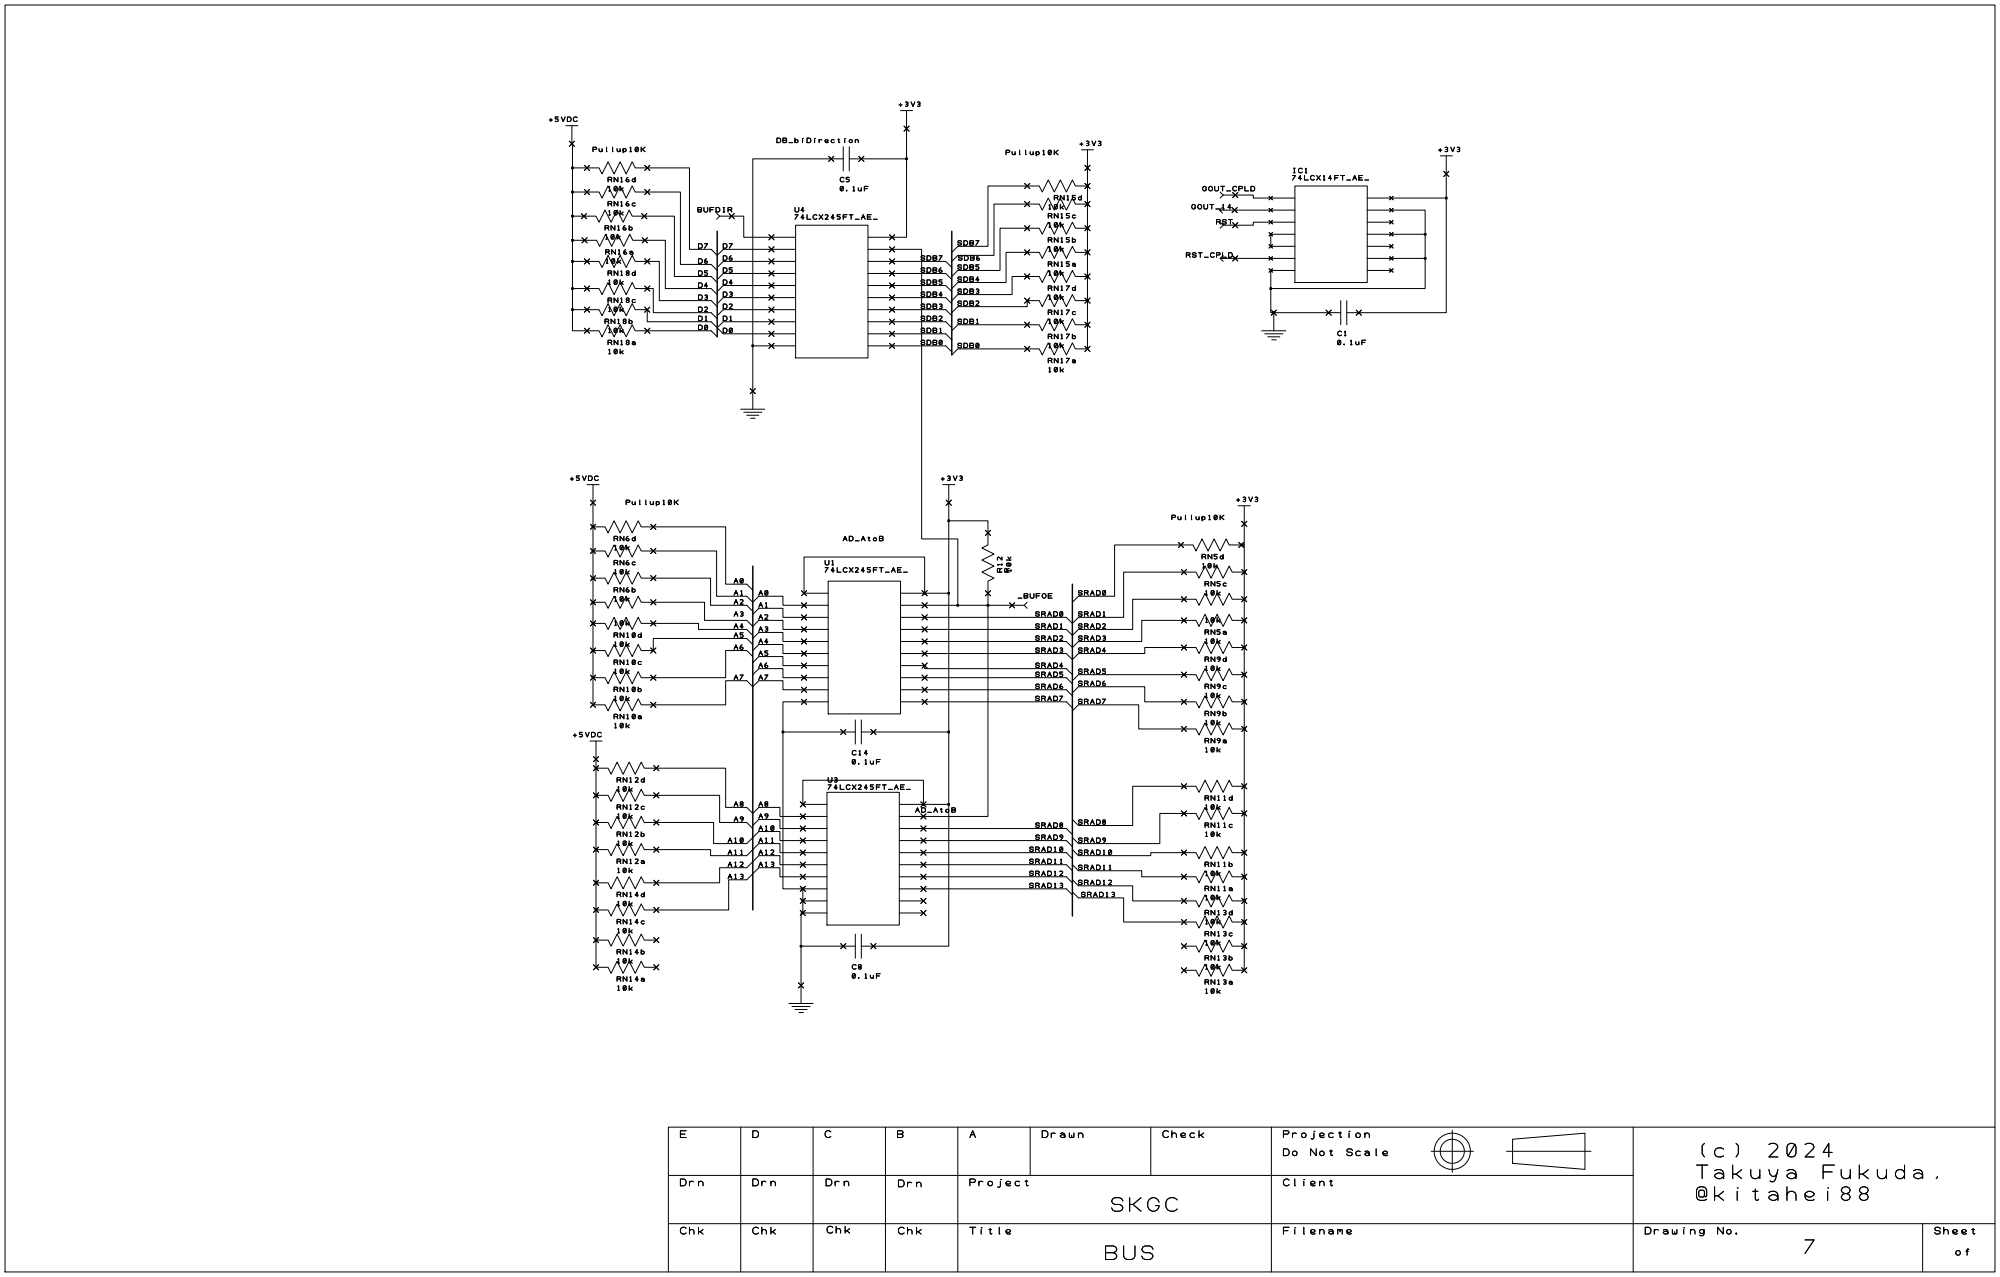
[picture p104: page 1]

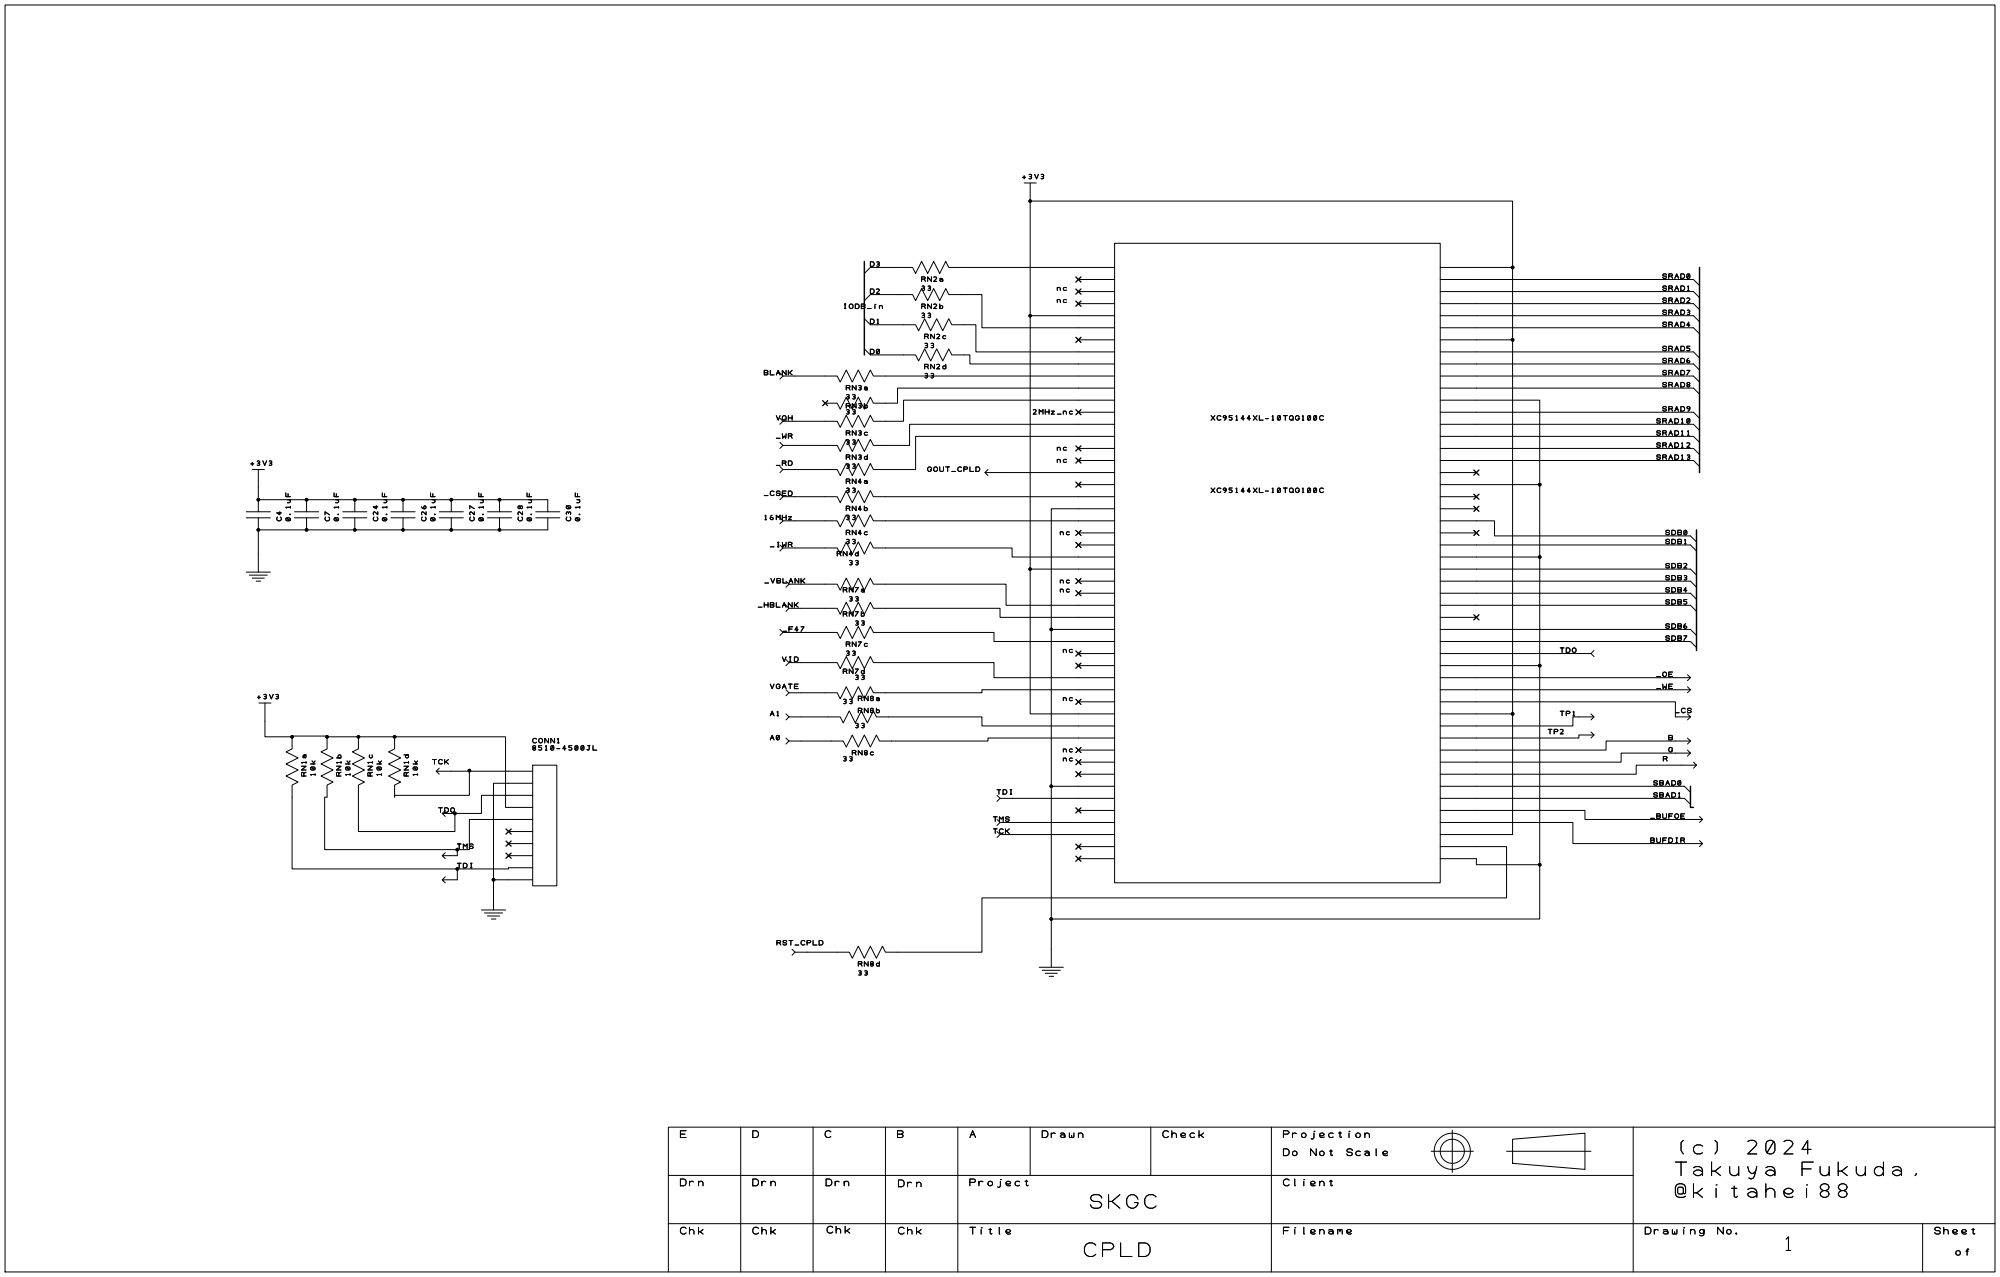
[picture p105: page 2]

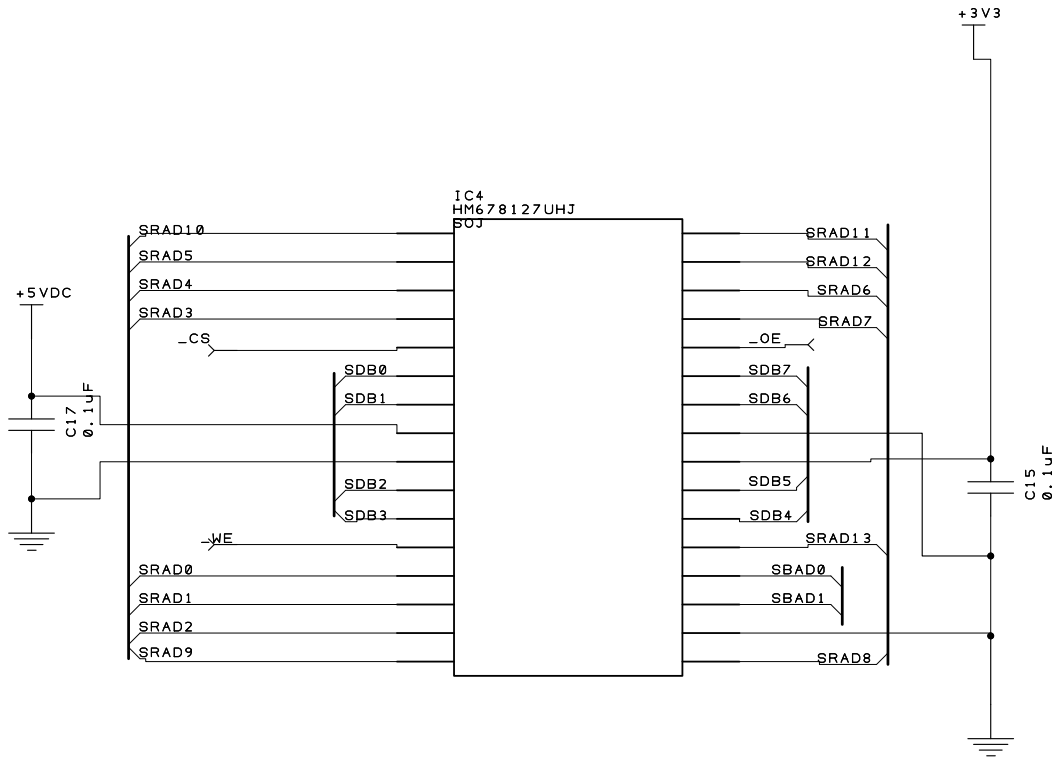
[picture p106: page 3]

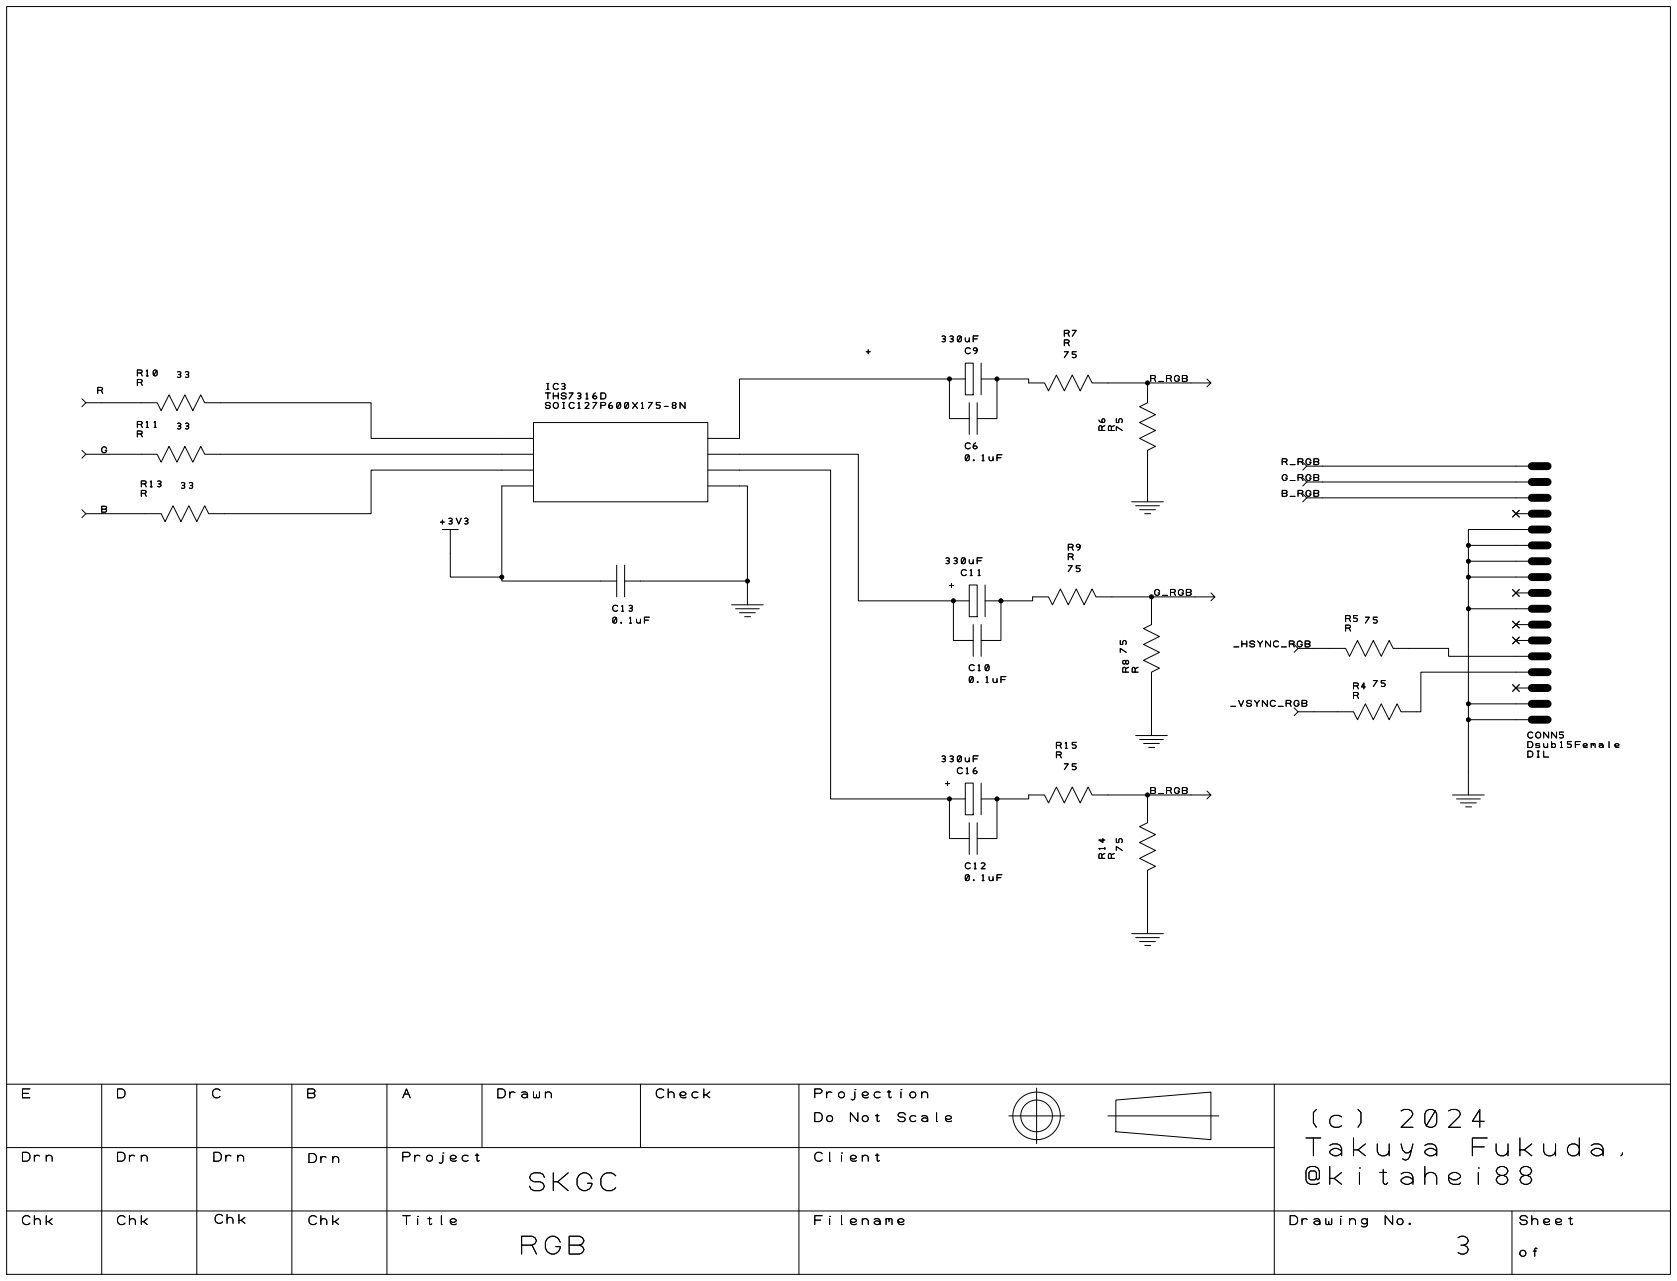
[picture p107: page 4]

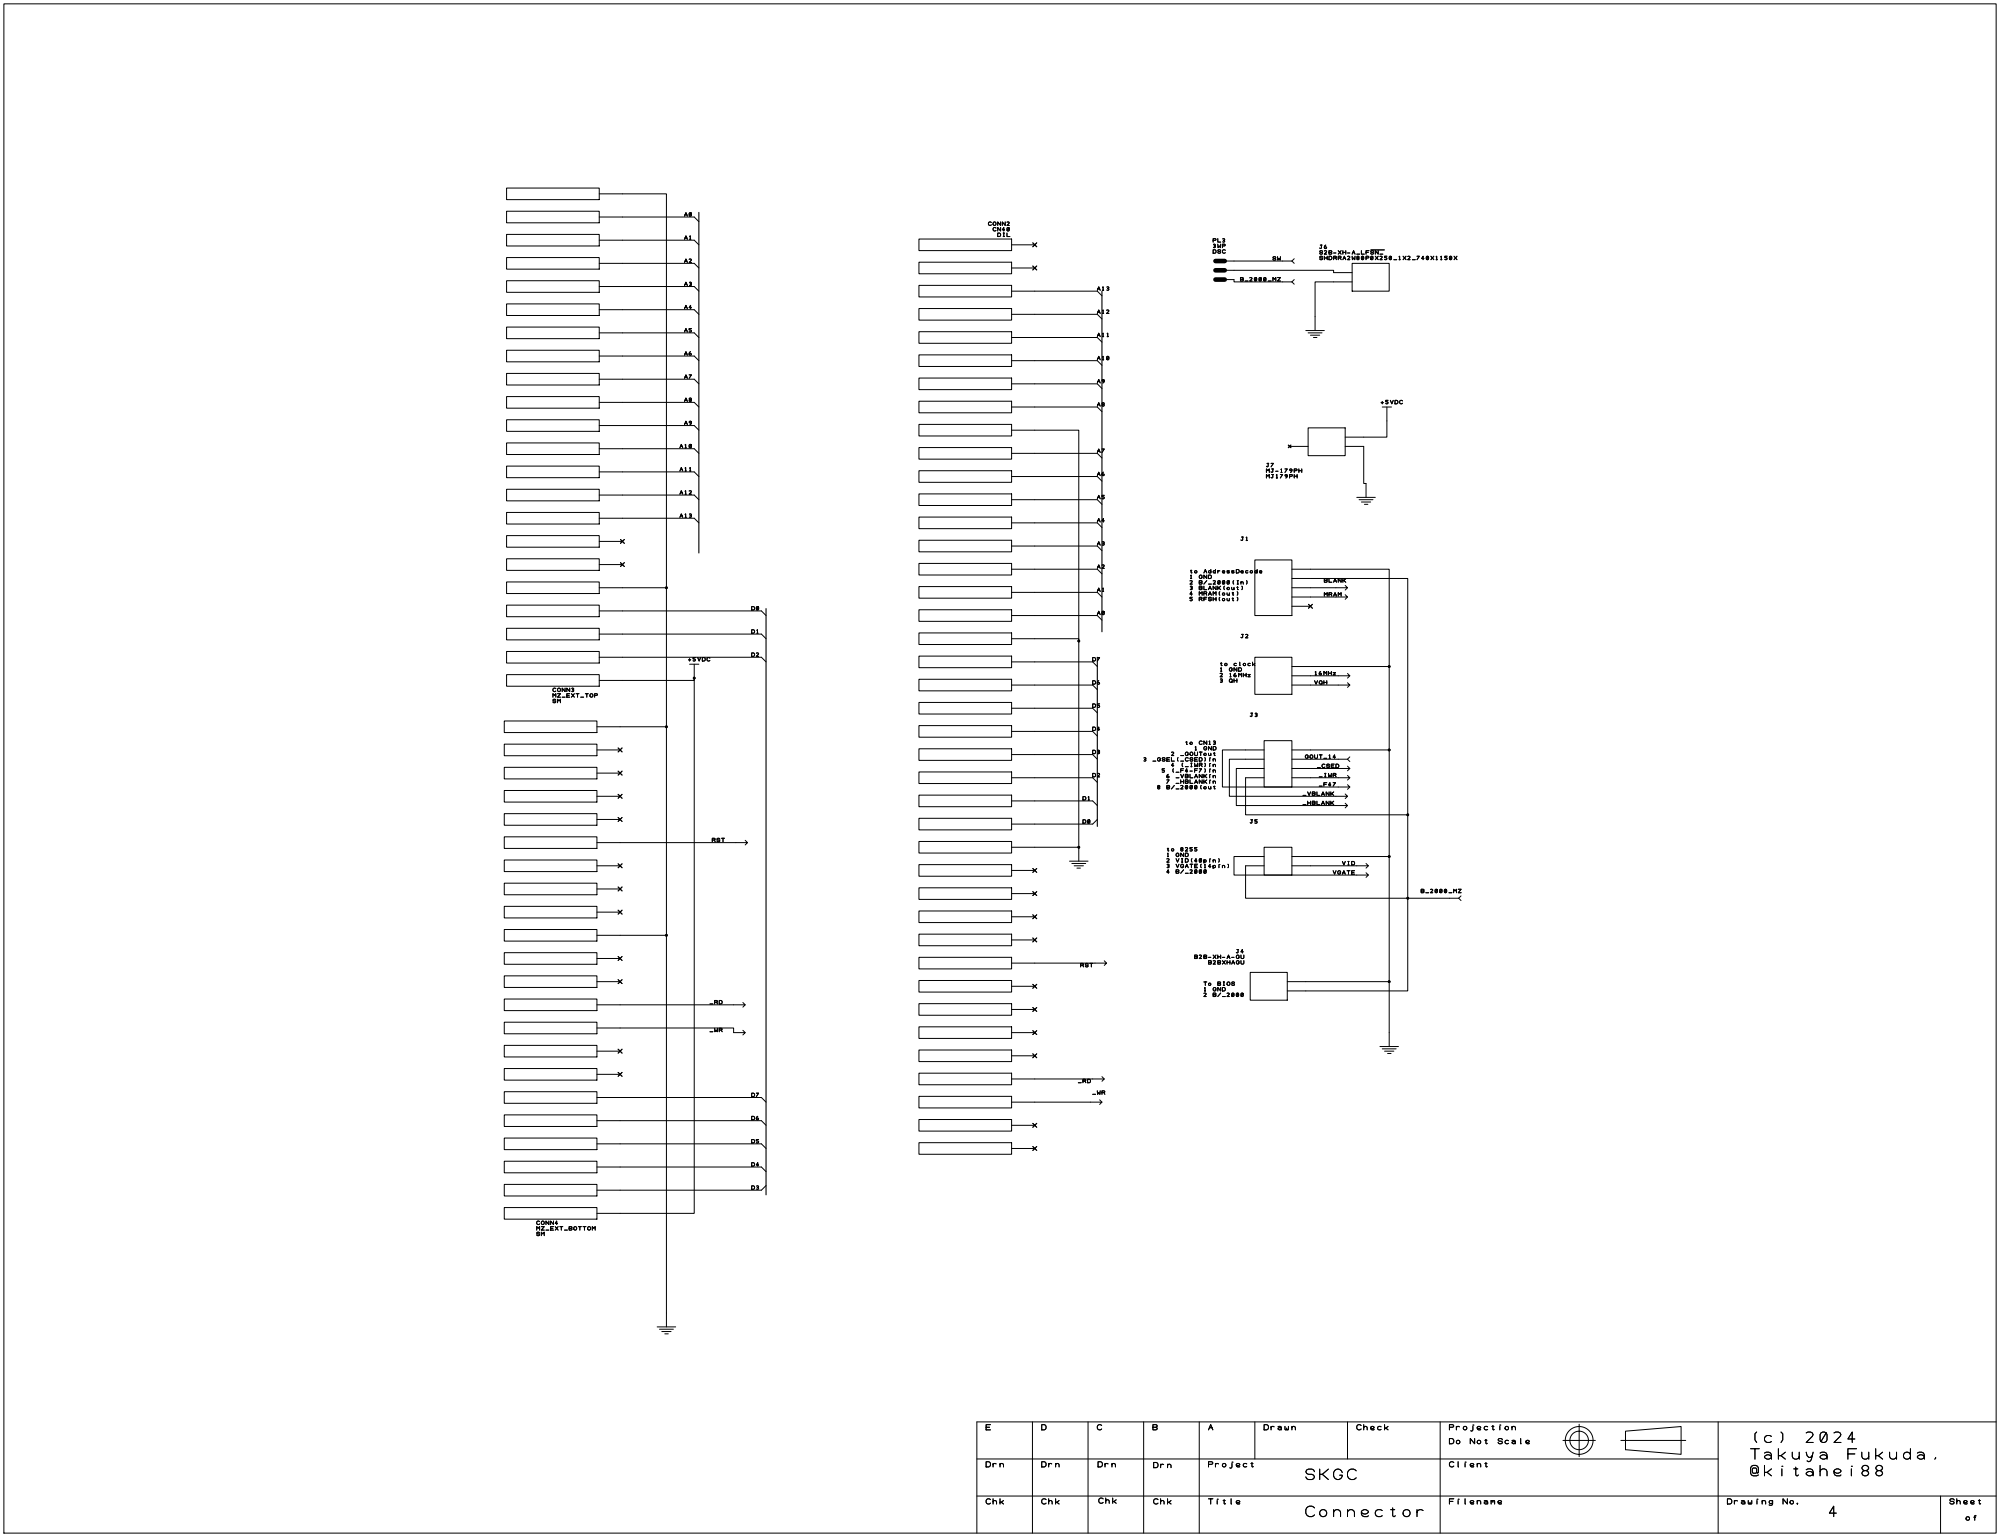
[picture p108: page 5]

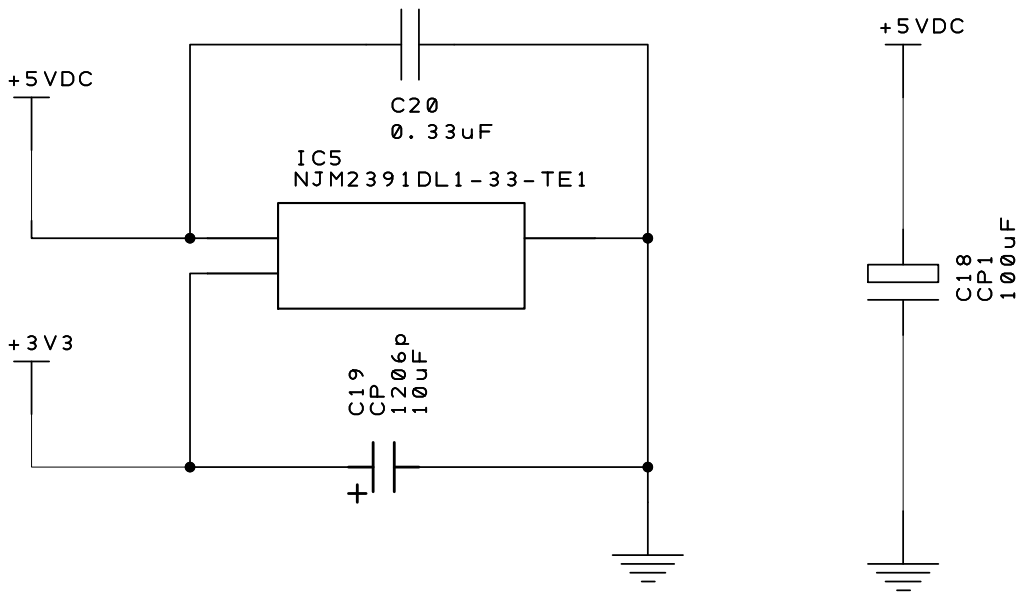
[picture p109: page 6]

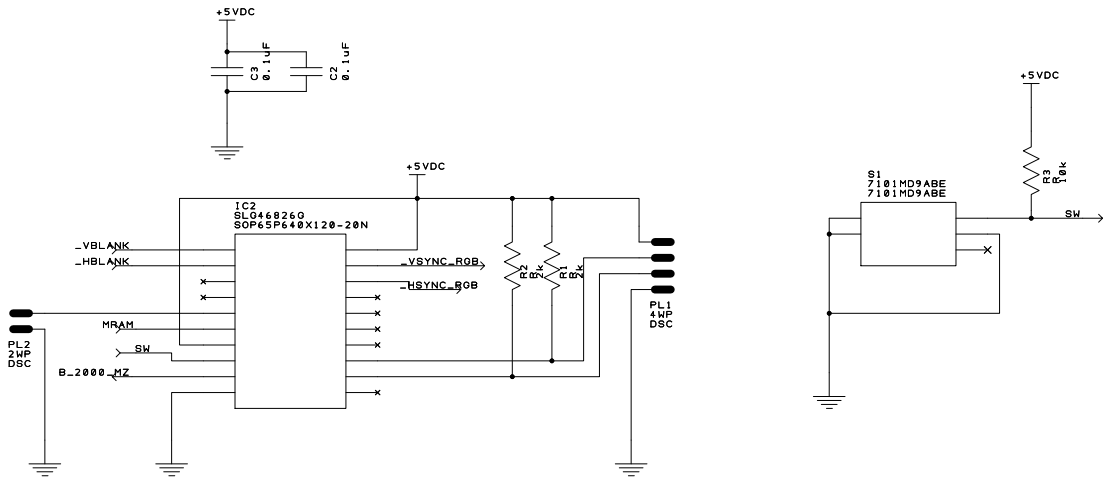
[picture p110: page 7]
