kitahei88/SKGC-for-MZ-80B/PCB_designspark/ipl/pdf/ipl - Project.pdf

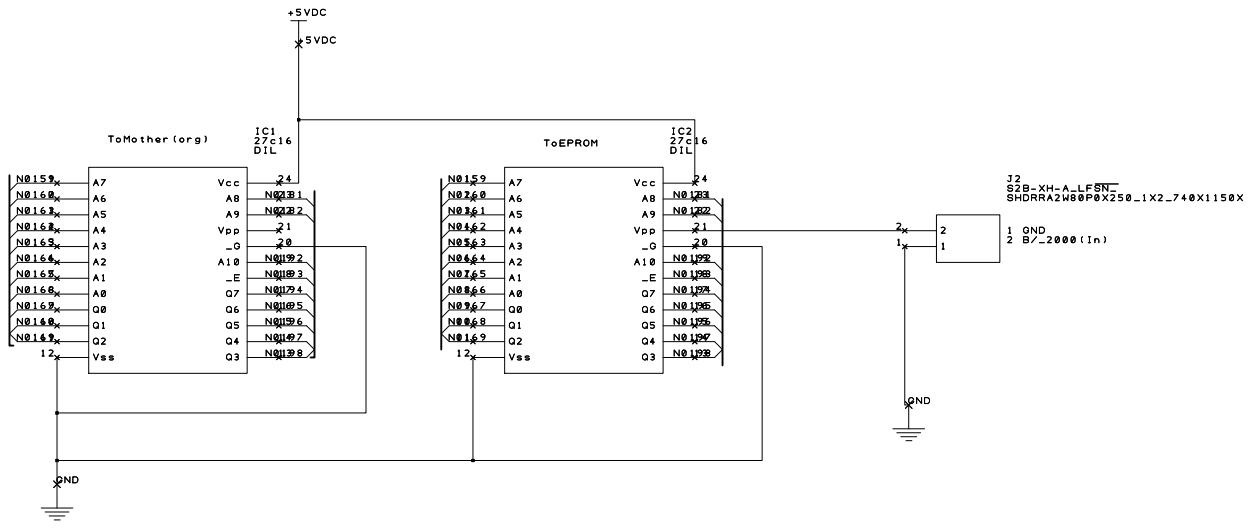
[picture p111: page 1]
