kitahei88/SKGC-for-MZ-80B/(list of files, drawings)

Other design files:
PCB_designspark/8255/8255.pcb
PCB_designspark/8255_smd/8255.pcb
PCB_designspark/8255_smd/~8255.pcb
PCB_designspark/addressdecode/addressdecode0.pcb
PCB_designspark/addressdecode_xilix/addressdecode0.pcb
PCB_designspark/addressdecode_xilix/~addressdecode0.pcb
PCB_designspark/clk/clock.pcb
PCB_designspark/CN13/CN13.pcb
PCB_designspark/GVRAM/GVRAM4.pcb
PCB_designspark/ipl/ipl.pcb
