kitahei88/SKGC-for-MZ-80B/(commit log)

2023-01-20 first upload
    [8255.pcb, 8255cmt.sch, BUS.sch, CN13.pcb, CN13.sch, CONN.sch, GVRAM4.pcb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]
2023-01-26 enable gitignore
    [MZGVRAM_pad.csv]
2023-01-26 modified: .gitignore new file: MZGVRAM_XC95144XL/MZGVRAM.prj new file: PCB_designspark/8255/8255.prj new file: PCB_designspark/CN13/CN13.prj new file: PCB_designspark/GVRAM/GVRAM4.prj new file: PCB_d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
2023-02-27 change pcb
    [BUS.sch, CONN.sch, GVRAM4.pcb, SRAM.sch]
2024-02-05 公開に向け編集
2024-02-06 atmega328へ
2025-07-19 G1 and 8255 smd
    [8255 - Bottom Copper.GBL, 8255 - Bottom Silkscreen.GBO, 8255 - Bottom Solder Mask.GBS, 8255 - Gerber Drill Data - [Through Hole].DRL, 8255 - NC Drill Data - [Through Hole].DRL, 8255 - Top Copper.GTL, 8255 - Top Silkscreen.GTO, 8255 - Top Solder Mask.GTS]
